TomNisbet/sap-plus/README.md

# SAP-Plus

A Simple As Possible (SAP) computer build using a modular PCB architecture.

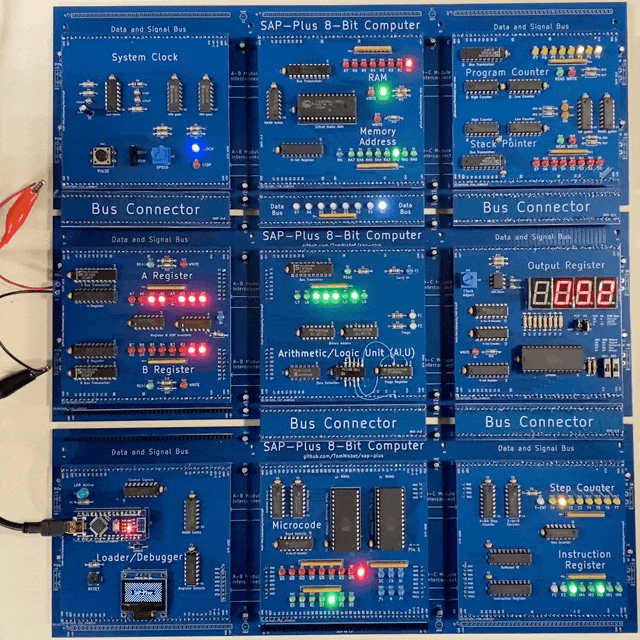
[picture p1: docs/assets/videos/sap-plus.gif]
SAP-Plus Boards SAP-Plus


Visit the [SAP-Plus documentation pages](https://tomnisbet.github.io/sap-plus/) for detailed design notes and schematics.
