TomNisbet/sap-plus/schematics/loader/README.md

# Arduino Loader and Debugger Module schematics

created with KiCad 8.0

## Changelog

### 1.2

* Change OLED power to 3.3V and add pullup resistors on SDA and SCL

### 1.1

* Fix U2 label to 7400 NAND, not 7408 AND
* Adjust OLED display footprint and position
* Add interconnect label to Microcode
* Change reset button from 6mm to 12mm size

### 1.0

* Initial version
