TomNisbet/sap-plus/schematics/template/README.md

# Module Template schematics

created with KiCad 8.0

The template project can be copied as a starting point to create a new module board. The blank template board can also be used for breadboard prototyping.

## Changelog

### 1.0

* Initial version
