TomNisbet/sap-plus/schematics/alu/README.md

# ALU Module schematics

created with KiCad 8.0

## Changelog

### 1.1

* Add FL LED
* Fix carry in LED polarity
* Fix non-inverted FL signal by replacing 3-inout AND with NAND, inverting zero-detect with second gate, and using the third to fix FL
* Add module interconnect labels to the A/B registers

### 1.0

* Initial version
