TomNisbet/sap-plus/schematics/ir-sc/README.md

# Instruction Register and Step Counter Module schematics

created with KiCad 8.0

## Changelog

### 1.1

* Add WRITE LED to Instruction Register
* Add N LED to Step Counter
* Add Module Interconnect labels

### 1.0

* Initial version
