TomNisbet/sap-plus/schematics/pc-sp/README.md

# Program Counter and Stack Pointer Module schematics

created with KiCad 8.0

## Changelog

### 1.1

* Add PI LED for Program Counter
* Fix mismatched datasheets references on schematic for U4

### 1.0

* Initial version
