TomNisbet/sap-plus/schematics/ab-register/README.md

# A and B Register Module schematics

created with KiCad 8.0

## Changelog

### 1.1

* Fix polarity of BI LED
* Add module interconnect labels
* Add BI text box

### 1.0

* Initial version
