TomNisbet/sap-plus/schematics/ram-mar/README.md

# RAM and Memory Address Register Module schematics

created with KiCad 8.0

## Changelog

### 1.1

* Update resistor network values to match LEDs

### 1.0

* Initial version
