TomNisbet/sap-plus/schematics/microcode/README.md

# Microcode Module schematics

created with KiCad 8.0

## Changelog

### 1.1

* Add labels module interconnect headers

### 1.0

* Initial version
