TomNisbet/sap-plus/schematics/output/README.md

# Output Register Module schematics

created with KiCad 8.0

## Changelog

### 1.0

* Initial version
