TomNisbet/sap-plus/schematics/backplane/README.md

# Backplane schematics

created with KiCad 8.0

## Changelog

### 1.1

* Add barrel connector for power in
* Rotate C1, C2, C8 for consistent orientation

### 1.0

* Initial version
