TomNisbet/sap-plus/schematics/bus-connect/README.md

# Bus Connector schematics

created with KiCad 8.0

## Changelog

### 1.0

* Initial version
