TomNisbet/sap-plus/schematics/bus-leds/README.md

# Bus Connector with LEDs schematics

created with KiCad 8.0

## Changelog

### 1.0

* Initial version
