TomNisbet/sap-plus/schematics/memory-loader-interface/README.md

# Module Template schematics

created with KiCad 8.0

## Changelog

### 1.0

* Initial version
