TomNisbet/sap-plus/docs/_docs/design-400-ir-sc.md

---
title: "Instruction Register and Step Counter"
permalink: /docs/ir-sc/
excerpt: "Instruction Register and Step Counter for the SAP-Plus computer"
---

The Instruction Register (IR) and Step Counter (SC) provide a 12-bit address for the microcode ROMs.  The MA0..MA11 bits are carried on the Interconnect Bus, so the Microcode Module and IR-SC Module must be placed in adjacent backplane slots.

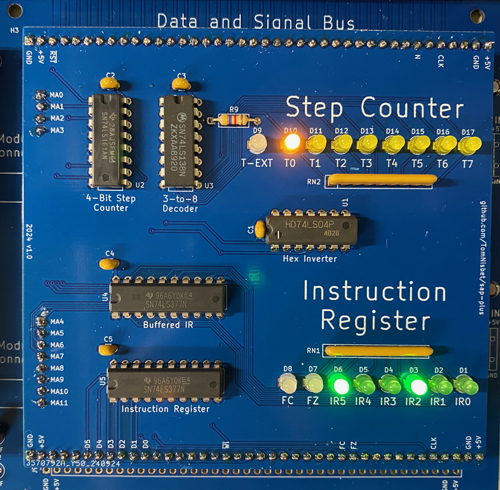
[picture p25: docs/assets/images/ir-sc-module-small.png]
Instruction Register and Step Counter


## Step Counter

The Microcode Step Counter (SC) is a 4-bit binary microinstruction step counter that provides the A0..A3 addresses for the Microcode ROMs.  It counts on the falling edge of every _CLK_ signal.

The SC has an attached 3-to-8 decoder to drive the LED display that indicates the step as T0..T7.  This is easier to follow than a simple binary display using four LEDs.

With a 4-bit counter, an instruction can have as many as sixteen steps, but most have fewer than eight.  Because the higher steps aren't typically used, there is just a single T_EXT LED to indicate that steps T8..T15 are active.  Step T8 is indicated by T-EXT and T0, step T9 by T-EXT and T1, and so on.

### Step Counter implementation and reset

The Step Counter is implemented using a 74LS161 4-bit counter.  This counter can be reset in two ways.  The SAP-Plus _RST_ signal is connected to the reset signal of the counter.  This provides an asychronous reset of the SC whenever _RST_ is pulled low.  This reset does not depend on the _CLK_ signal.  Holding _RST_ low will not only reset the counter, it will also prevent counting until the _RST_ is released.  The Loader uses this to prevent counting during the system self test.

Because most instructions will have fewer than 16 steps, the _N_ signal from the microcode can be used to end an instruction without executing all sixteen microinstruction steps.  The _N_ signal is tied to the 74LS161's Parallel Enable (_PE_) pin and the data inputs are all tied to _GND_.  When _N_ is asserted, the SC will load all zeroes from its data inputs, effectively doing a synchronous reset on the next falling _CLK_ edge.  Instructions with fewer than 16 steps include the _N_ bit in their final microcode step.

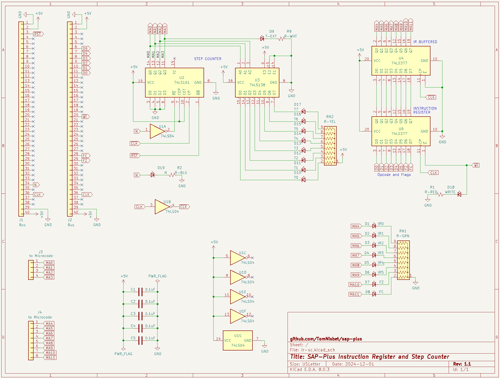
[picture p26: docs/assets/images/ir-sc-schematic-small.png]
Instruction Register and Step Counter schematic


## Instruction Register

The Instruction Register (IR) is an 8-bit, write-only register that loads on the WI signal.  Bits IR0..IR5 are connected to D0..D5 on the data bus, allowing a 6-bit opcode to be loaded from RAM.  This provides 64 unique opcodes.  Bits IR6 and IR7 are connected to the FZ and FC signals from the Flags Register on the ALU Module.  

**NOTE:** The contents of the Flags Register are not moved to the IR until the start of a new instruction, so an instruction's microcode cannot alter its behavior based on the content of a Flags Register that is changed in an earlier microinstruction step.
{: .notice--info}

The IR does not start with a known value after power-up or reset, so the first opcode executed is not deterministic.  This is not a problem, because the first two microinstruction steps of all instructions are identical.  The first step (T0) loads the PC value into the MAR.  The PC is cleared after reset, so the value placed into the MAR will always be zero after reset.  The second microinstruction step (T1) reads the opcode from RAM at adress zero and writes it into the IR.  The IR now has the correct opcode value for the first instruction, so the third microinstruction step (T2) will be executing the correct microcode.

### double buffering

The Instruction Register is double buffered to reduce [glitches when the EEPROM address lines change](../eeprom-glitch/).  In the non-buffered design, the EEPROM outputs will be in an unknown state for about 100ns when the Step Counter address changes on every falling edge of the system clock.  In addition, the outputs will also glitch on the rising edge of the clock at microinstruction step T1 when the IR is loaded with the new opcode.  In a traditional SAP design, the outputs would also glitch on any rising clock edge that changes the Flags Register contents.

The double buffer in SAP-Plus is a second register following the IR register.  The IR loads at the rising CLK edge of every T1 microinstruction step.  The second register loads the contents of the IR and presents them to the ROM address lines on every falling edge.  As a result, the EEPROM address lines only ever change on a falling clock edge, allowing logic that combines ROM signals with a positive clock signal.  Because the two flags register bits are fed through the IR, this also restricts the flag bit changes to the falling clock edge.
