TomNisbet/sap-plus/docs/assets/images/backplane-schematic-small.png

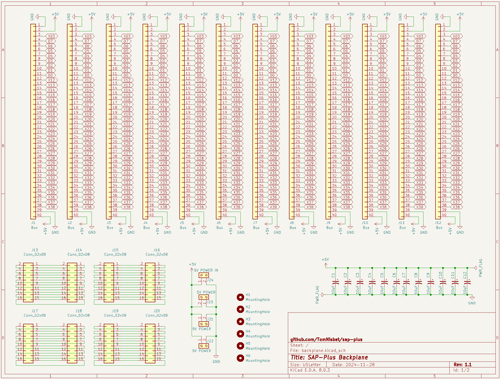
docs/assets/images/backplane-schematic-small.png
