TomNisbet/sap-plus/docs/assets/images/board-box.jpg

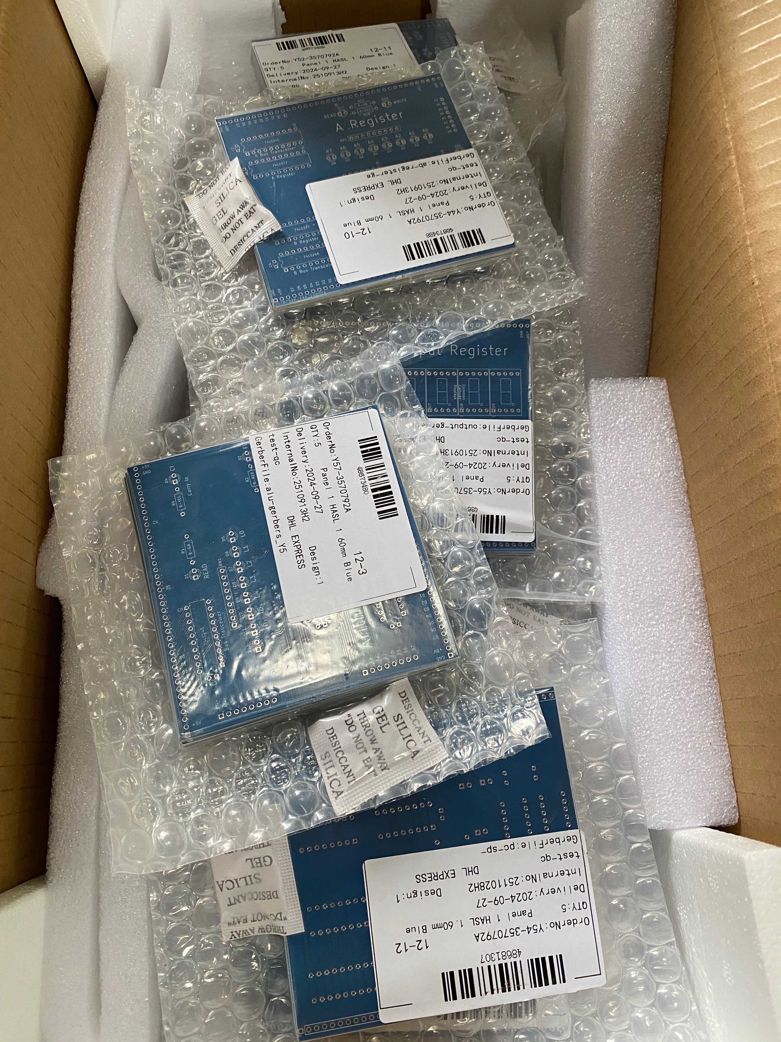
docs/assets/images/board-box.jpg
