TomNisbet/sap-plus/docs/assets/images/boards1.jpg

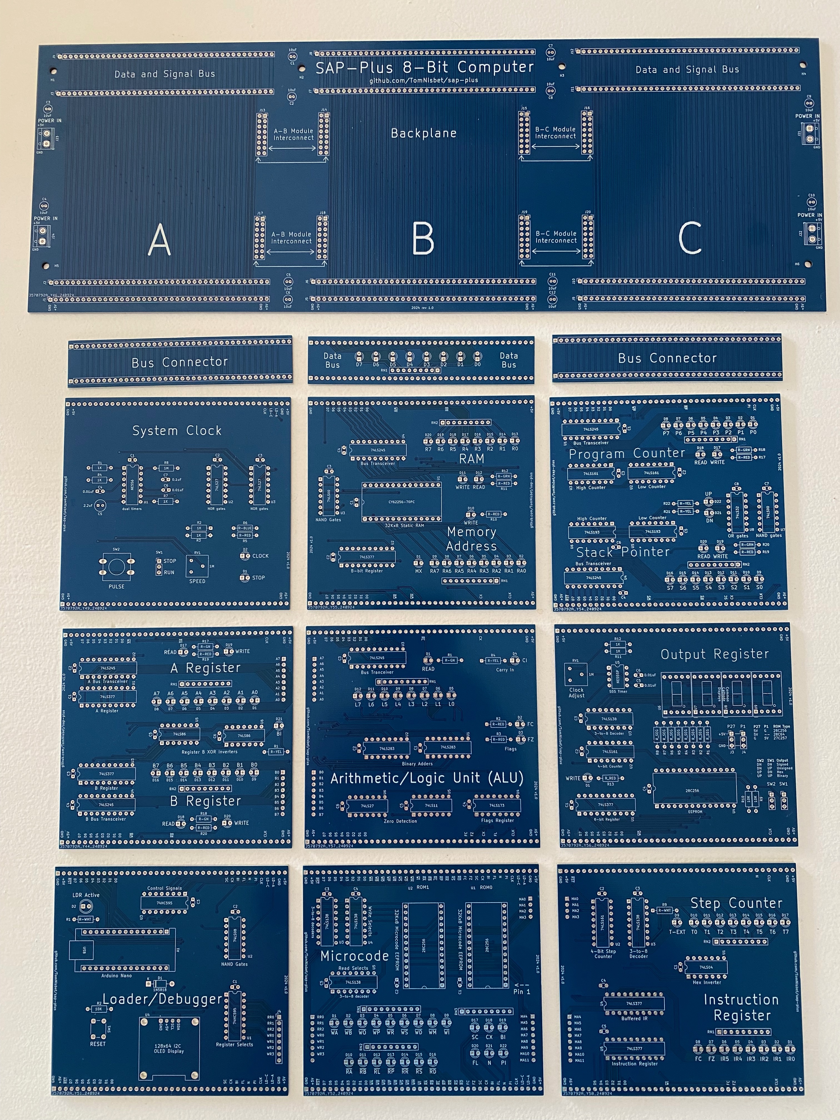
docs/assets/images/boards1.jpg
