TomNisbet/sap-plus/docs/assets/images/clock-module-small.png

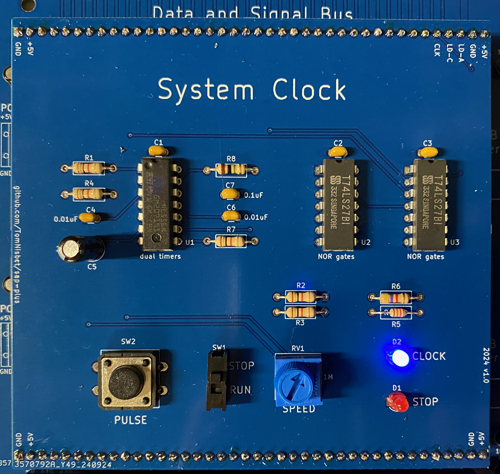
docs/assets/images/clock-module-small.png
