TomNisbet/sap-plus/docs/assets/images/clock-schematic-small.png

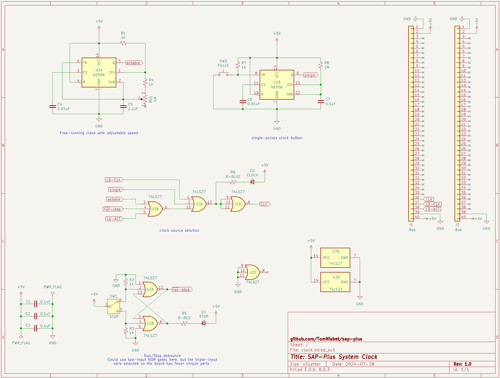
docs/assets/images/clock-schematic-small.png
