TomNisbet/sap-plus/docs/assets/images/loader-module-small.png

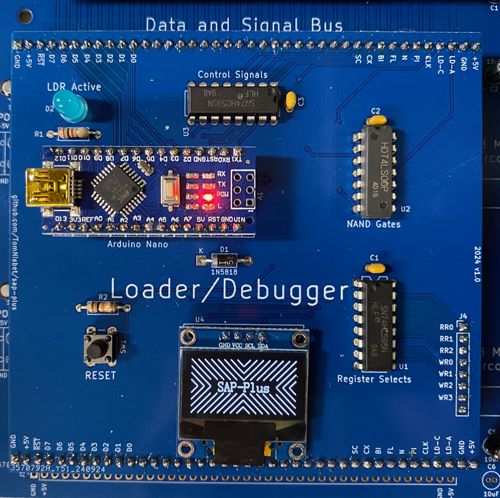
docs/assets/images/loader-module-small.png
