TomNisbet/sap-plus/docs/assets/images/loader-schematic-small.png

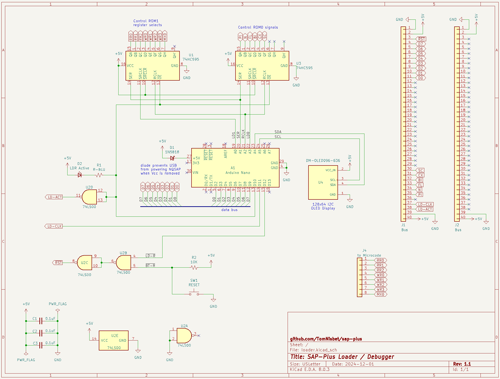
docs/assets/images/loader-schematic-small.png
