TomNisbet/sap-plus/docs/assets/images/logic-clk2-worst.png

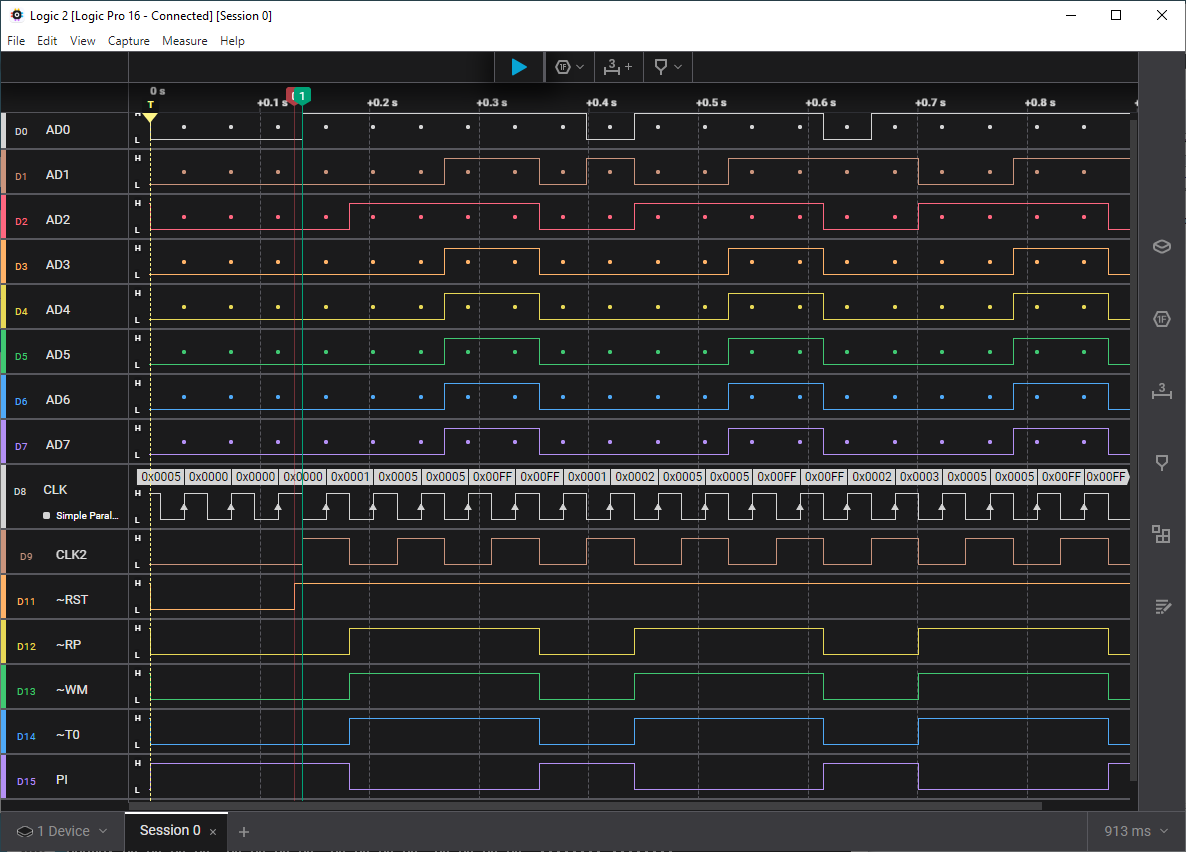
docs/assets/images/logic-clk2-worst.png
