TomNisbet/sap-plus/docs/assets/images/memory-loader-module-small.jpg

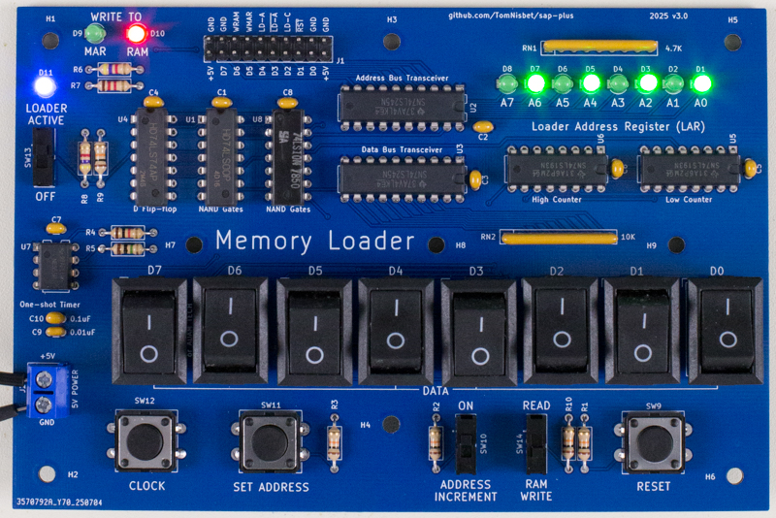
docs/assets/images/memory-loader-module-small.jpg
