TomNisbet/sap-plus/docs/assets/images/oops.jpeg

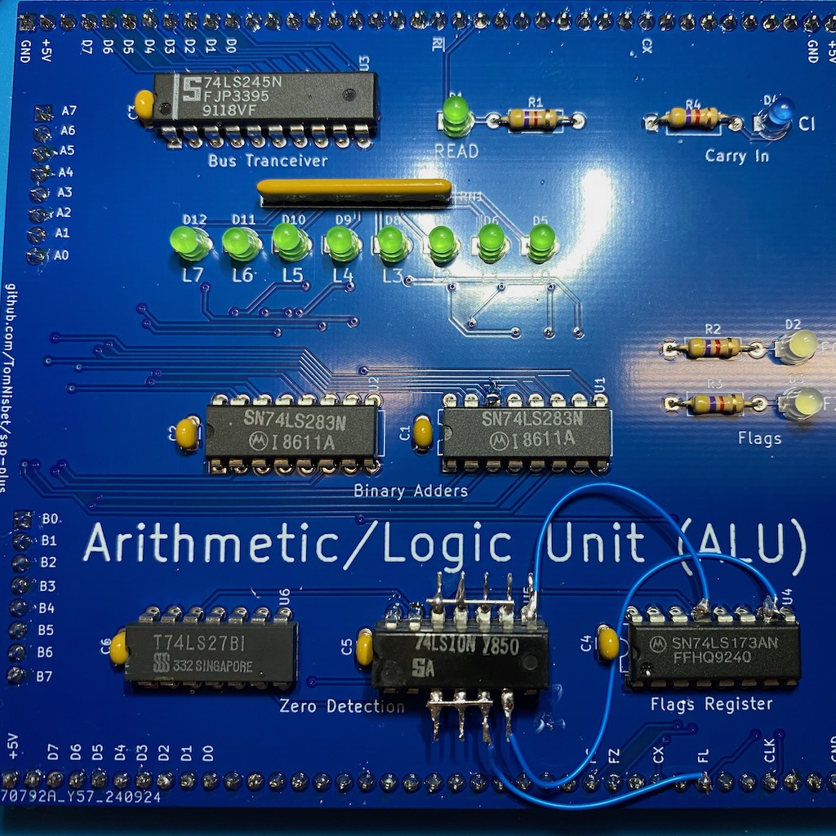
docs/assets/images/oops.jpeg
