TomNisbet/sap-plus/docs/assets/images/output-module-small.png

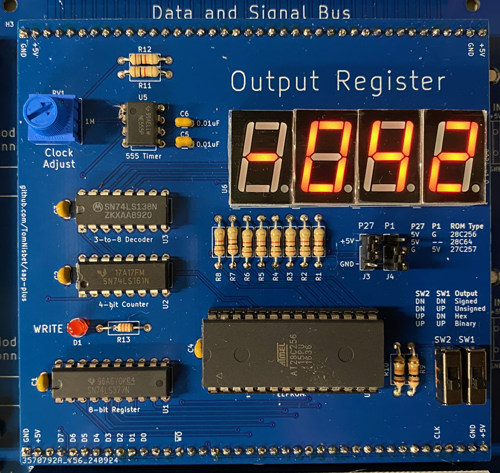
docs/assets/images/output-module-small.png
