TomNisbet/sap-plus/docs/assets/images/output-schematic-small.png

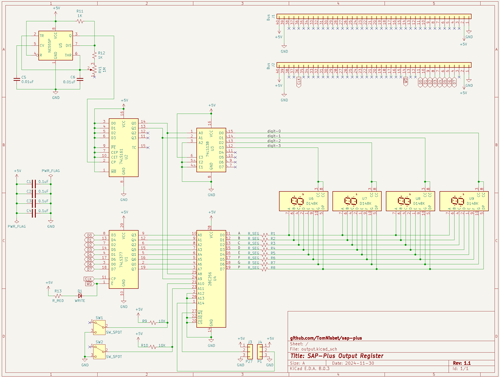
docs/assets/images/output-schematic-small.png
