TomNisbet/sap-plus/docs/assets/images/template-pcb-small.png

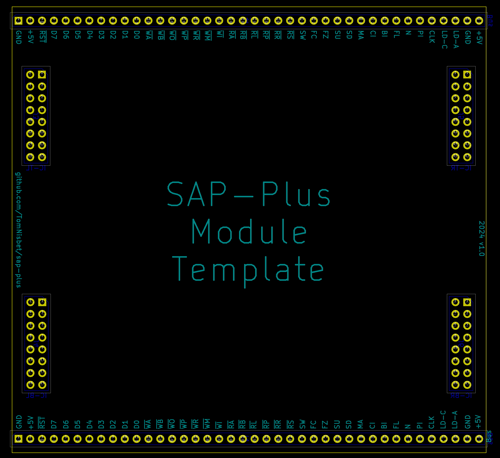
docs/assets/images/template-pcb-small.png
