TomNisbet/sap-plus/docs/assets/images/template-pins-small.png

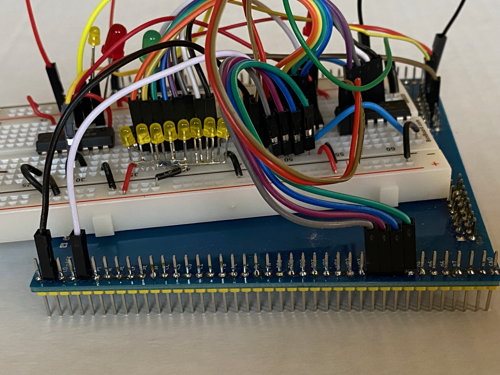
docs/assets/images/template-pins-small.png
