TomNisbet/sap-plus/docs/assets/images/template-prototype-small.png

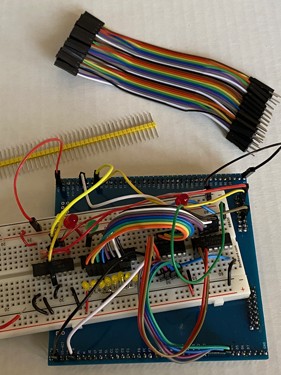
docs/assets/images/template-prototype-small.png
