TomNisbet/sap-plus/docs/assets/images/template-schematic-small.png

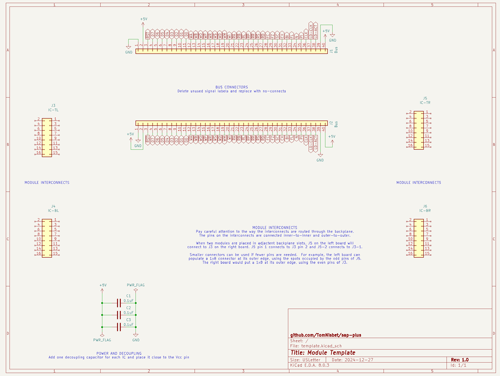
docs/assets/images/template-schematic-small.png
