TomNisbet/sap-plus/docs/assets/images/timing-clk2-low2.png

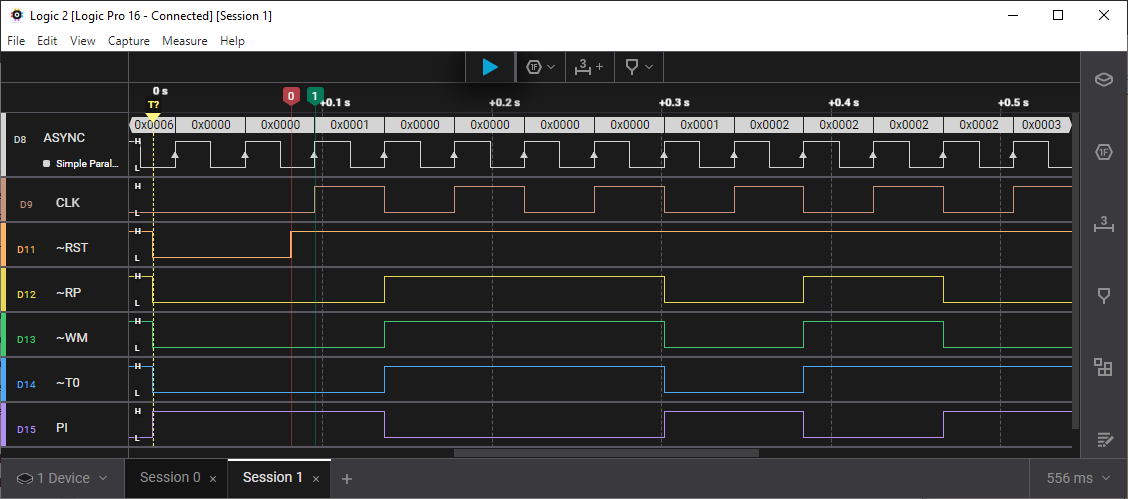
docs/assets/images/timing-clk2-low2.png
