TomNisbet/sap-plus/docs/assets/images/memory-loader-components-small.jpg

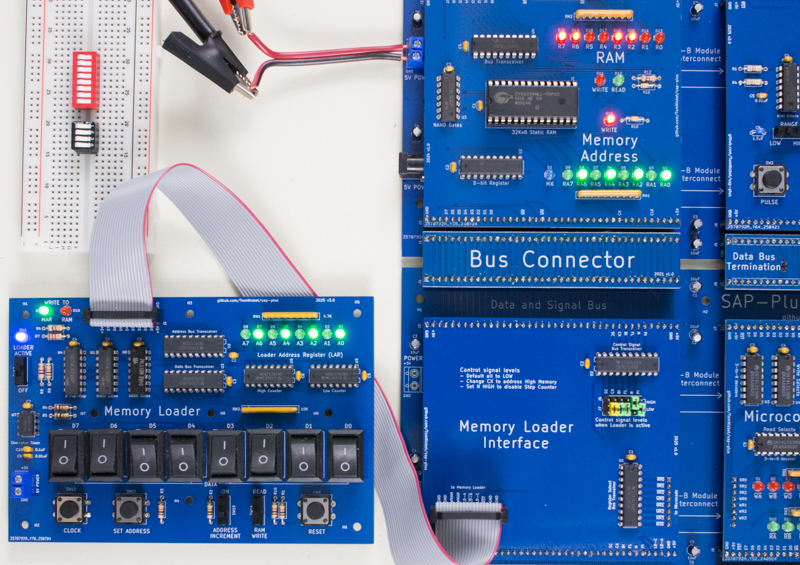
docs/assets/images/memory-loader-components-small.jpg
