TomNisbet/sap-plus/schematics/loader/loader.kicad_pcb

## KiCad design schematics/loader/loader.kicad_pcb (2025-07-20)

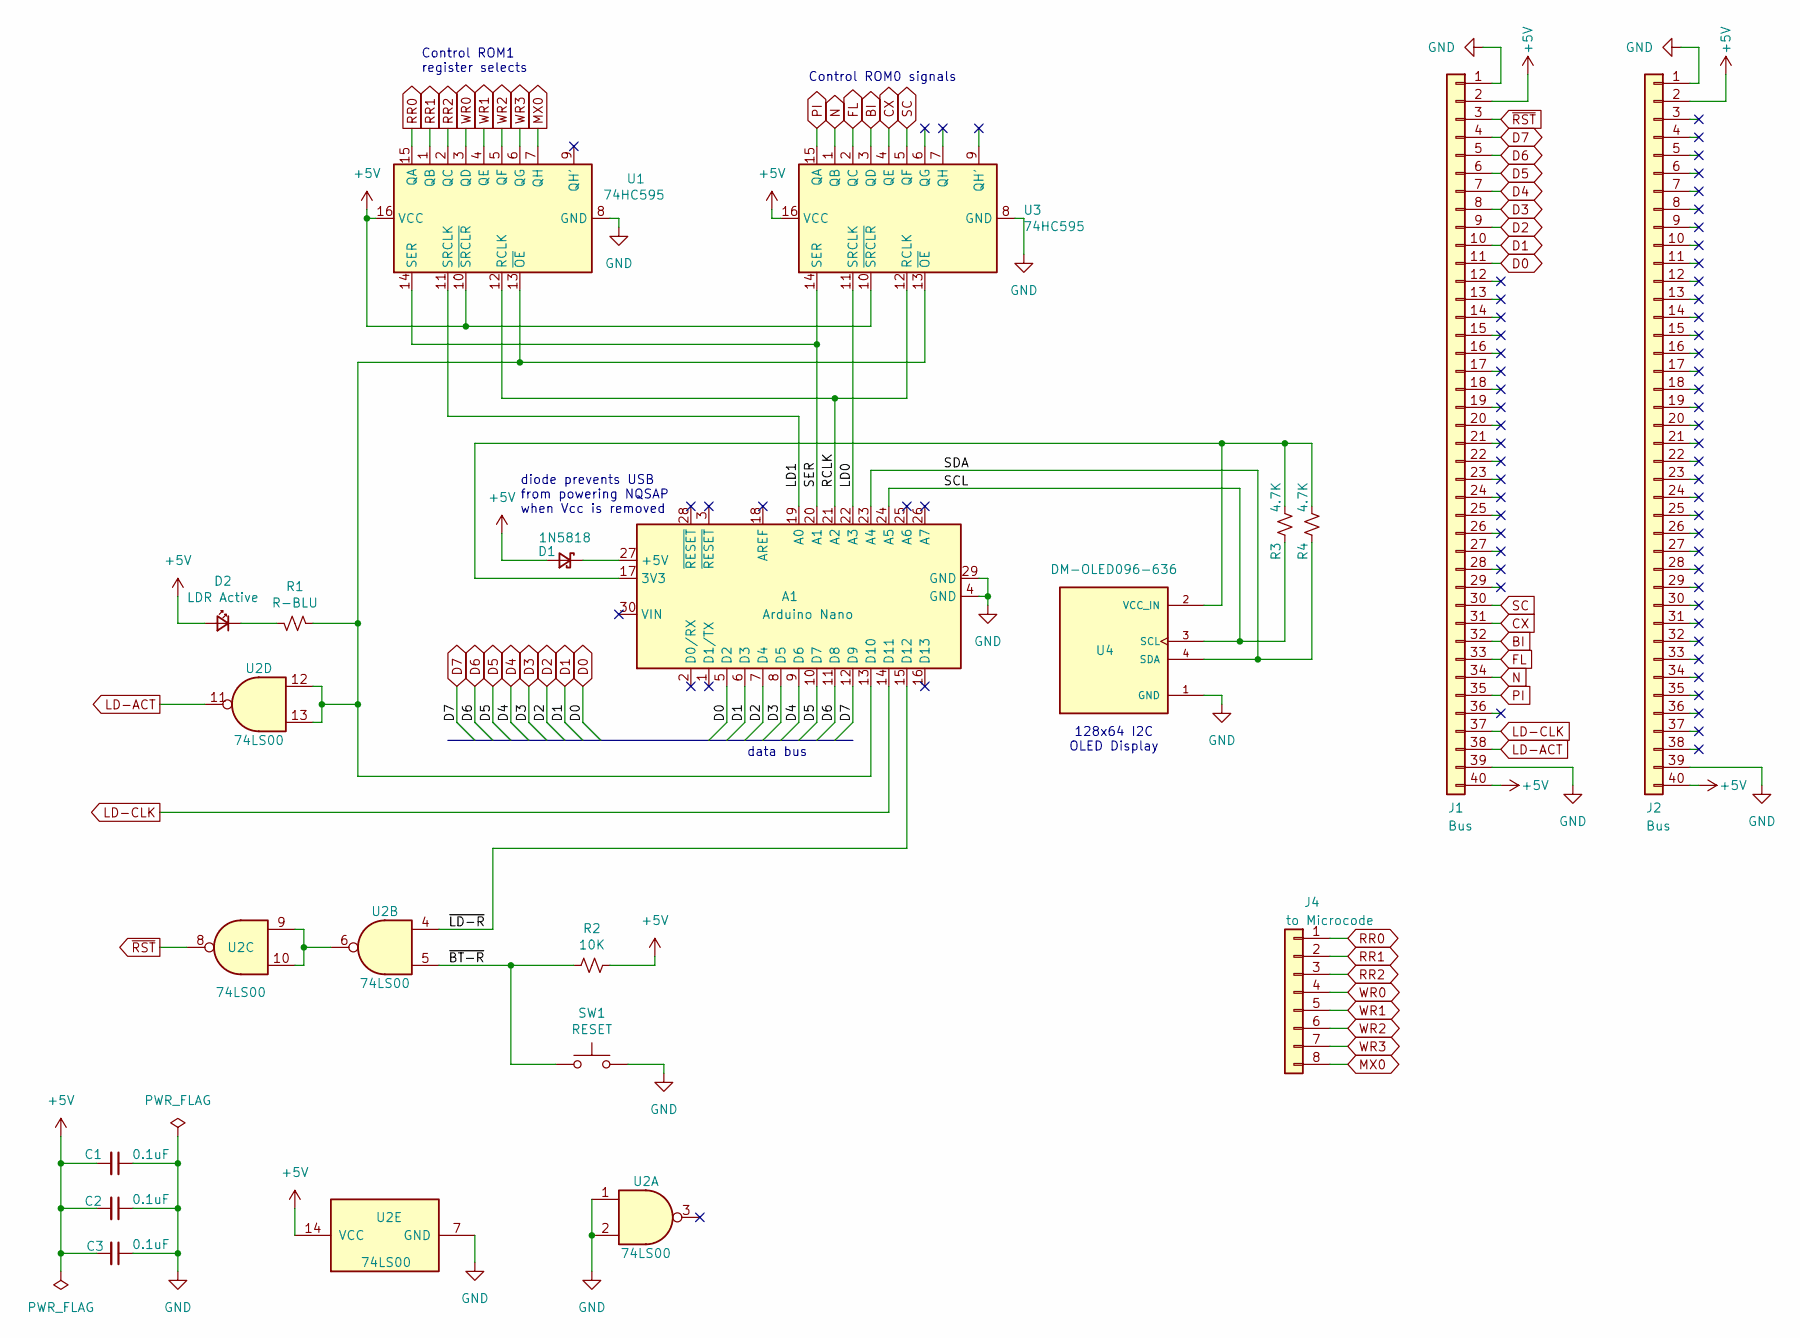
[picture p55: schematic loader.kicad_sch, SAP-Plus Loader / Debugger]

Parts:
A1: Arduino Nano; Arduino_Nano
C1, C2, C3: 0.1uF; C_Disc_D3.0mm_W1.6mm_P2.50mm
D1: 1N5818; D_DO-41_SOD81_P10.16mm_Horizontal
D2: LDR Active; LED_D5.0mm
J1, J2: Bus; PinHeader_1x40_P2.54mm_Vertical
J4: to Microcode; PinHeader_1x08_P2.54mm_Vertical
R1: R-BLU; R_Axial_DIN0207_L6.3mm_D2.5mm_P10.16mm_Horizontal
R2: 10K; R_Axial_DIN0207_L6.3mm_D2.5mm_P10.16mm_Horizontal
R3, R4: 4.7K; R_Axial_DIN0207_L6.3mm_D2.5mm_P10.16mm_Horizontal
SW1: RESET; SW_PUSH-12mm
U1, U3: 74HC595; DIP-16_W7.62mm
U2: 74LS00; DIP-14_W7.62mm
U4: DM-OLED096-636; MODULE_DM-OLED096-636-27; PARTREV 2018-09-10

Connections:
+5V: C1.2, C2.2, C3.2, D1.2 (A), D2.2 (A), J1.2, J1.40, J2.2, J2.40, R2.1, U1.10 (~SRCLR), U1.16 (VCC), U2.14 (VCC), U3.10 (~SRCLR), U3.16 (VCC)
/LD0: A1.22 (A3), U3.11 (SRCLK)
/LD1: A1.19 (A0), U1.11 (SRCLK)
/RCLK: A1.21 (A2), U1.12 (RCLK), U3.12 (RCLK)
/SCL: A1.24 (A5), R3.2, U4.3 (SCL)
/SDA: A1.23 (A4), R4.2, U4.4 (SDA)
/SER: A1.20 (A1), U1.14 (SER), U3.14 (SER)
/~BT-R: R2.2, SW1.2, U2.5
/~LD-R: A1.15 (D12), U2.4
BI: J1.32, U3.3 (QD)
CX: J1.31, U3.4 (QE)
D0: A1.5 (D2), J1.11
D1: A1.6 (D3), J1.10
D2: A1.7 (D4), J1.9
D3: A1.8 (D5), J1.8
D4: A1.9 (D6), J1.7
D5: A1.10 (D7), J1.6
D6: A1.11 (D8), J1.5
D7: A1.12 (D9), J1.4
FL: J1.33, U3.2 (QC)
GND: A1.4 (GND), A1.29 (GND), C1.1, C2.1, C3.1, J1.1, J1.39, J2.1, J2.39, SW1.1, U1.8 (GND), U2.1, U2.2, U2.7 (GND), U3.8 (GND), U4.1 (GND)
LD-ACT: J1.38, U2.11
LD-CLK: A1.14 (D11), J1.37
MX0: J4.8, U1.7 (QH)
N: J1.34, U3.1 (QB)
unnamed: A1.17 (3V3), R3.1, R4.1, U4.2 (VCC_IN)
unnamed: A1.27 (+5V), D1.1 (K)
unnamed: A1.13 (D10), R1.2, U1.13 (~OE), U2.12, U2.13, U3.13 (~OE)
unnamed: D2.1 (K), R1.1
unnamed: U2.6, U2.9, U2.10
PI: J1.35, U3.15 (QA)
RR0: J4.1, U1.15 (QA)
RR1: J4.2, U1.1 (QB)
RR2: J4.3, U1.2 (QC)
SC: J1.30, U3.5 (QF)
WR0: J4.4, U1.3 (QD)
WR1: J4.5, U1.4 (QE)
WR2: J4.6, U1.5 (QF)
WR3: J4.7, U1.6 (QG)
~RST: J1.3, U2.8

Notes on the sheet:
diode prevents USB from powering NQSAP when Vcc is removed
Control ROM1 register selects
Control ROM0 signals
128x64 I2C OLED Display
data bus

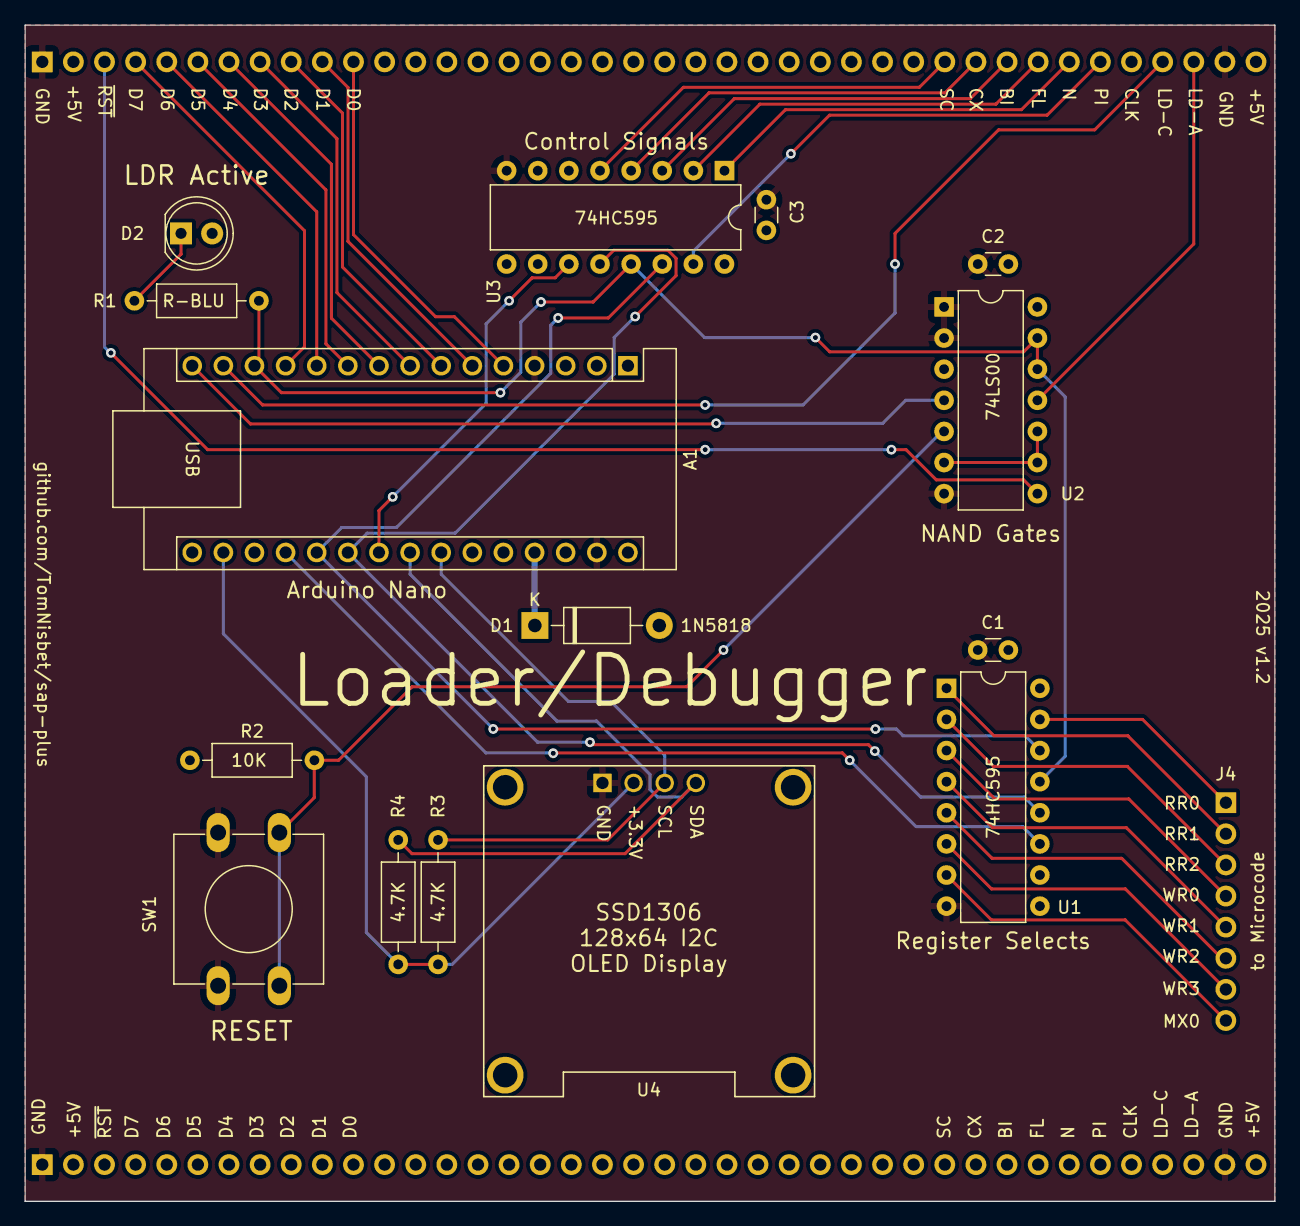
[picture p56: board loader.kicad_pcb from above]

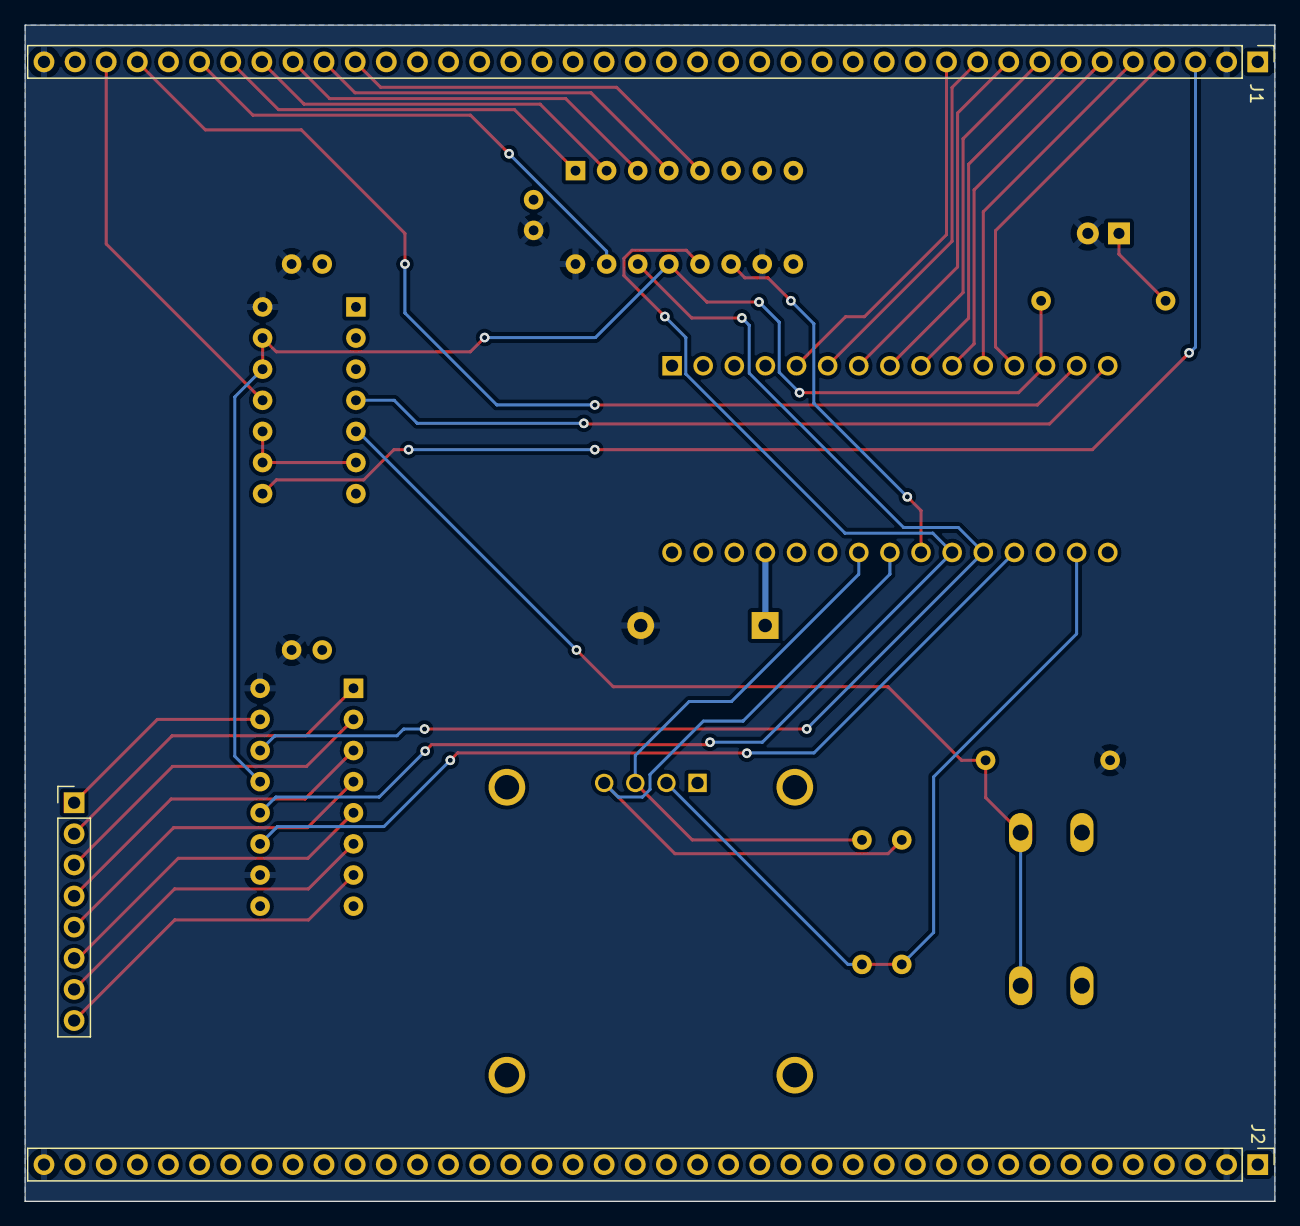
[picture p57: board loader.kicad_pcb from below]

Board: 2 copper layers, 102.0 x 96.0 mm, 18 parts (3 on the bottom side), 40 nets.
