TomNisbet/sap-plus/schematics/memory-loader-interface/memory-loader-interface.kicad_pcb

## KiCad design schematics/memory-loader-interface/memory-loader-interface.kicad_pcb (2025-07-17)

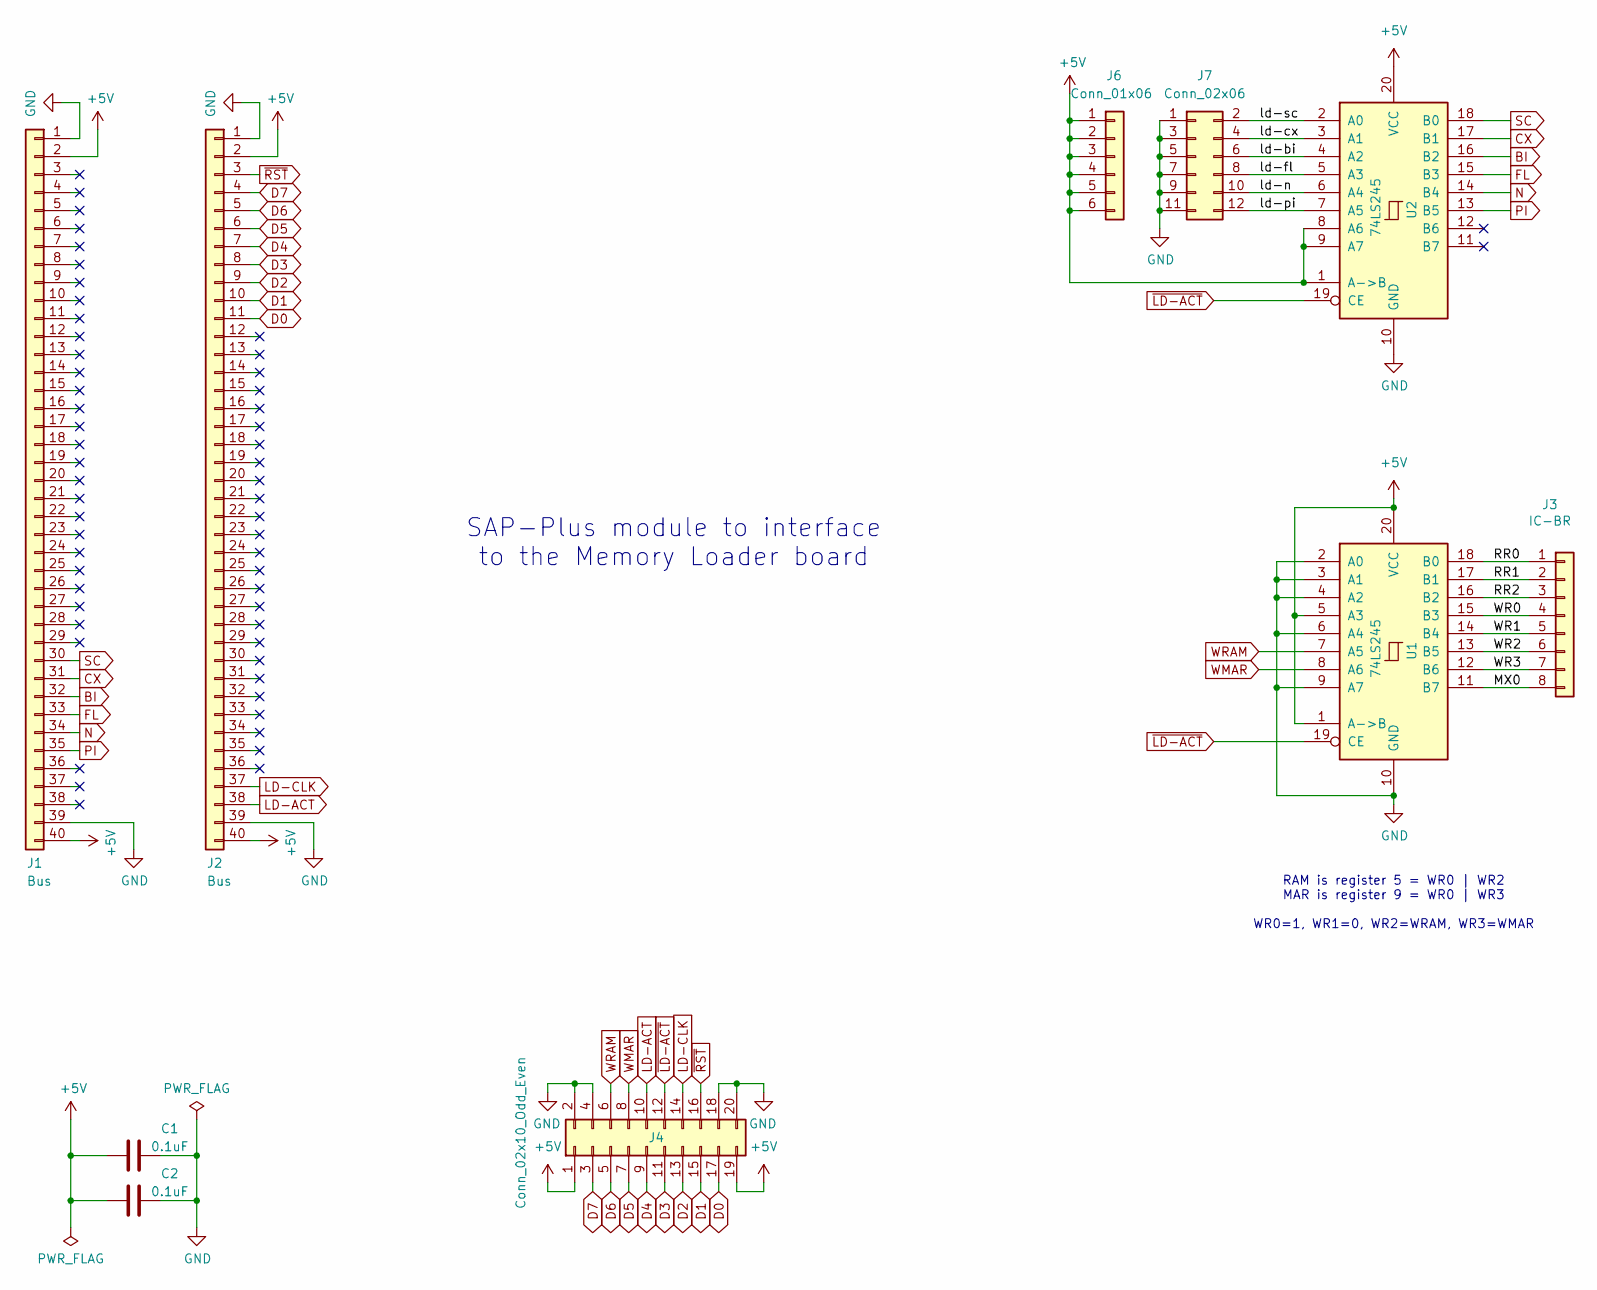
[picture p58: schematic memory-loader-interface.kicad_sch, Memory Loader Interface]

Parts:
C1, C2: 0.1uF; C_Disc_D3.0mm_W1.6mm_P2.50mm
J1, J2: Bus; PinHeader_1x40_P2.54mm_Vertical
J3: IC-BR; PinHeader_1x08_P2.54mm_Vertical
J4: Conn_02x10_Odd_Even; PinHeader_2x10_P2.54mm_Vertical
J6: Conn_01x06; PinHeader_1x06_P2.54mm_Vertical
J7: Conn_02x06; PinHeader_2x06_P2.54mm_Vertical
U1, U2: 74LS245; DIP-20_W7.62mm

Connections:
+5V: C1.2, C2.2, J1.2, J1.40, J2.2, J2.40, J4.1, J4.19, J6.1, J6.2, J6.3, J6.4, J6.5, J6.6, U1.1 (A->B), U1.5 (A3), U1.20 (VCC), U2.1 (A->B), U2.8 (A6), U2.9 (A7), U2.20 (VCC)
/MX0: J3.8, U1.11 (B7)
/RR0: J3.1, U1.18 (B0)
/RR1: J3.2, U1.17 (B1)
/RR2: J3.3, U1.16 (B2)
/WR0: J3.4, U1.15 (B3)
/WR1: J3.5, U1.14 (B4)
/WR2: J3.6, U1.13 (B5)
/WR3: J3.7, U1.12 (B6)
/ld-bi: J7.6, U2.4 (A2)
/ld-cx: J7.4, U2.3 (A1)
/ld-fl: J7.8, U2.5 (A3)
/ld-n: J7.10, U2.6 (A4)
/ld-pi: J7.12, U2.7 (A5)
/ld-sc: J7.2, U2.2 (A0)
BI: J1.32, U2.16 (B2)
CX: J1.31, U2.17 (B1)
D0: J2.11, J4.17
D1: J2.10, J4.15
D2: J2.9, J4.13
D3: J2.8, J4.11
D4: J2.7, J4.9
D5: J2.6, J4.7
D6: J2.5, J4.5
D7: J2.4, J4.3
FL: J1.33, U2.15 (B3)
GND: C1.1, C2.1, J1.1, J1.39, J2.1, J2.39, J4.2, J4.4, J4.18, J4.20, J7.1, J7.3, J7.5, J7.7, J7.9, J7.11, U1.2 (A0), U1.3 (A1), U1.4 (A2), U1.6 (A4), U1.9 (A7), U1.10 (GND), U2.10 (GND)
LD-ACT: J2.38, J4.10
LD-CLK: J2.37, J4.14
N: J1.34, U2.14 (B4)
PI: J1.35, U2.13 (B5)
SC: J1.30, U2.18 (B0)
WMAR: J4.8, U1.8 (A6)
WRAM: J4.6, U1.7 (A5)
~LD-ACT: J4.12, U1.19 (CE), U2.19 (CE)
~RST: J2.3, J4.16

Notes on the sheet:
RAM is register 5 = WR0 | WR2 MAR is register 9 = WR0 | WR3 WR0=1, WR1=0, WR2=WRAM, WR3=WMAR
SAP-Plus module to interface to the Memory Loader board

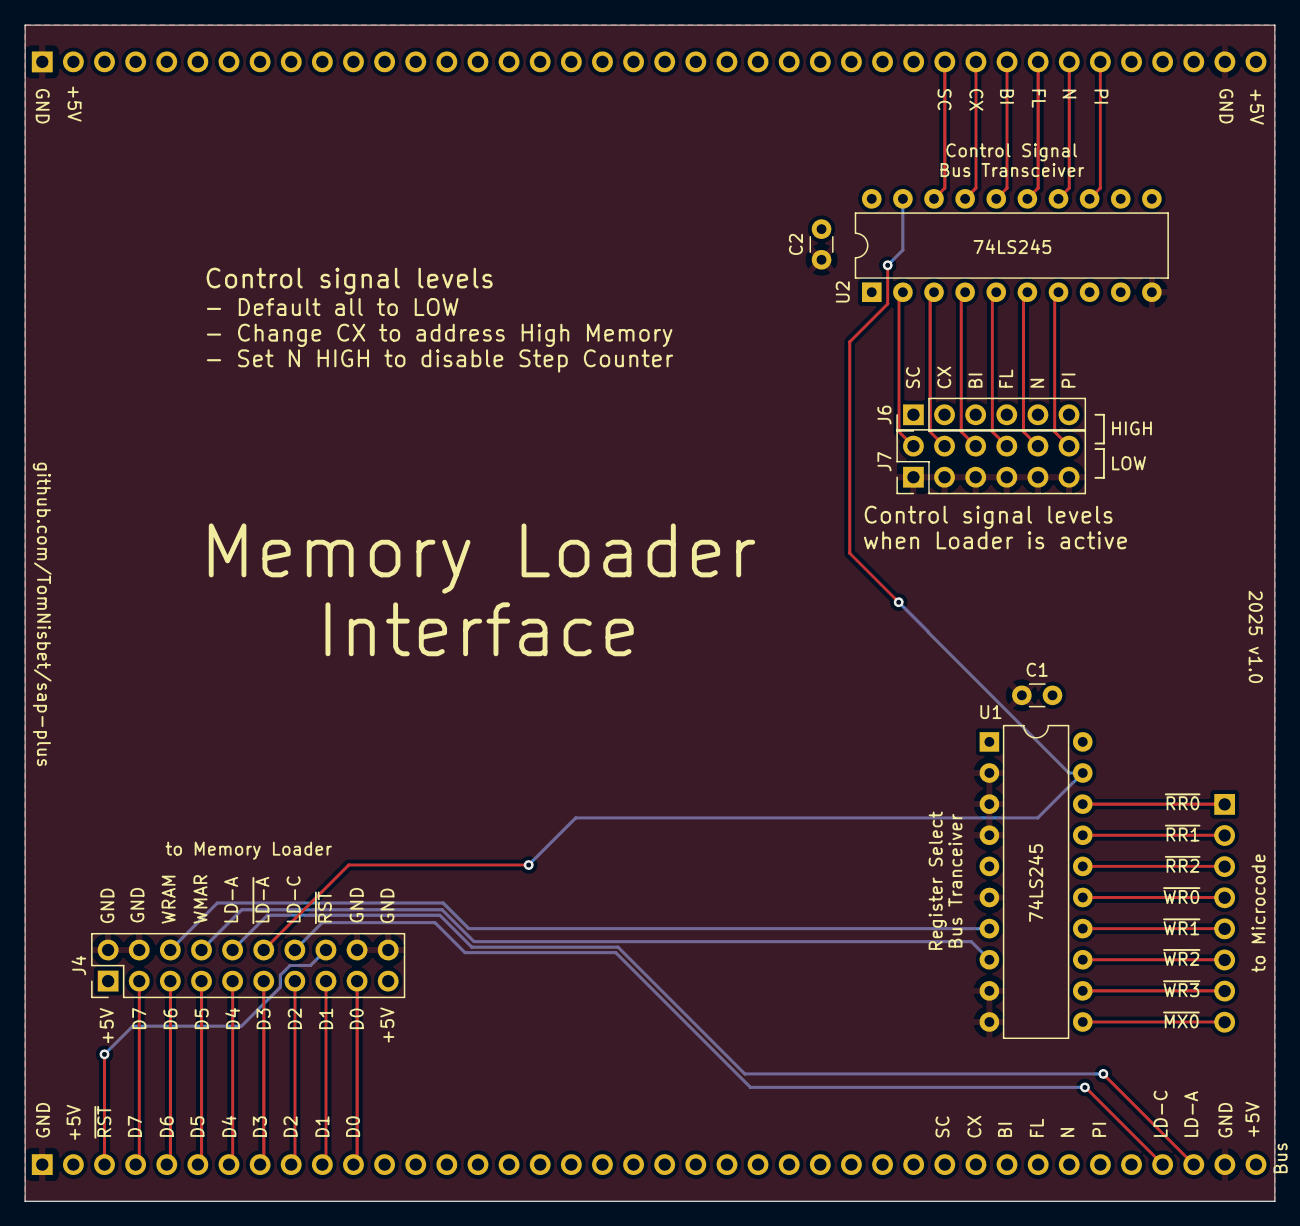
[picture p59: board memory-loader-interface.kicad_pcb from above]

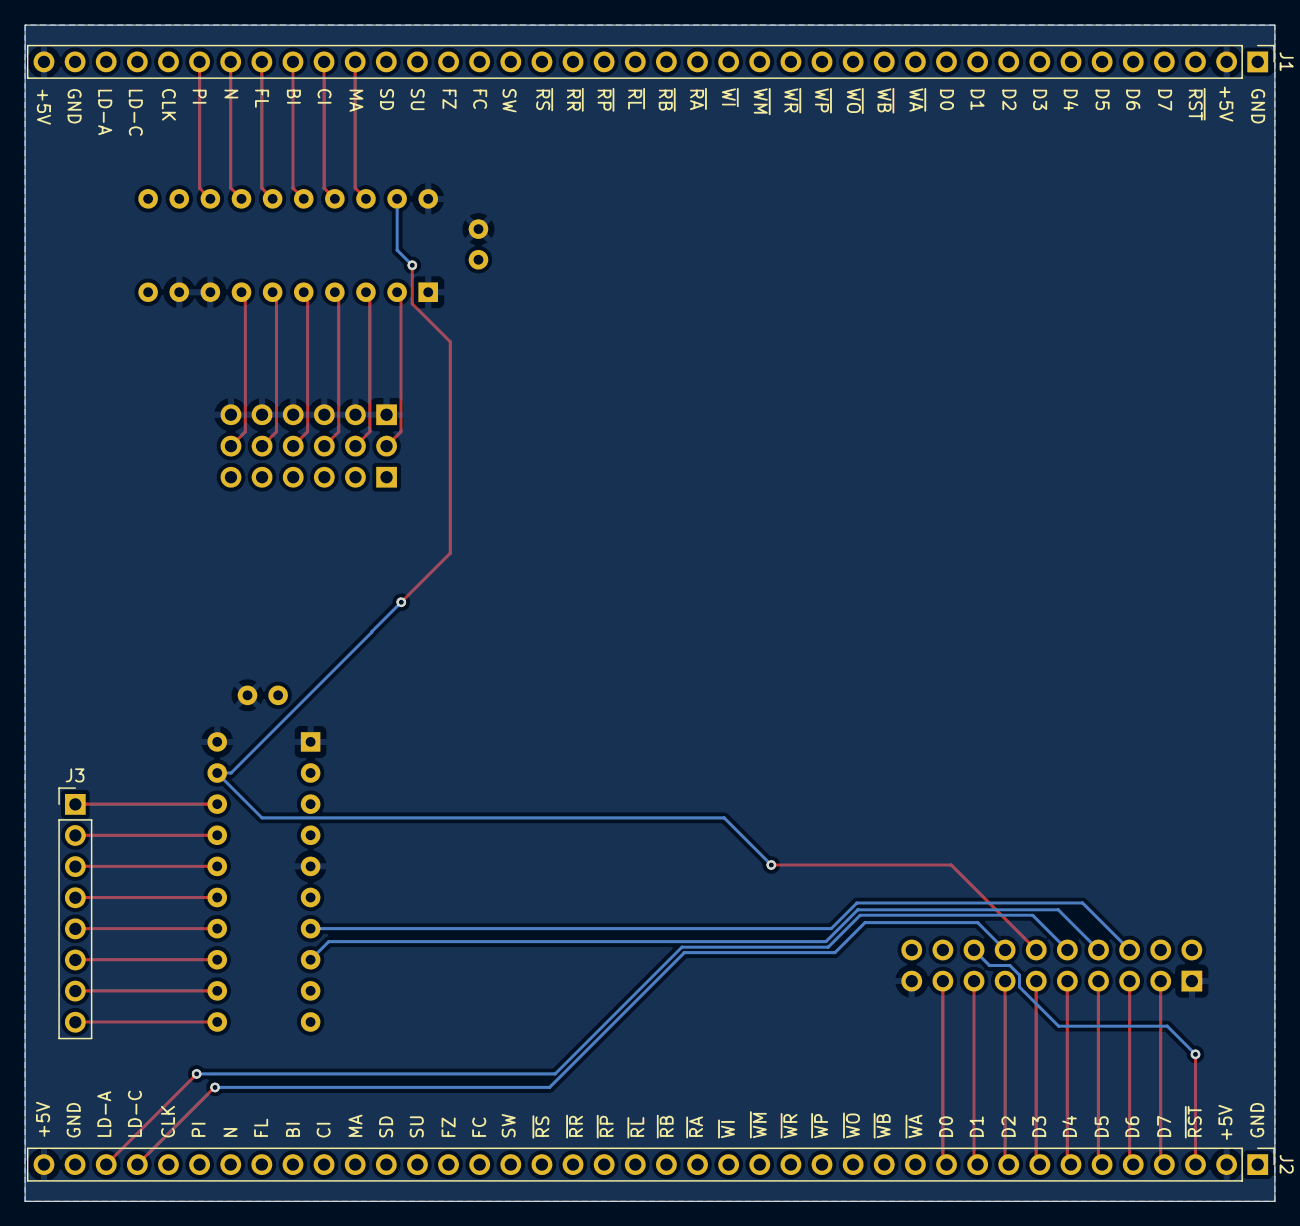
[picture p60: board memory-loader-interface.kicad_pcb from below]

Board: 2 copper layers, 102.0 x 96.0 mm, 10 parts (3 on the bottom side), 36 nets.
