TomNisbet/sap-plus/schematics/memory-loader/memory-loader.kicad_pcb

## KiCad design schematics/memory-loader/memory-loader.kicad_pcb (2025-07-17)

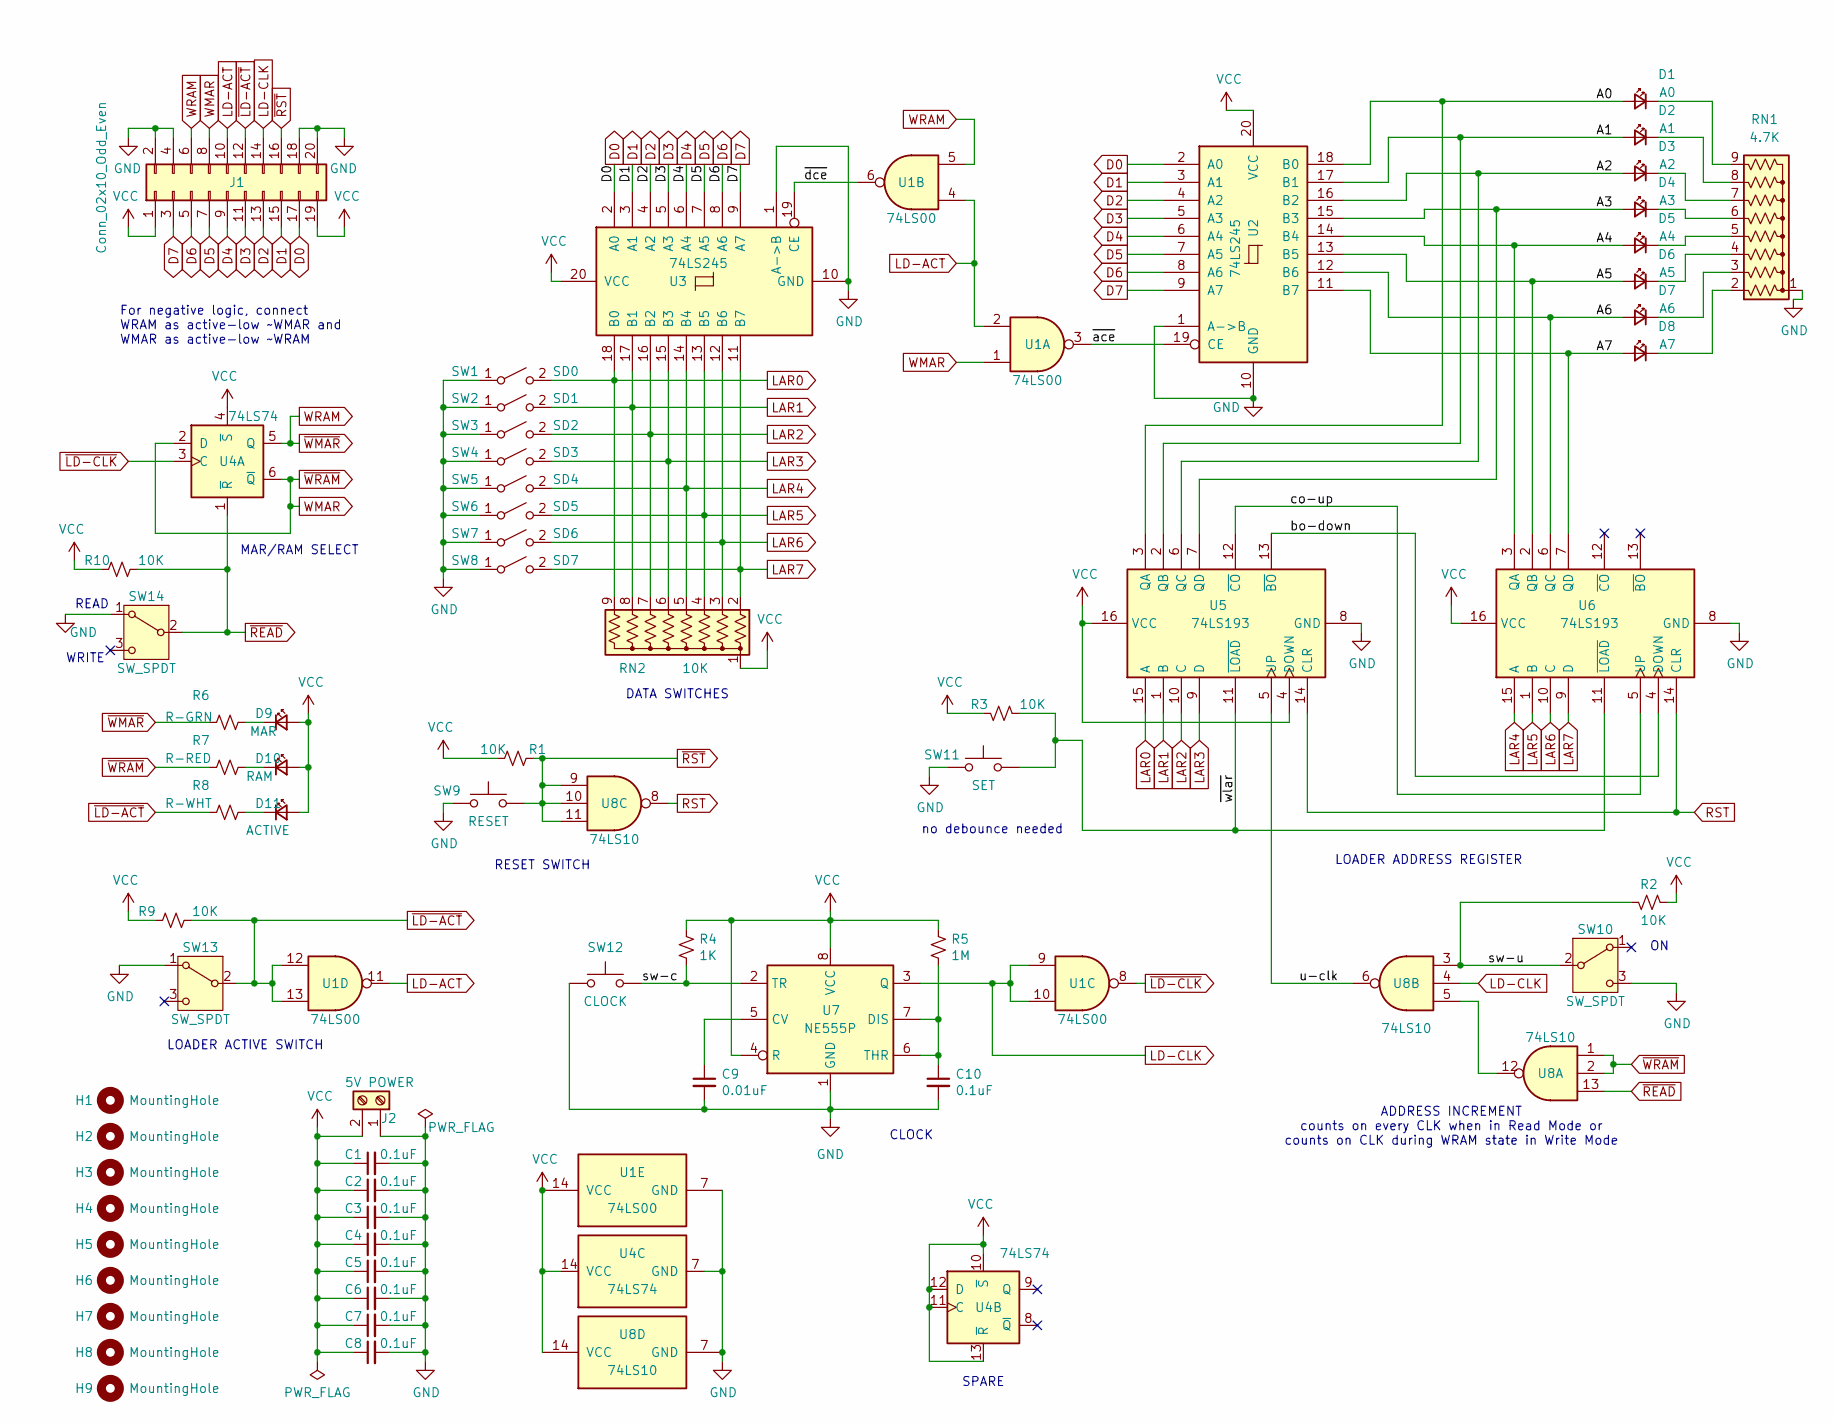
[picture p61: schematic memory-loader.kicad_sch, SAP-Plus Memory Loader]

Parts:
C1, C2, C3, C4, C5, C6, C7, C8, C10: 0.1uF; C_Disc_D3.0mm_W1.6mm_P2.50mm
C9: 0.01uF; C_Disc_D3.0mm_W1.6mm_P2.50mm
D1: A0; LED_D3.0mm
D2: A1; LED_D3.0mm
D3: A2; LED_D3.0mm
D4: A3; LED_D3.0mm
D5: A4; LED_D3.0mm
D6: A5; LED_D3.0mm
D7: A6; LED_D3.0mm
D8: A7; LED_D3.0mm
D9: MAR; LED_D3.0mm
D10: RAM; LED_D3.0mm
D11: ACTIVE; LED_D3.0mm
H1, H2, H3, H4, H5, H6, H7, H8, H9: MountingHole; MountingHole_3.2mm_M3
J1: Conn_02x10_Odd_Even; PinHeader_2x10_P2.54mm_Vertical
J2: 5V POWER; TerminalBlock_RND_205-00012_1x02_P5.00mm_Horizontal
R1, R2, R3, R9, R10: 10K; R_Axial_DIN0207_L6.3mm_D2.5mm_P10.16mm_Horizontal
R4: 1K; R_Axial_DIN0207_L6.3mm_D2.5mm_P10.16mm_Horizontal
R5: 1M; R_Axial_DIN0207_L6.3mm_D2.5mm_P10.16mm_Horizontal
R6: R-GRN; R_Axial_DIN0207_L6.3mm_D2.5mm_P10.16mm_Horizontal
R7: R-RED; R_Axial_DIN0207_L6.3mm_D2.5mm_P10.16mm_Horizontal
R8: R-WHT; R_Axial_DIN0207_L6.3mm_D2.5mm_P10.16mm_Horizontal
RN1: 4.7K; R_Array_SIP9
RN2: 10K; R_Array_SIP9
SW1: SD0; RockerSwitch CIT RA-14xxxxC
SW2: SD1; RockerSwitch CIT RA-14xxxxC
SW3: SD2; RockerSwitch CIT RA-14xxxxC
SW4: SD3; RockerSwitch CIT RA-14xxxxC
SW5: SD4; RockerSwitch CIT RA-14xxxxC
SW6: SD5; RockerSwitch CIT RA-14xxxxC
SW7: SD6; RockerSwitch CIT RA-14xxxxC
SW8: SD7; RockerSwitch CIT RA-14xxxxC
SW9: RESET; SW_PUSH-12mm_Wuerth-430476085716
SW10, SW13, SW14: SW_SPDT; SW_EG1218
SW11: SET; SW_PUSH-12mm_Wuerth-430476085716
SW12: CLOCK; SW_PUSH-12mm
U1: 74LS00; DIP-14_W7.62mm
U2, U3: 74LS245; DIP-20_W7.62mm
U4: 74LS74; DIP-14_W7.62mm
U5, U6: 74LS193; DIP-16_W7.62mm
U7: NE555P; DIP-8_W7.62mm
U8: 74LS10; DIP-14_W7.62mm

Connections:
/A0: D1.2 (A), U2.18 (B0), U5.3 (QA)
/A1: D2.2 (A), U2.17 (B1), U5.2 (QB)
/A2: D3.2 (A), U2.16 (B2), U5.6 (QC)
/A3: D4.2 (A), U2.15 (B3), U5.7 (QD)
/A4: D5.2 (A), U2.14 (B4), U6.3 (QA)
/A5: D6.2 (A), U2.13 (B5), U6.2 (QB)
/A6: D7.2 (A), U2.12 (B6), U6.6 (QC)
/A7: D8.2 (A), U2.11 (B7), U6.7 (QD)
/bo-down: U5.13 (~BO), U6.4 (DOWN)
/co-up: U5.12 (~CO), U6.5 (UP)
/sw-c: R4.2, SW12.2, U7.2 (TR)
/sw-u: R2.1, SW10.2 (B), U8.3
/u-clk: U5.5 (UP), U8.6
/~ace: U1.3, U2.19 (CE)
/~dce: U1.6, U3.19 (CE)
/~wlar: R3.2, SW11.2, U5.11 (~LOAD), U6.11 (~LOAD)
D0: J1.17, U2.2 (A0), U3.2 (A0)
D1: J1.15, U2.3 (A1), U3.3 (A1)
D2: J1.13, U2.4 (A2), U3.4 (A2)
D3: J1.11, U2.5 (A3), U3.5 (A3)
D4: J1.9, U2.6 (A4), U3.6 (A4)
D5: J1.7, U2.7 (A5), U3.7 (A5)
D6: J1.5, U2.8 (A6), U3.8 (A6)
D7: J1.3, U2.9 (A7), U3.9 (A7)
GND: C1.2, C2.2, C3.2, C4.2, C5.2, C6.2, C7.2, C8.2, C9.2, C10.2, J1.2, J1.4, J1.18, J1.20, J2.1, RN1.1 (common), SW1.1 (A), SW2.1 (A), SW3.1 (A), SW4.1 (A), SW5.1 (A), SW6.1 (A), SW7.1 (A), SW8.1 (A), SW9.1, SW10.3 (C), SW11.1, SW12.1, SW13.1 (A), SW14.1 (A), U1.7 (GND), U2.1 (A->B), U2.10 (GND), U3.1 (A->B), U3.10 (GND), U4.7 (GND), U5.8 (GND), U6.8 (GND), U7.1 (GND), U8.7 (GND)
LAR0: RN2.9 (R8), SW1.2 (B), U3.18 (B0), U5.15 (A)
LAR1: RN2.8 (R7), SW2.2 (B), U3.17 (B1), U5.1 (B)
LAR2: RN2.7 (R6), SW3.2 (B), U3.16 (B2), U5.10 (C)
LAR3: RN2.6 (R5), SW4.2 (B), U3.15 (B3), U5.9 (D)
LAR4: RN2.5 (R4), SW5.2 (B), U3.14 (B4), U6.15 (A)
LAR5: RN2.4 (R3), SW6.2 (B), U3.13 (B5), U6.1 (B)
LAR6: RN2.3 (R2), SW7.2 (B), U3.12 (B6), U6.10 (C)
LAR7: RN2.2 (R1), SW8.2 (B), U3.11 (B7), U6.9 (D)
LD-ACT: J1.10, U1.2, U1.4, U1.11
LD-CLK: J1.14, U1.9, U1.10, U7.3 (Q), U8.4
unnamed: D1.1 (K), RN1.9 (R8)
unnamed: D2.1 (K), RN1.8 (R7)
unnamed: D3.1 (K), RN1.7 (R6)
unnamed: D4.1 (K), RN1.6 (R5)
unnamed: D5.1 (K), RN1.5 (R4)
unnamed: D6.1 (K), RN1.4 (R3)
unnamed: D7.1 (K), RN1.3 (R2)
unnamed: D8.1 (K), RN1.2 (R1)
unnamed: D9.1 (K), R6.1
unnamed: D10.1 (K), R7.1
unnamed: D11.1 (K), R8.1
unnamed: C9.1, U7.5 (CV)
unnamed: C10.1, R5.2, U7.6 (THR), U7.7 (DIS)
unnamed: U8.5, U8.12
RST: U5.14 (CLR), U6.14 (CLR), U8.8
VCC: C1.1, C2.1, C3.1, C4.1, C5.1, C6.1, C7.1, C8.1, D9.2 (A), D10.2 (A), D11.2 (A), J1.1, J1.19, J2.2, R1.2, R2.2, R3.1, R4.1, R5.1, R9.2, R10.2, RN2.1 (common), U1.14 (VCC), U2.20 (VCC), U3.20 (VCC), U4.4 (~S), U4.10 (~S), U4.11 (C), U4.12 (D), U4.13 (~R), U4.14 (VCC), U5.4 (DOWN), U5.16 (VCC), U6.16 (VCC), U7.4 (R), U7.8 (VCC), U8.14 (VCC)
WMAR: J1.8, R7.2, U1.1, U4.2 (D), U4.6 (~Q), U8.1, U8.2
WRAM: J1.6, R6.2, U1.5, U4.5 (Q)
~LD-ACT: J1.12, R8.2, R9.1, SW13.2 (B), U1.12, U1.13
~LD-CLK: U1.8, U4.3 (C)
~READ: R10.1, SW14.2 (B), U4.1 (~R), U8.13
~RST: J1.16, R1.1, SW9.2, U8.9, U8.10, U8.11

Notes on the sheet:
LOADER ADDRESS REGISTER
WRITE
READ
ADDRESS INCREMENT counts on every CLK when in Read Mode or counts on CLK during WRAM state in Write Mode
SPARE
LOADER ACTIVE SWITCH
RESET SWITCH
MAR/RAM SELECT
For negative logic, connect WRAM as active-low ~WMAR and WMAR as active-low ~WRAM
DATA SWITCHES
no debounce needed
CLOCK

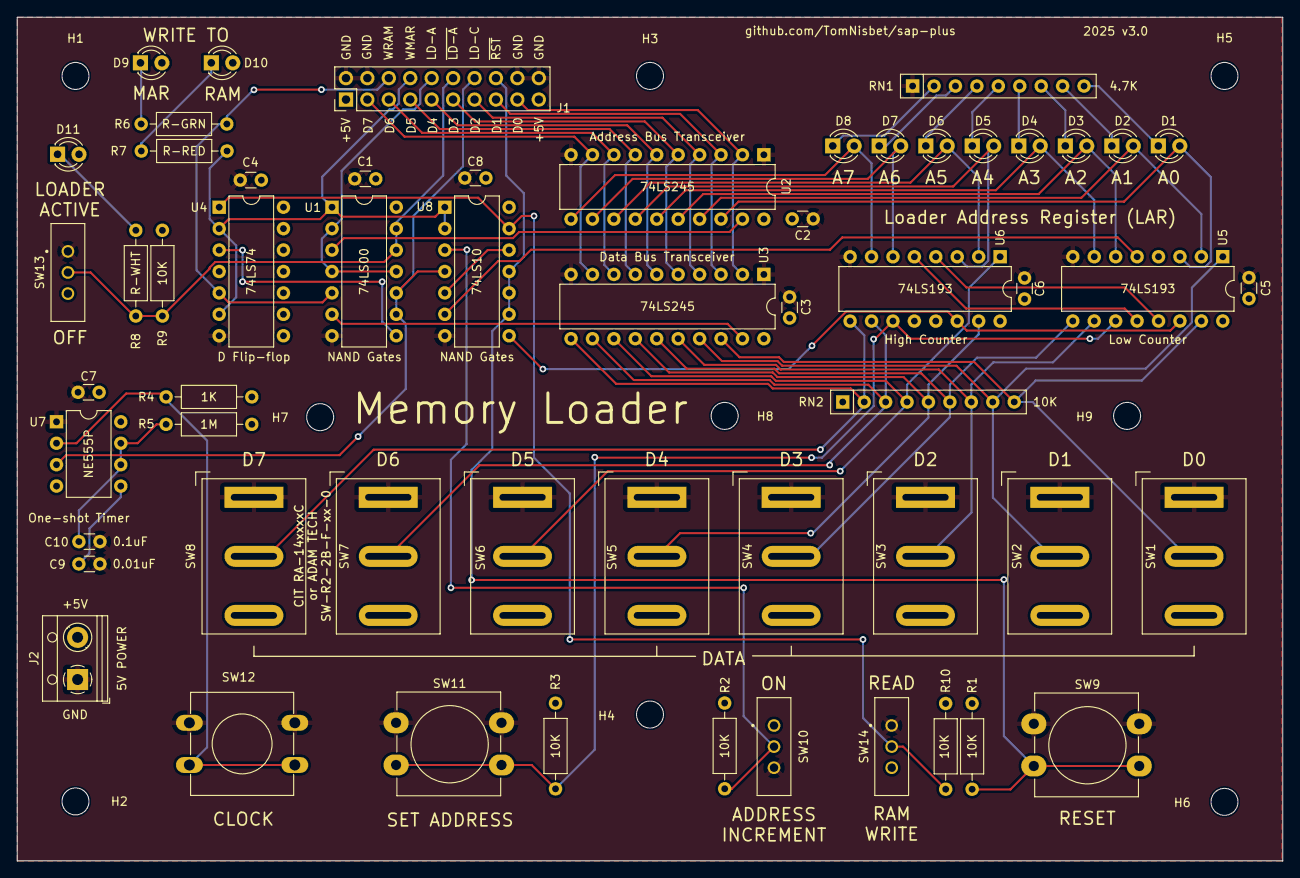
[picture p62: board memory-loader.kicad_pcb from above]

Board: 2 copper layers, 150.0 x 100.0 mm, 66 parts (0 on the bottom side), 57 nets.
