TomNisbet/sap-plus/schematics/clock/clock.kicad_pcb

## KiCad design schematics/clock/clock.kicad_pcb (2025-05-24)

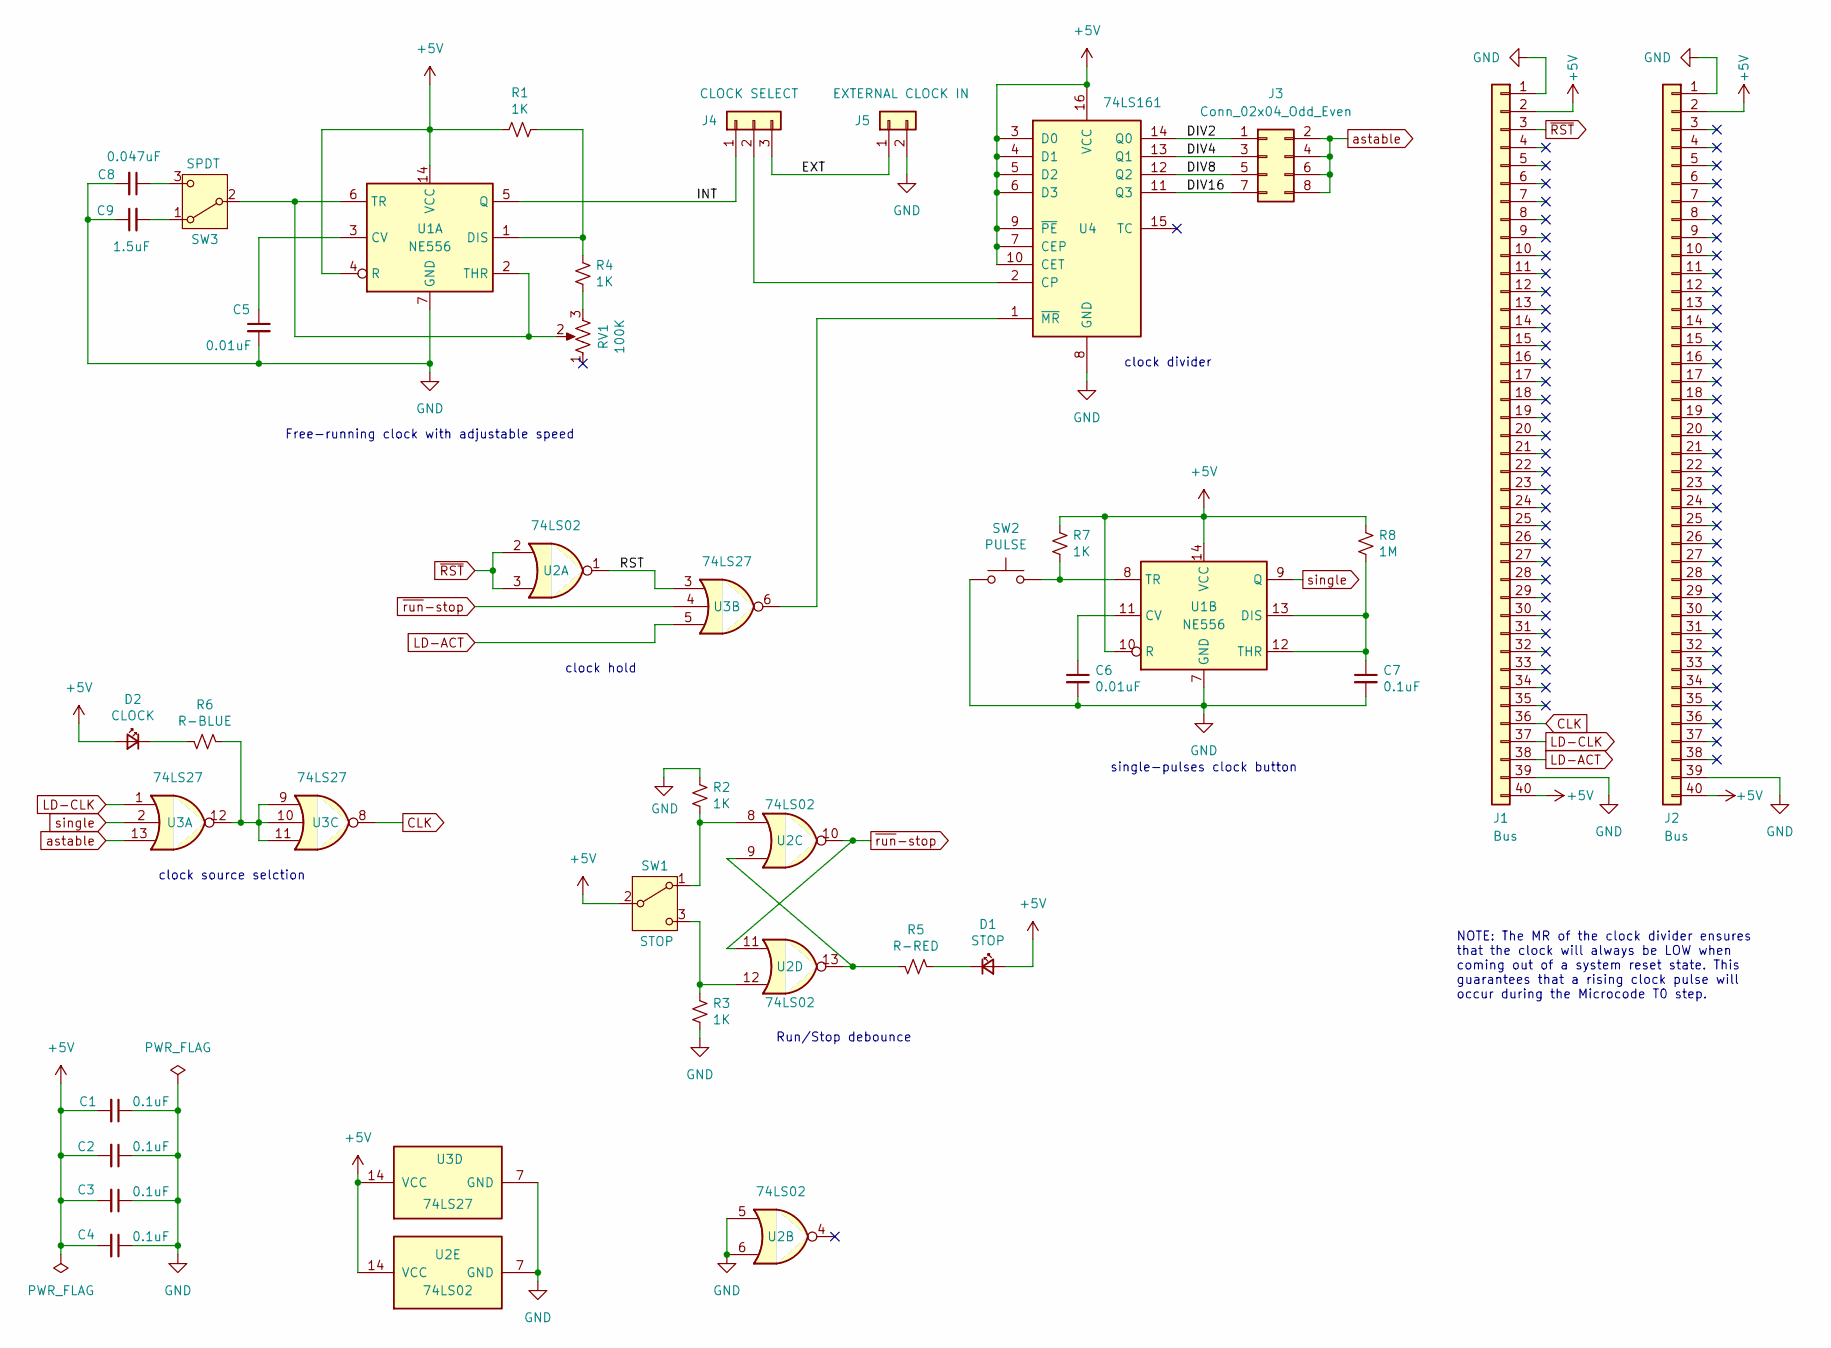
[picture p63: schematic clock.kicad_sch, SAP-Plus System Clock]

Parts:
C1, C2, C3, C4, C7: 0.1uF; C_Disc_D3.0mm_W1.6mm_P2.50mm
C5, C6: 0.01uF; C_Disc_D3.0mm_W1.6mm_P2.50mm
C8: 0.047uF; C_Disc_D4.3mm_W1.9mm_P5.00mm
C9: 1.5uF; C_Disc_D4.3mm_W1.9mm_P5.00mm
D1: STOP; LED_D3.0mm
D2: CLOCK; LED_D3.0mm
J1, J2: Bus; PinHeader_1x40_P2.54mm_Vertical
J3: Conn_02x04_Odd_Even; PinHeader_2x04_P2.54mm_Vertical
J4: CLOCK SELECT; PinHeader_1x03_P2.54mm_Vertical
J5: EXTERNAL CLOCK IN; PinHeader_1x02_P2.54mm_Vertical
R1, R2, R3, R4, R7: 1K; R_Axial_DIN0207_L6.3mm_D2.5mm_P10.16mm_Horizontal
R5: R-RED; R_Axial_DIN0207_L6.3mm_D2.5mm_P10.16mm_Horizontal
R6: R-BLUE; R_Axial_DIN0207_L6.3mm_D2.5mm_P10.16mm_Horizontal
R8: 1M; R_Axial_DIN0207_L6.3mm_D2.5mm_P10.16mm_Horizontal
RV1: 100K; Potentiometer_Bourns_3386P_Vertical
SW1: STOP; SW_EG1218
SW2: PULSE; SW_PUSH-12mm_Wuerth-430476085716
SW3: SPDT; SW_EG1218
U1: NE556; DIP-14_W7.62mm
U2: 74LS02; DIP-14_W7.62mm
U3: 74LS27; DIP-14_W7.62mm
U4: 74LS161; DIP-16_W7.62mm

Connections:
+5V: C1.2, C2.2, C3.2, C4.2, D1.2 (A), D2.2 (A), J1.2, J1.40, J2.2, J2.40, R1.2, R7.1, R8.1, SW1.2 (B), U1.4 (R), U1.10 (R), U1.14 (VCC), U2.14 (VCC), U3.14 (VCC), U4.3 (D0), U4.4 (D1), U4.5 (D2), U4.6 (D3), U4.7 (CEP), U4.9 (~PE), U4.10 (CET), U4.16 (VCC)
/DIV2: J3.1, U4.14 (Q0)
/DIV4: J3.3, U4.13 (Q1)
/DIV8: J3.5, U4.12 (Q2)
/DIV16: J3.7, U4.11 (Q3)
/EXT: J4.3, J5.1
/INT: J4.1, U1.5 (Q)
/RST: U2.1, U3.3
CLK: J1.36, U3.8
GND: C1.1, C2.1, C3.1, C4.1, C5.2, C6.2, C7.2, C8.2, C9.1, J1.1, J1.39, J2.1, J2.39, J5.2, R2.1, R3.2, SW2.2, U1.7 (GND), U2.5, U2.6, U2.7 (GND), U3.7 (GND), U4.8 (GND)
LD-ACT: J1.38, U3.5
LD-CLK: J1.37, U3.1
unnamed: D1.1 (K), R5.2
unnamed: D2.1 (K), R6.1
unnamed: J4.2, U4.2 (CP)
unnamed: R4.1, RV1.3
unnamed: R5.1, U2.9, U2.13
unnamed: R6.2, U3.9, U3.10, U3.11, U3.12
unnamed: R2.2, SW1.1 (A), U2.8
unnamed: R3.1, SW1.3 (C), U2.12
unnamed: C9.2, SW3.1 (A)
unnamed: RV1.2, SW3.2 (B), U1.2 (THR), U1.6 (TR)
unnamed: C8.1, SW3.3 (C)
unnamed: C5.1, U1.3 (CV)
unnamed: R1.1, R4.2, U1.1 (DIS)
unnamed: C6.1, U1.11 (CV)
unnamed: C7.1, R8.2, U1.12 (THR), U1.13 (DIS)
unnamed: R7.2, SW2.1, U1.8 (TR)
unnamed: U3.6, U4.1 (~MR)
astable: J3.2, J3.4, J3.6, J3.8, U3.13
single: U1.9 (Q), U3.2
~RST: J1.3, U2.2, U2.3
~run-stop: U2.10, U2.11, U3.4

Notes on the sheet:
NOTE: The MR of the clock divider ensures that the clock will always be LOW when coming out of a system reset state. This guarantees that a rising clock pulse will occur during the Microcode T0 step.
Run/Stop debounce
clock source selction
Free-running clock with adjustable speed
clock hold
clock divider
single-pulses clock button

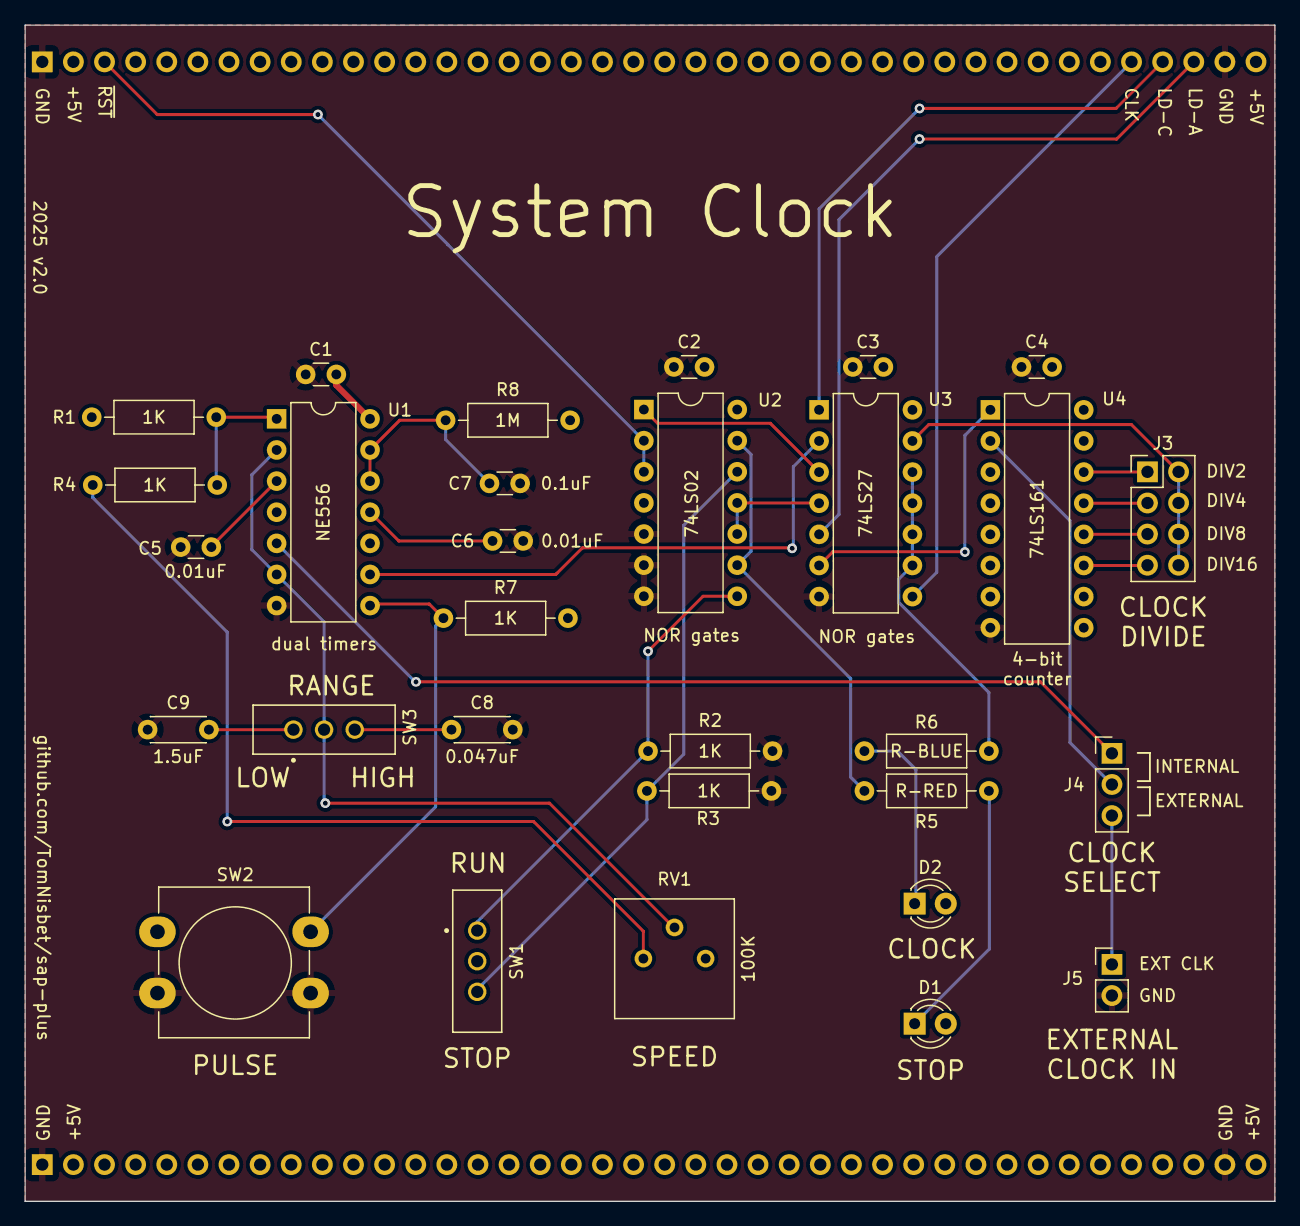
[picture p64: board clock.kicad_pcb from above]

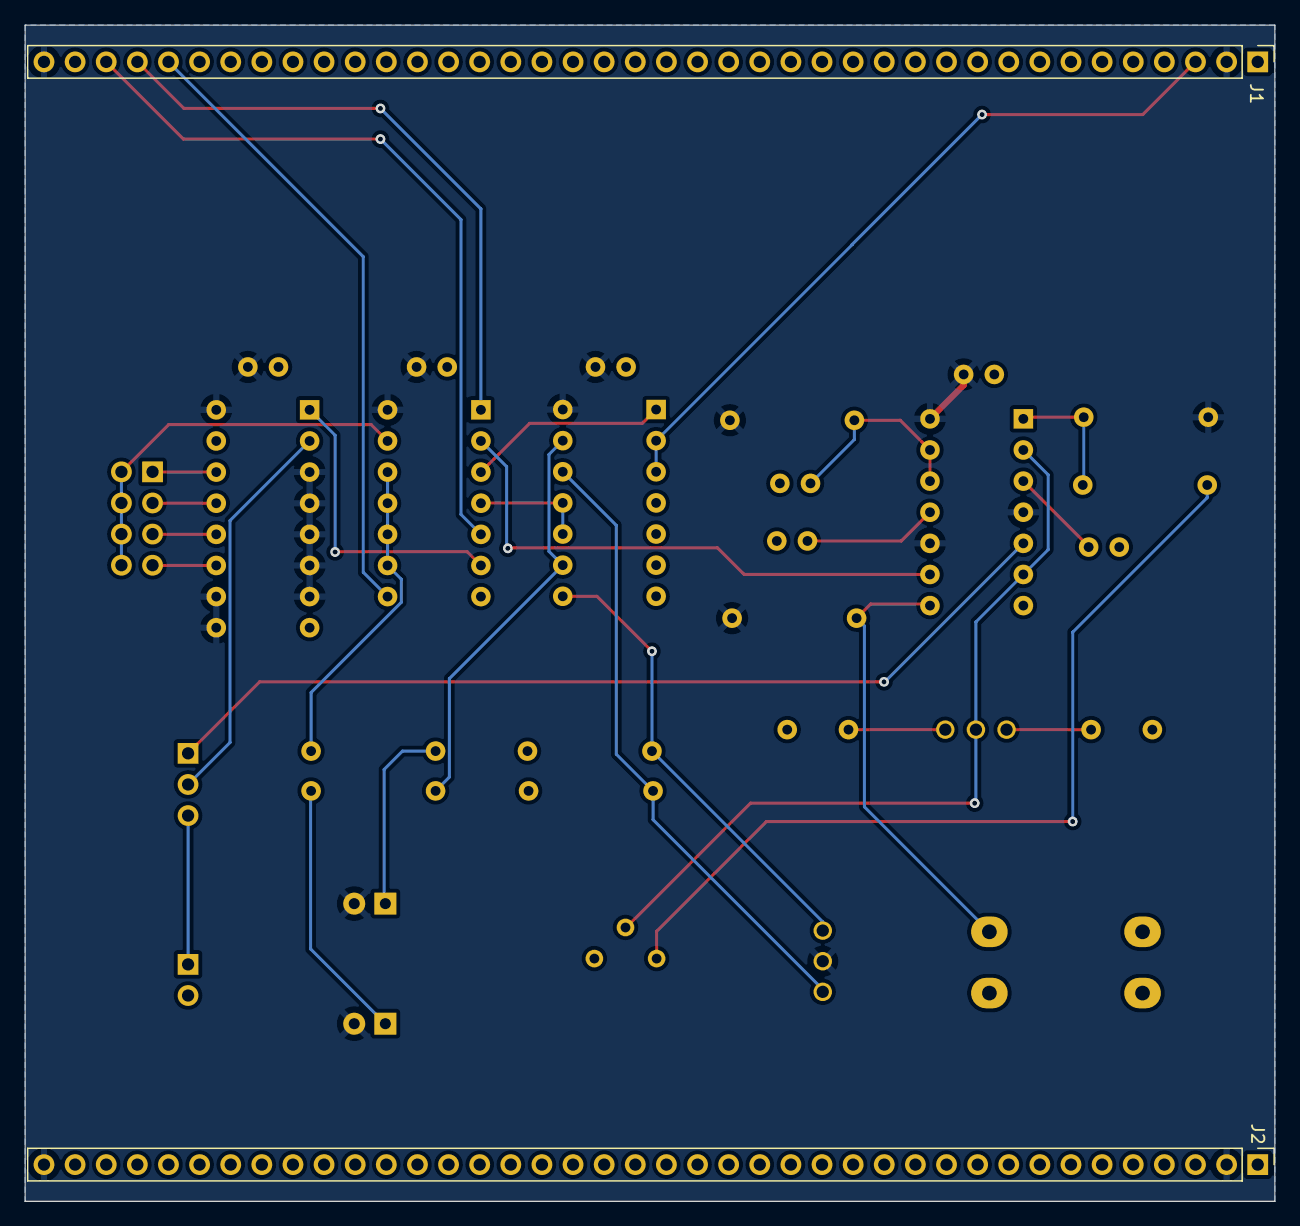
[picture p65: board clock.kicad_pcb from below]

Board: 2 copper layers, 102.0 x 96.0 mm, 32 parts (2 on the bottom side), 33 nets.
