TomNisbet/sap-plus/schematics/alu/alu.kicad_pcb

## KiCad design schematics/alu/alu.kicad_pcb (2024-12-01)

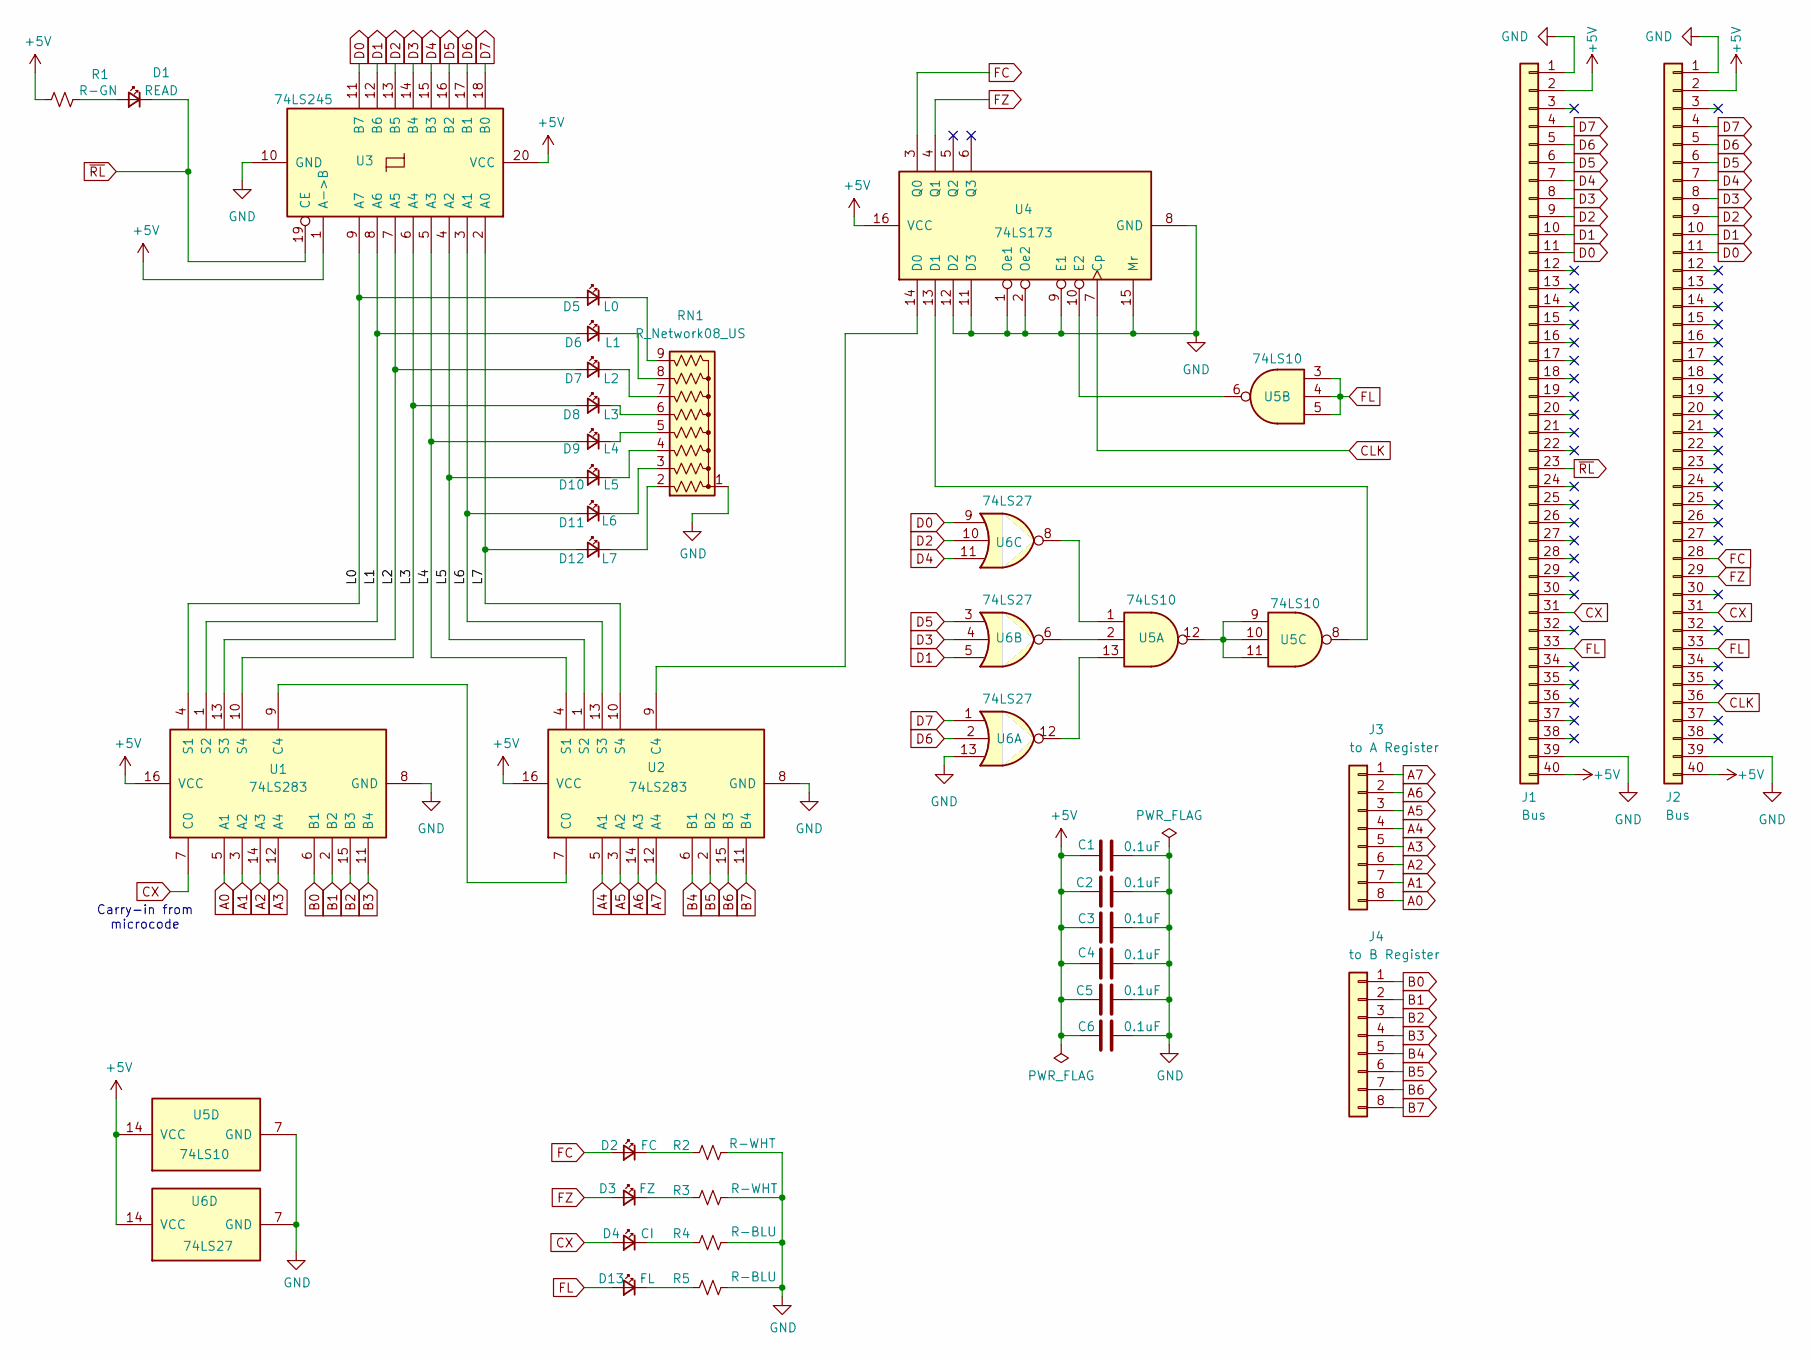
[picture p66: schematic alu.kicad_sch, SAP-Plus ALU]

Parts:
C1, C2, C3, C4, C5, C6: 0.1uF; C_Disc_D3.0mm_W1.6mm_P2.50mm
D1: READ; LED_D3.0mm
D2: FC; LED_D3.0mm
D3: FZ; LED_D3.0mm
D4: CI; LED_D3.0mm
D5: L0; LED_D3.0mm
D6: L1; LED_D3.0mm
D7: L2; LED_D3.0mm
D8: L3; LED_D3.0mm
D9: L4; LED_D3.0mm
D10: L5; LED_D3.0mm
D11: L6; LED_D3.0mm
D12: L7; LED_D3.0mm
D13: FL; LED_D3.0mm
J1, J2: Bus; PinHeader_1x40_P2.54mm_Vertical
J3: to A Register; PinHeader_1x08_P2.54mm_Vertical
J4: to B Register; PinHeader_1x08_P2.54mm_Vertical
R1: R-GN; R_Axial_DIN0207_L6.3mm_D2.5mm_P10.16mm_Horizontal
R2, R3: R-WHT; R_Axial_DIN0207_L6.3mm_D2.5mm_P10.16mm_Horizontal
R4, R5: R-BLU; R_Axial_DIN0207_L6.3mm_D2.5mm_P10.16mm_Horizontal
RN1: R_Network08_US; R_Array_SIP9
U1, U2: 74LS283; DIP-16_W7.62mm
U3: 74LS245; DIP-20_W7.62mm
U4: 74LS173; DIP-16_W7.62mm
U5: 74LS10; DIP-14_W7.62mm
U6: 74LS27; DIP-14_W7.62mm

Connections:
+5V: C1.2, C2.2, C3.2, C4.2, C5.2, C6.2, J1.2, J1.40, J2.2, J2.40, R1.2, U1.16 (VCC), U2.16 (VCC), U3.1 (A->B), U3.20 (VCC), U4.16 (VCC), U5.14 (VCC), U6.14 (VCC)
/L0: D5.2 (A), U1.4 (S1), U3.9 (A7)
/L1: D6.2 (A), U1.1 (S2), U3.8 (A6)
/L2: D7.2 (A), U1.13 (S3), U3.7 (A5)
/L3: D8.2 (A), U1.10 (S4), U3.6 (A4)
/L4: D9.2 (A), U2.4 (S1), U3.5 (A3)
/L5: D10.2 (A), U2.1 (S2), U3.4 (A2)
/L6: D11.2 (A), U2.13 (S3), U3.3 (A1)
/L7: D12.2 (A), U2.10 (S4), U3.2 (A0)
A0: J3.8, U1.5 (A1)
A1: J3.7, U1.3 (A2)
A2: J3.6, U1.14 (A3)
A3: J3.5, U1.12 (A4)
A4: J3.4, U2.5 (A1)
A5: J3.3, U2.3 (A2)
A6: J3.2, U2.14 (A3)
A7: J3.1, U2.12 (A4)
B0: J4.1, U1.6 (B1)
B1: J4.2, U1.2 (B2)
B2: J4.3, U1.15 (B3)
B3: J4.4, U1.11 (B4)
B4: J4.5, U2.6 (B1)
B5: J4.6, U2.2 (B2)
B6: J4.7, U2.15 (B3)
B7: J4.8, U2.11 (B4)
CLK: J2.36, U4.7 (Cp)
CX: D4.2 (A), J1.31, J2.31, U1.7 (C0)
D0: J1.11, J2.11, U3.11 (B7), U6.9
D1: J1.10, J2.10, U3.12 (B6), U6.5
D2: J1.9, J2.9, U3.13 (B5), U6.10
D3: J1.8, J2.8, U3.14 (B4), U6.4
D4: J1.7, J2.7, U3.15 (B3), U6.11
D5: J1.6, J2.6, U3.16 (B2), U6.3
D6: J1.5, J2.5, U3.17 (B1), U6.2
D7: J1.4, J2.4, U3.18 (B0), U6.1
FC: D2.2 (A), J2.28, U4.3 (Q0)
FL: D13.2 (A), J1.33, J2.33, U5.3, U5.4, U5.5
FZ: D3.2 (A), J2.29, U4.4 (Q1)
GND: C1.1, C2.1, C3.1, C4.1, C5.1, C6.1, J1.1, J1.39, J2.1, J2.39, R2.1, R3.1, R4.1, R5.1, RN1.1 (common), U1.8 (GND), U2.8 (GND), U3.10 (GND), U4.1 (Oe1), U4.2 (Oe2), U4.8 (GND), U4.9 (E1), U4.11 (D3), U4.12 (D2), U4.15 (Mr), U5.7 (GND), U6.7 (GND), U6.13
unnamed: D1.2 (A), R1.1
unnamed: D2.1 (K), R2.2
unnamed: D3.1 (K), R3.2
unnamed: D4.1 (K), R4.2
unnamed: D5.1 (K), RN1.9 (R8)
unnamed: D6.1 (K), RN1.8 (R7)
unnamed: D7.1 (K), RN1.7 (R6)
unnamed: D8.1 (K), RN1.6 (R5)
unnamed: D9.1 (K), RN1.5 (R4)
unnamed: D10.1 (K), RN1.4 (R3)
unnamed: D11.1 (K), RN1.3 (R2)
unnamed: D12.1 (K), RN1.2 (R1)
unnamed: D13.1 (K), R5.2
unnamed: U1.9 (C4), U2.7 (C0)
unnamed: U2.9 (C4), U4.14 (D0)
unnamed: U4.13 (D1), U5.8
unnamed: U4.10 (E2), U5.6
unnamed: U5.1, U6.8
unnamed: U5.2, U6.6
unnamed: U5.9, U5.10, U5.11, U5.12
unnamed: U5.13, U6.12
~RL: D1.1 (K), J1.23, U3.19 (CE)

Notes on the sheet:
Carry-in from microcode

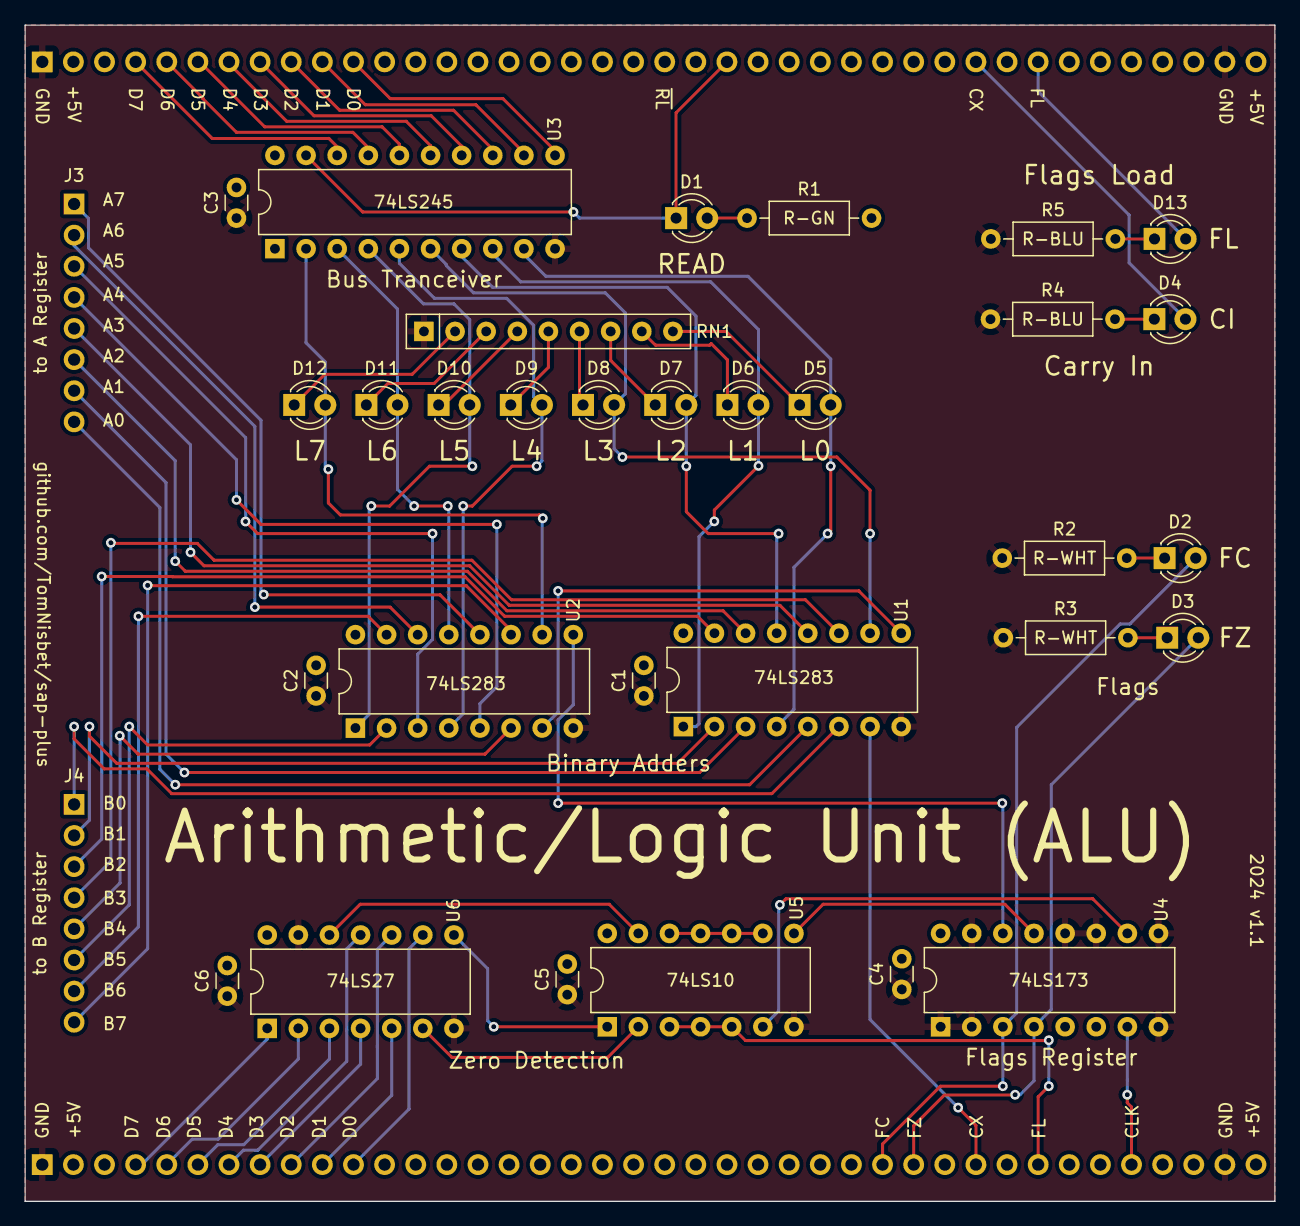
[picture p67: board alu.kicad_pcb from above]

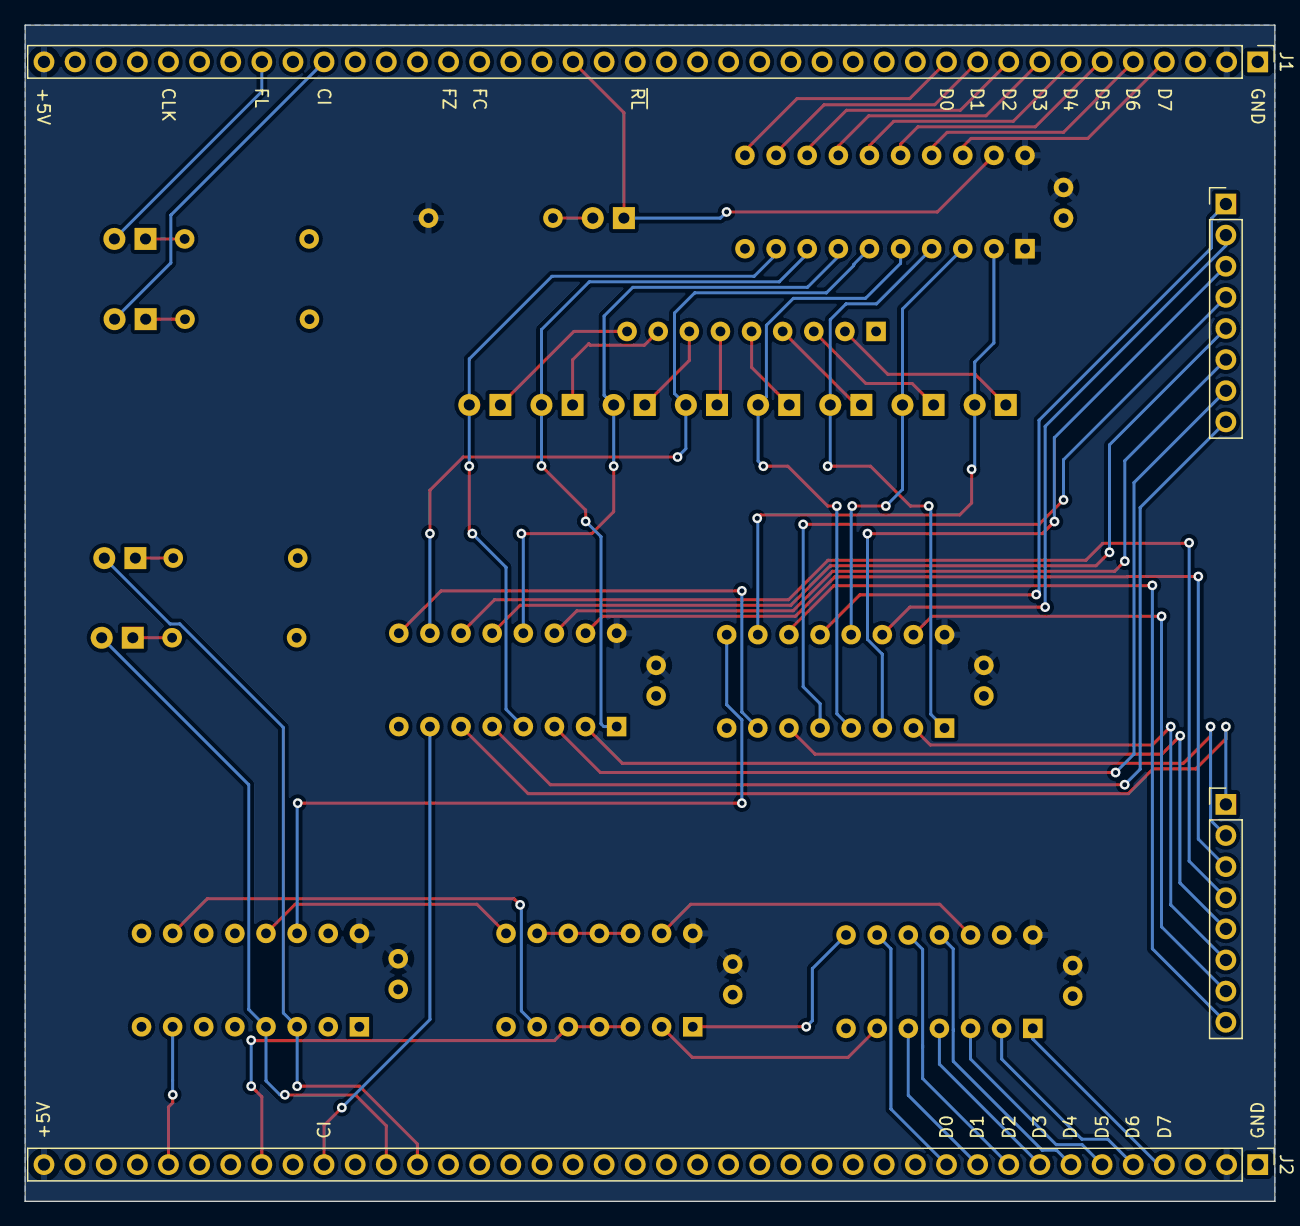
[picture p68: board alu.kicad_pcb from below]

Board: 2 copper layers, 102.0 x 96.0 mm, 35 parts (4 on the bottom side), 61 nets.
