TomNisbet/sap-plus/schematics/ir-sc/ir-sc.kicad_pcb

## KiCad design schematics/ir-sc/ir-sc.kicad_pcb (2024-12-01)

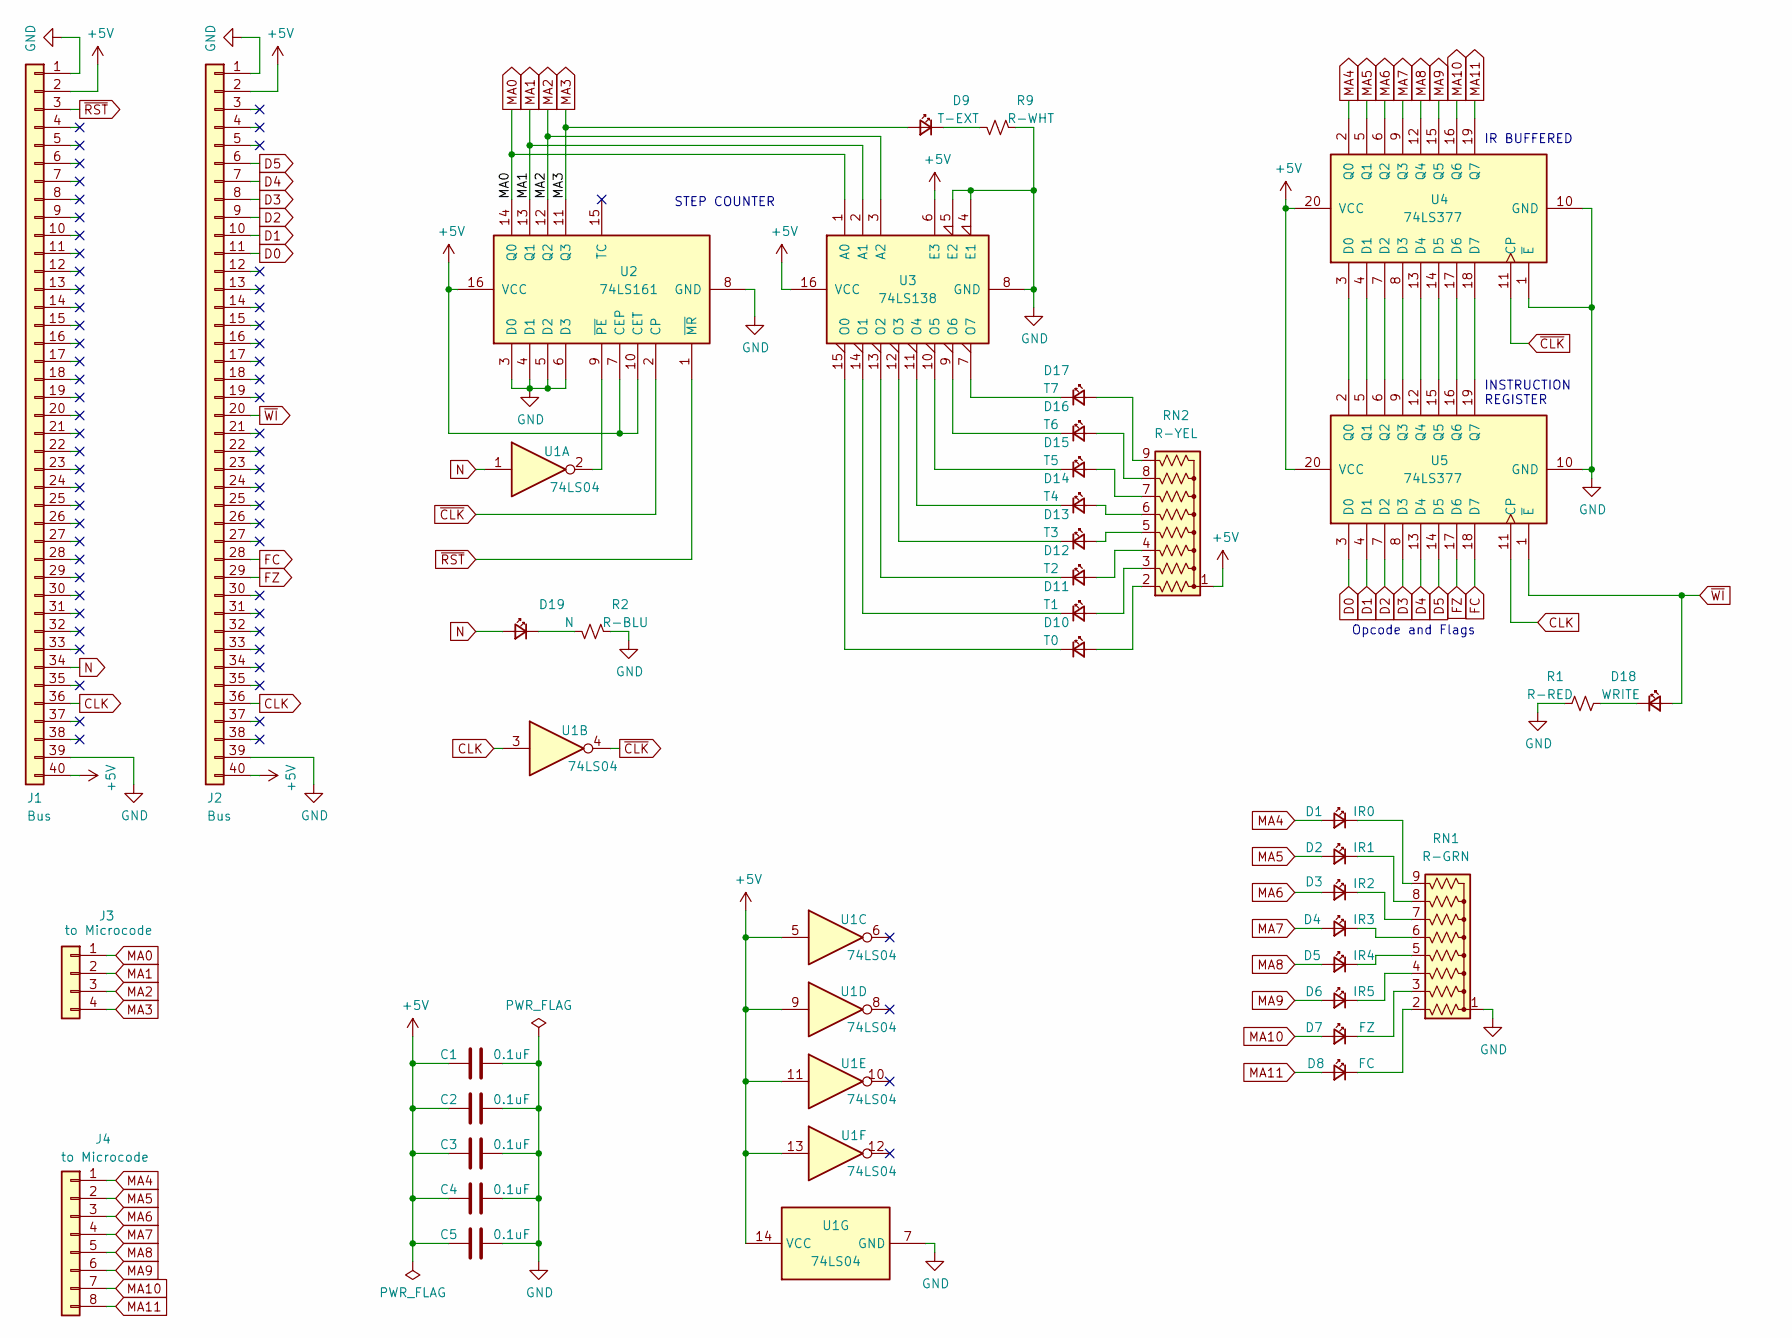
[picture p69: schematic ir-sc.kicad_sch, SAP-Plus Instruction Register and Step Counter]

Parts:
C1, C2, C3, C4, C5: 0.1uF; C_Disc_D3.0mm_W1.6mm_P2.50mm
D1: IR0; LED_D3.0mm
D2: IR1; LED_D3.0mm
D3: IR2; LED_D3.0mm
D4: IR3; LED_D3.0mm
D5: IR4; LED_D3.0mm
D6: IR5; LED_D3.0mm
D7: FZ; LED_D3.0mm
D8: FC; LED_D3.0mm
D9: T-EXT; LED_D3.0mm
D10: T0; LED_D3.0mm
D11: T1; LED_D3.0mm
D12: T2; LED_D3.0mm
D13: T3; LED_D3.0mm
D14: T4; LED_D3.0mm
D15: T5; LED_D3.0mm
D16: T6; LED_D3.0mm
D17: T7; LED_D3.0mm
D18: WRITE; LED_D3.0mm
D19: N; LED_D3.0mm
J1, J2: Bus; PinHeader_1x40_P2.54mm_Vertical
J3: to Microcode; PinHeader_1x04_P2.54mm_Vertical
J4: to Microcode; PinHeader_1x08_P2.54mm_Vertical
R1: R-RED; R_Axial_DIN0207_L6.3mm_D2.5mm_P10.16mm_Horizontal
R2: R-BLU; R_Axial_DIN0207_L6.3mm_D2.5mm_P10.16mm_Horizontal
R9: R-WHT; R_Axial_DIN0207_L6.3mm_D2.5mm_P10.16mm_Horizontal
RN1: R-GRN; R_Array_SIP9
RN2: R-YEL; R_Array_SIP9
U1: 74LS04; DIP-14_W7.62mm
U2: 74LS161; DIP-16_W7.62mm
U3: 74LS138; DIP-16_W7.62mm
U4, U5: 74LS377; DIP-20_W7.62mm

Connections:
+5V: C1.2, C2.2, C3.2, C4.2, C5.2, J1.2, J1.40, J2.2, J2.40, RN2.1 (common), U1.5, U1.9, U1.11, U1.13, U1.14 (VCC), U2.7 (CEP), U2.10 (CET), U2.16 (VCC), U3.6 (E3), U3.16 (VCC), U4.20 (VCC), U5.20 (VCC)
CLK: J1.36, J2.36, U1.3, U5.11 (CP)
D0: J2.11, U5.3 (D0)
D1: J2.10, U5.4 (D1)
D2: J2.9, U5.7 (D2)
D3: J2.8, U5.8 (D3)
D4: J2.7, U5.13 (D4)
D5: J2.6, U5.14 (D5)
FC: J2.28, U5.18 (D7)
FZ: J2.29, U5.17 (D6)
GND: C1.1, C2.1, C3.1, C4.1, C5.1, J1.1, J1.39, J2.1, J2.39, R1.1, R2.1, R9.1, RN1.1 (common), U1.7 (GND), U2.3 (D0), U2.4 (D1), U2.5 (D2), U2.6 (D3), U2.8 (GND), U3.4 (E1), U3.5 (E2), U3.8 (GND), U4.1 (~E), U4.10 (GND), U5.10 (GND)
MA0: J3.1, U2.14 (Q0), U3.1 (A0)
MA1: J3.2, U2.13 (Q1), U3.2 (A1)
MA2: J3.3, U2.12 (Q2), U3.3 (A2)
MA3: D9.2 (A), J3.4, U2.11 (Q3)
MA4: D1.2 (A), J4.1, U4.2 (Q0)
MA5: D2.2 (A), J4.2, U4.5 (Q1)
MA6: D3.2 (A), J4.3, U4.6 (Q2)
MA7: D4.2 (A), J4.4, U4.9 (Q3)
MA8: D5.2 (A), J4.5, U4.12 (Q4)
MA9: D6.2 (A), J4.6, U4.15 (Q5)
MA10: D7.2 (A), J4.7, U4.16 (Q6)
MA11: D8.2 (A), J4.8, U4.19 (Q7)
N: D19.2 (A), J1.34, U1.1
unnamed: D1.1 (K), RN1.9 (R8)
unnamed: D2.1 (K), RN1.8 (R7)
unnamed: D3.1 (K), RN1.7 (R6)
unnamed: D4.1 (K), RN1.6 (R5)
unnamed: D5.1 (K), RN1.5 (R4)
unnamed: D6.1 (K), RN1.4 (R3)
unnamed: D7.1 (K), RN1.3 (R2)
unnamed: D8.1 (K), RN1.2 (R1)
unnamed: D9.1 (K), R9.2
unnamed: D10.2 (A), RN2.2 (R1)
unnamed: D10.1 (K), U3.15 (O0)
unnamed: D11.2 (A), RN2.3 (R2)
unnamed: D11.1 (K), U3.14 (O1)
unnamed: D12.2 (A), RN2.4 (R3)
unnamed: D12.1 (K), U3.13 (O2)
unnamed: D13.2 (A), RN2.5 (R4)
unnamed: D13.1 (K), U3.12 (O3)
unnamed: D14.2 (A), RN2.6 (R5)
unnamed: D14.1 (K), U3.11 (O4)
unnamed: D15.2 (A), RN2.7 (R6)
unnamed: D15.1 (K), U3.10 (O5)
unnamed: D16.2 (A), RN2.8 (R7)
unnamed: D16.1 (K), U3.9 (O6)
unnamed: D17.2 (A), RN2.9 (R8)
unnamed: D17.1 (K), U3.7 (O7)
unnamed: D18.1 (K), R1.2
unnamed: D19.1 (K), R2.2
unnamed: U1.2, U2.9 (~PE)
unnamed: U4.3 (D0), U5.2 (Q0)
unnamed: U4.4 (D1), U5.5 (Q1)
unnamed: U4.7 (D2), U5.6 (Q2)
unnamed: U4.8 (D3), U5.9 (Q3)
unnamed: U4.13 (D4), U5.12 (Q4)
unnamed: U4.14 (D5), U5.15 (Q5)
unnamed: U4.17 (D6), U5.16 (Q6)
unnamed: U4.18 (D7), U5.19 (Q7)
~CLK: U1.4, U2.2 (CP), U4.11 (CP)
~RST: J1.3, U2.1 (~MR)
~WI: D18.2 (A), J2.20, U5.1 (~E)

Notes on the sheet:
STEP COUNTER
INSTRUCTION REGISTER
Opcode and Flags
IR BUFFERED

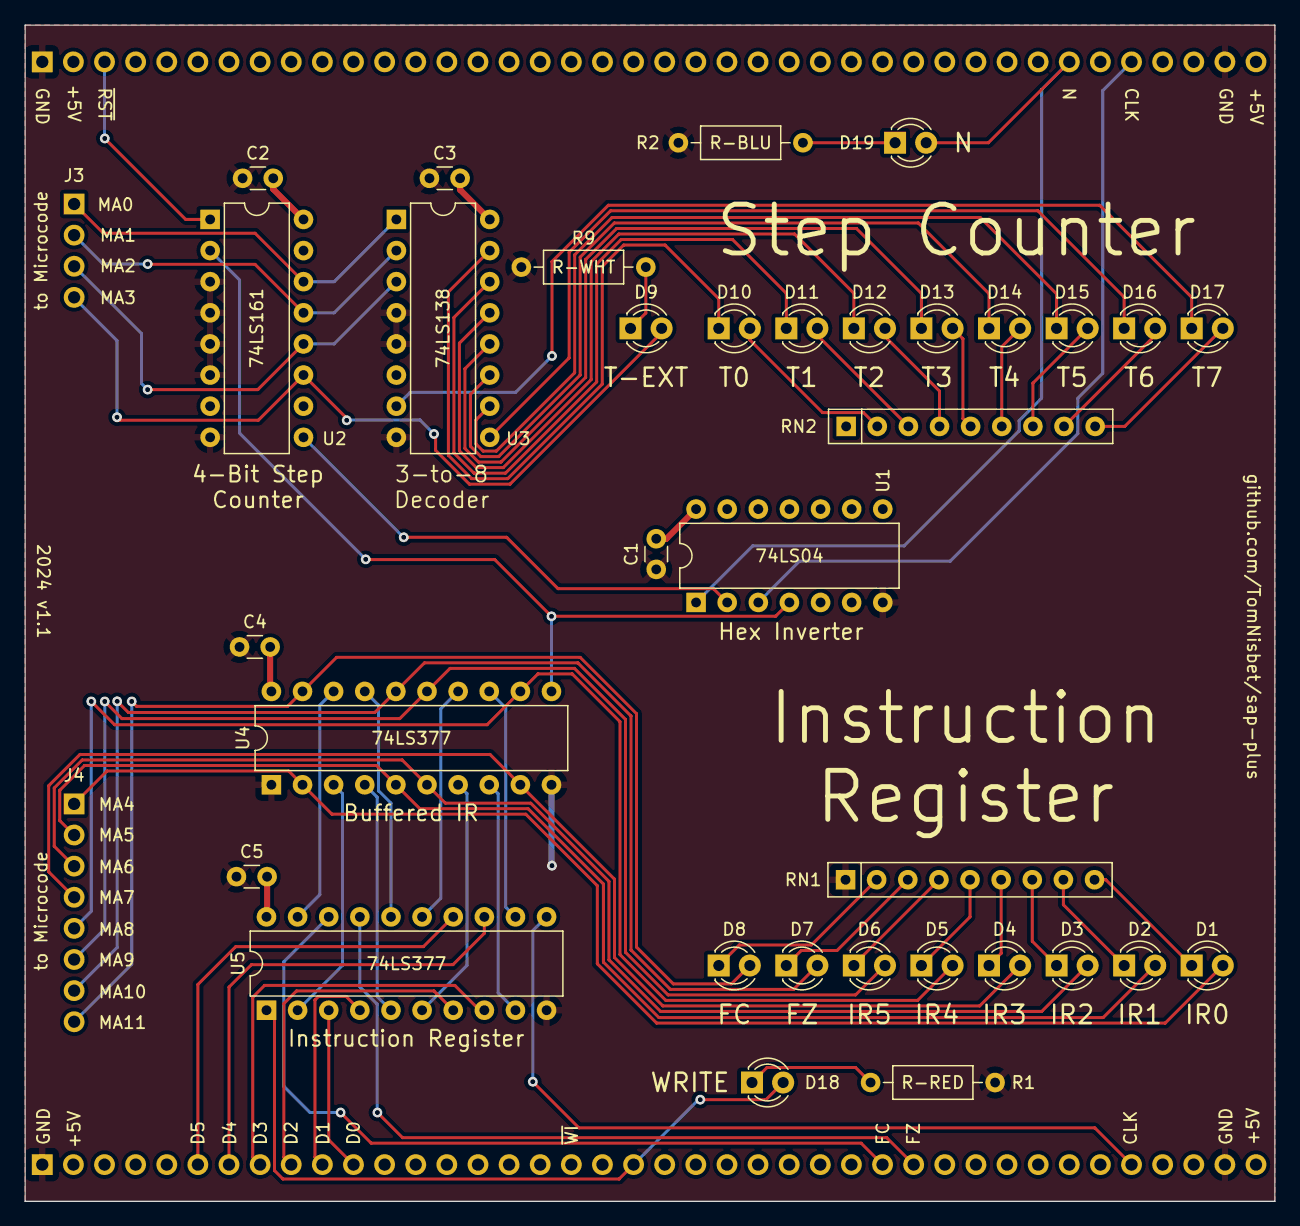
[picture p70: board ir-sc.kicad_pcb from above]

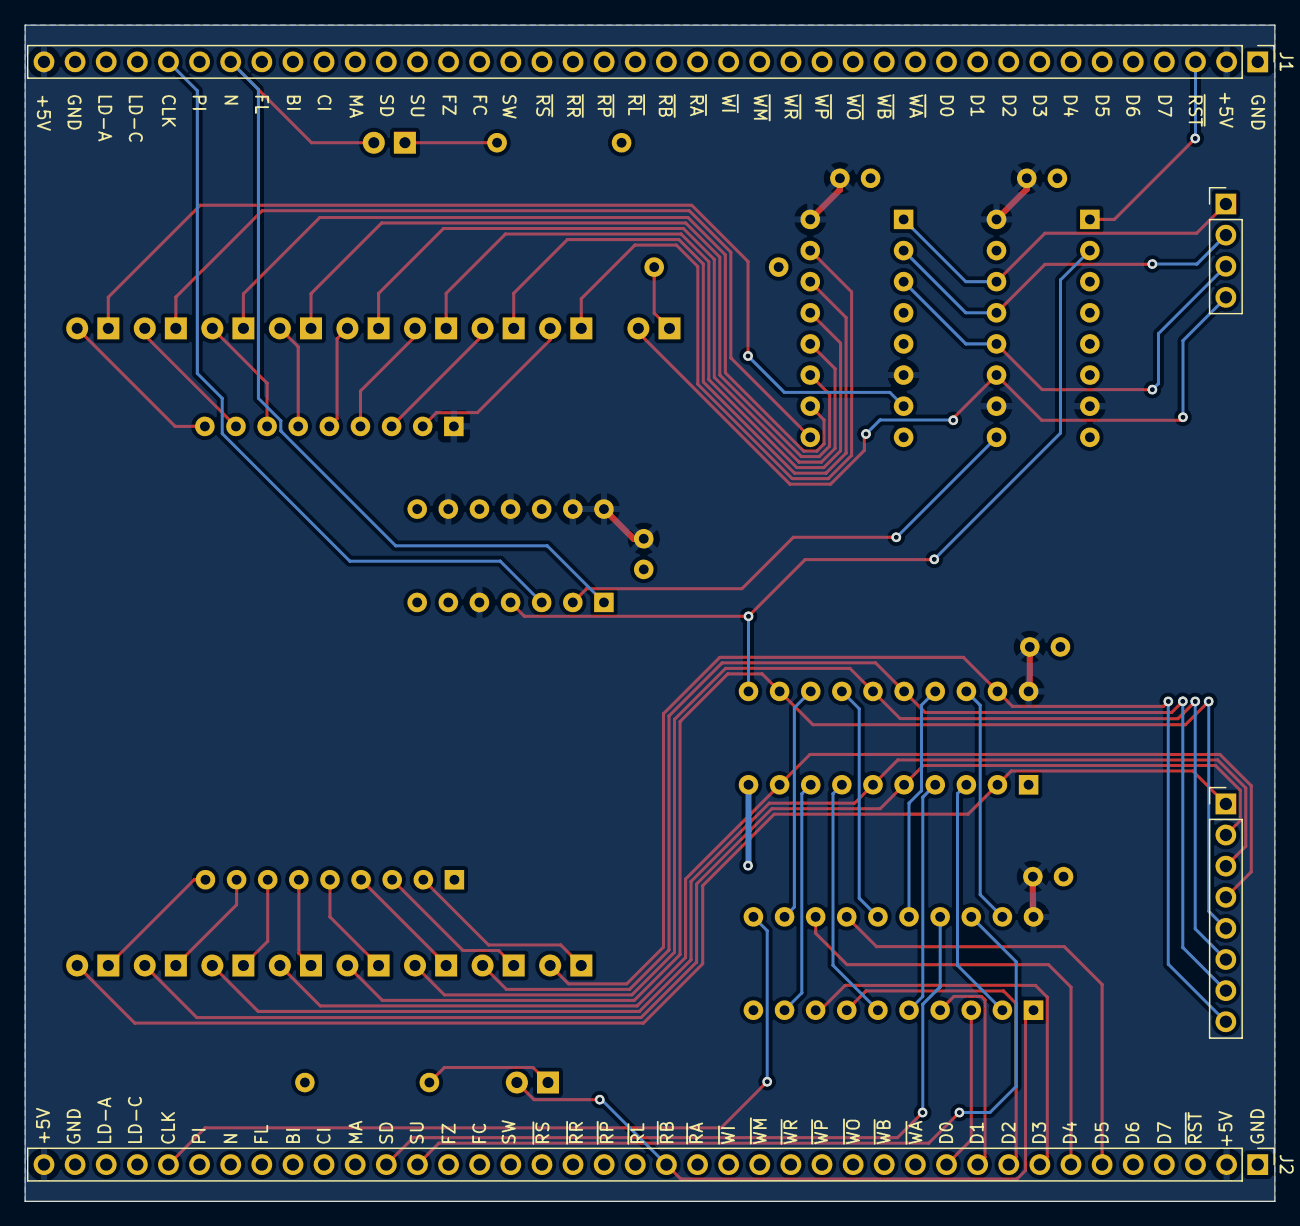
[picture p71: board ir-sc.kicad_pcb from below]

Board: 2 copper layers, 102.0 x 96.0 mm, 38 parts (4 on the bottom side), 63 nets.
