TomNisbet/sap-plus/schematics/pc-sp/pc-sp.kicad_pcb

## KiCad design schematics/pc-sp/pc-sp.kicad_pcb (2024-12-01)

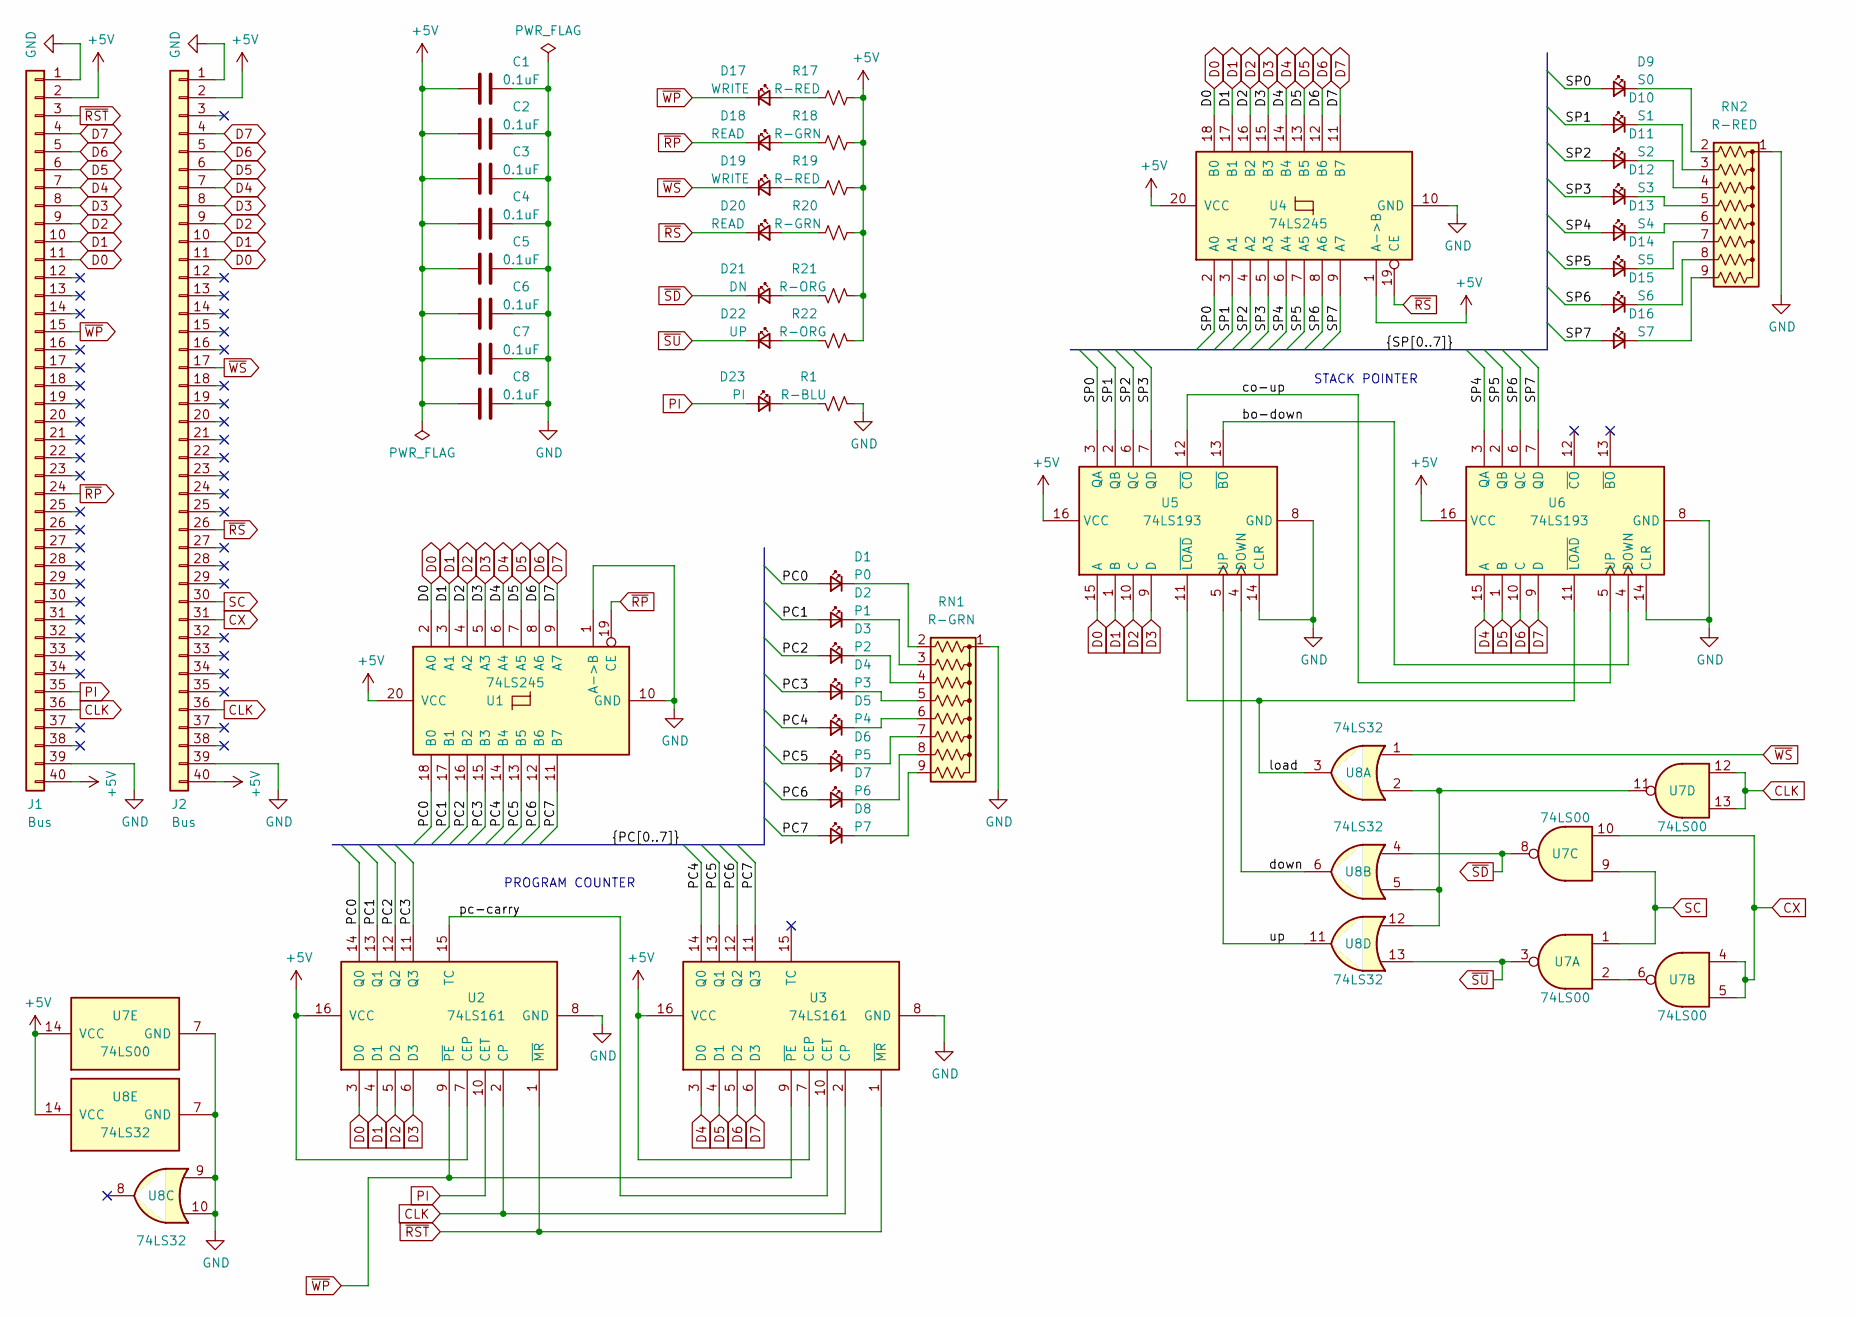
[picture p72: schematic pc-sp.kicad_sch, SAP-Plus Program Counter and Stack Pointer]

Parts:
C1, C2, C3, C4, C5, C6, C7, C8: 0.1uF; C_Disc_D3.0mm_W1.6mm_P2.50mm
D1: P0; LED_D3.0mm
D2: P1; LED_D3.0mm
D3: P2; LED_D3.0mm
D4: P3; LED_D3.0mm
D5: P4; LED_D3.0mm
D6: P5; LED_D3.0mm
D7: P6; LED_D3.0mm
D8: P7; LED_D3.0mm
D9: S0; LED_D3.0mm
D10: S1; LED_D3.0mm
D11: S2; LED_D3.0mm
D12: S3; LED_D3.0mm
D13: S4; LED_D3.0mm
D14: S5; LED_D3.0mm
D15: S6; LED_D3.0mm
D16: S7; LED_D3.0mm
D17, D19: WRITE; LED_D3.0mm
D18, D20: READ; LED_D3.0mm
D21: DN; LED_D3.0mm
D22: UP; LED_D3.0mm
D23: PI; LED_D3.0mm
J1, J2: Bus; PinHeader_1x40_P2.54mm_Vertical
R1: R-BLU; R_Axial_DIN0207_L6.3mm_D2.5mm_P10.16mm_Horizontal
R17, R19: R-RED; R_Axial_DIN0207_L6.3mm_D2.5mm_P10.16mm_Horizontal
R18, R20: R-GRN; R_Axial_DIN0207_L6.3mm_D2.5mm_P10.16mm_Horizontal
R21, R22: R-ORG; R_Axial_DIN0207_L6.3mm_D2.5mm_P10.16mm_Horizontal
RN1: R-GRN; R_Array_SIP9
RN2: R-RED; R_Array_SIP9
U1, U4: 74LS245; DIP-20_W7.62mm
U2, U3: 74LS161; DIP-16_W7.62mm
U5, U6: 74LS193; DIP-16_W7.62mm
U7: 74LS00; DIP-14_W7.62mm
U8: 74LS32; DIP-14_W7.62mm

Connections:
+5V: C1.2, C2.2, C3.2, C4.2, C5.2, C6.2, C7.2, C8.2, J1.2, J1.40, J2.2, J2.40, R17.1, R18.1, R19.1, R20.1, R21.2, R22.2, U1.20 (VCC), U2.7 (CEP), U2.16 (VCC), U3.7 (CEP), U3.16 (VCC), U4.1 (A->B), U4.20 (VCC), U5.16 (VCC), U6.16 (VCC), U7.14 (VCC), U8.14 (VCC)
/PC0: D1.2 (A), U1.18 (B0), U2.14 (Q0)
/PC1: D2.2 (A), U1.17 (B1), U2.13 (Q1)
/PC2: D3.2 (A), U1.16 (B2), U2.12 (Q2)
/PC3: D4.2 (A), U1.15 (B3), U2.11 (Q3)
/PC4: D5.2 (A), U1.14 (B4), U3.14 (Q0)
/PC5: D6.2 (A), U1.13 (B5), U3.13 (Q1)
/PC6: D7.2 (A), U1.12 (B6), U3.12 (Q2)
/PC7: D8.2 (A), U1.11 (B7), U3.11 (Q3)
/SP0: D9.2 (A), U4.2 (A0), U5.3 (QA)
/SP1: D10.2 (A), U4.3 (A1), U5.2 (QB)
/SP2: D11.2 (A), U4.4 (A2), U5.6 (QC)
/SP3: D12.2 (A), U4.5 (A3), U5.7 (QD)
/SP4: D13.2 (A), U4.6 (A4), U6.3 (QA)
/SP5: D14.2 (A), U4.7 (A5), U6.2 (QB)
/SP6: D15.2 (A), U4.8 (A6), U6.6 (QC)
/SP7: D16.2 (A), U4.9 (A7), U6.7 (QD)
/bo-down: U5.13 (~BO), U6.4 (DOWN)
/co-up: U5.12 (~CO), U6.5 (UP)
/down: U5.4 (DOWN), U8.6
/load: U5.11 (~LOAD), U6.11 (~LOAD), U8.3
/pc-carry: U2.15 (TC), U3.10 (CET)
/up: U5.5 (UP), U8.11
CLK: J1.36, J2.36, U2.2 (CP), U3.2 (CP), U7.12, U7.13
CX: J2.31, U7.4, U7.5, U7.10
D0: J1.11, J2.11, U1.2 (A0), U2.3 (D0), U4.18 (B0), U5.15 (A)
D1: J1.10, J2.10, U1.3 (A1), U2.4 (D1), U4.17 (B1), U5.1 (B)
D2: J1.9, J2.9, U1.4 (A2), U2.5 (D2), U4.16 (B2), U5.10 (C)
D3: J1.8, J2.8, U1.5 (A3), U2.6 (D3), U4.15 (B3), U5.9 (D)
D4: J1.7, J2.7, U1.6 (A4), U3.3 (D0), U4.14 (B4), U6.15 (A)
D5: J1.6, J2.6, U1.7 (A5), U3.4 (D1), U4.13 (B5), U6.1 (B)
D6: J1.5, J2.5, U1.8 (A6), U3.5 (D2), U4.12 (B6), U6.10 (C)
D7: J1.4, J2.4, U1.9 (A7), U3.6 (D3), U4.11 (B7), U6.9 (D)
GND: C1.1, C2.1, C3.1, C4.1, C5.1, C6.1, C7.1, C8.1, J1.1, J1.39, J2.1, J2.39, R1.2, RN1.1 (common), RN2.1 (common), U1.1 (A->B), U1.10 (GND), U2.8 (GND), U3.8 (GND), U4.10 (GND), U5.8 (GND), U5.14 (CLR), U6.8 (GND), U6.14 (CLR), U7.7 (GND), U8.7 (GND), U8.9, U8.10
unnamed: D1.1 (K), RN1.2 (R1)
unnamed: D2.1 (K), RN1.3 (R2)
unnamed: D3.1 (K), RN1.4 (R3)
unnamed: D4.1 (K), RN1.5 (R4)
unnamed: D5.1 (K), RN1.6 (R5)
unnamed: D6.1 (K), RN1.7 (R6)
unnamed: D7.1 (K), RN1.8 (R7)
unnamed: D8.1 (K), RN1.9 (R8)
unnamed: D9.1 (K), RN2.2 (R1)
unnamed: D10.1 (K), RN2.3 (R2)
unnamed: D11.1 (K), RN2.4 (R3)
unnamed: D12.1 (K), RN2.5 (R4)
unnamed: D13.1 (K), RN2.6 (R5)
unnamed: D14.1 (K), RN2.7 (R6)
unnamed: D15.1 (K), RN2.8 (R7)
unnamed: D16.1 (K), RN2.9 (R8)
unnamed: D17.2 (A), R17.2
unnamed: D18.2 (A), R18.2
unnamed: D19.2 (A), R19.2
unnamed: D20.2 (A), R20.2
unnamed: D21.2 (A), R21.1
unnamed: D22.2 (A), R22.1
unnamed: D23.1 (K), R1.1
unnamed: U7.2, U7.6
unnamed: U7.11, U8.2, U8.5, U8.12
PI: D23.2 (A), J1.35, U2.10 (CET)
SC: J2.30, U7.1, U7.9
~RP: D18.1 (K), J1.24, U1.19 (CE)
~RST: J1.3, U2.1 (~MR), U3.1 (~MR)
~RS: D20.1 (K), J2.26, U4.19 (CE)
~SD: D21.1 (K), U7.8, U8.4
~SU: D22.1 (K), U7.3, U8.13
~WP: D17.1 (K), J1.15, U2.9 (~PE), U3.9 (~PE)
~WS: D19.1 (K), J2.17, U8.1

Notes on the sheet:
PROGRAM COUNTER
STACK POINTER

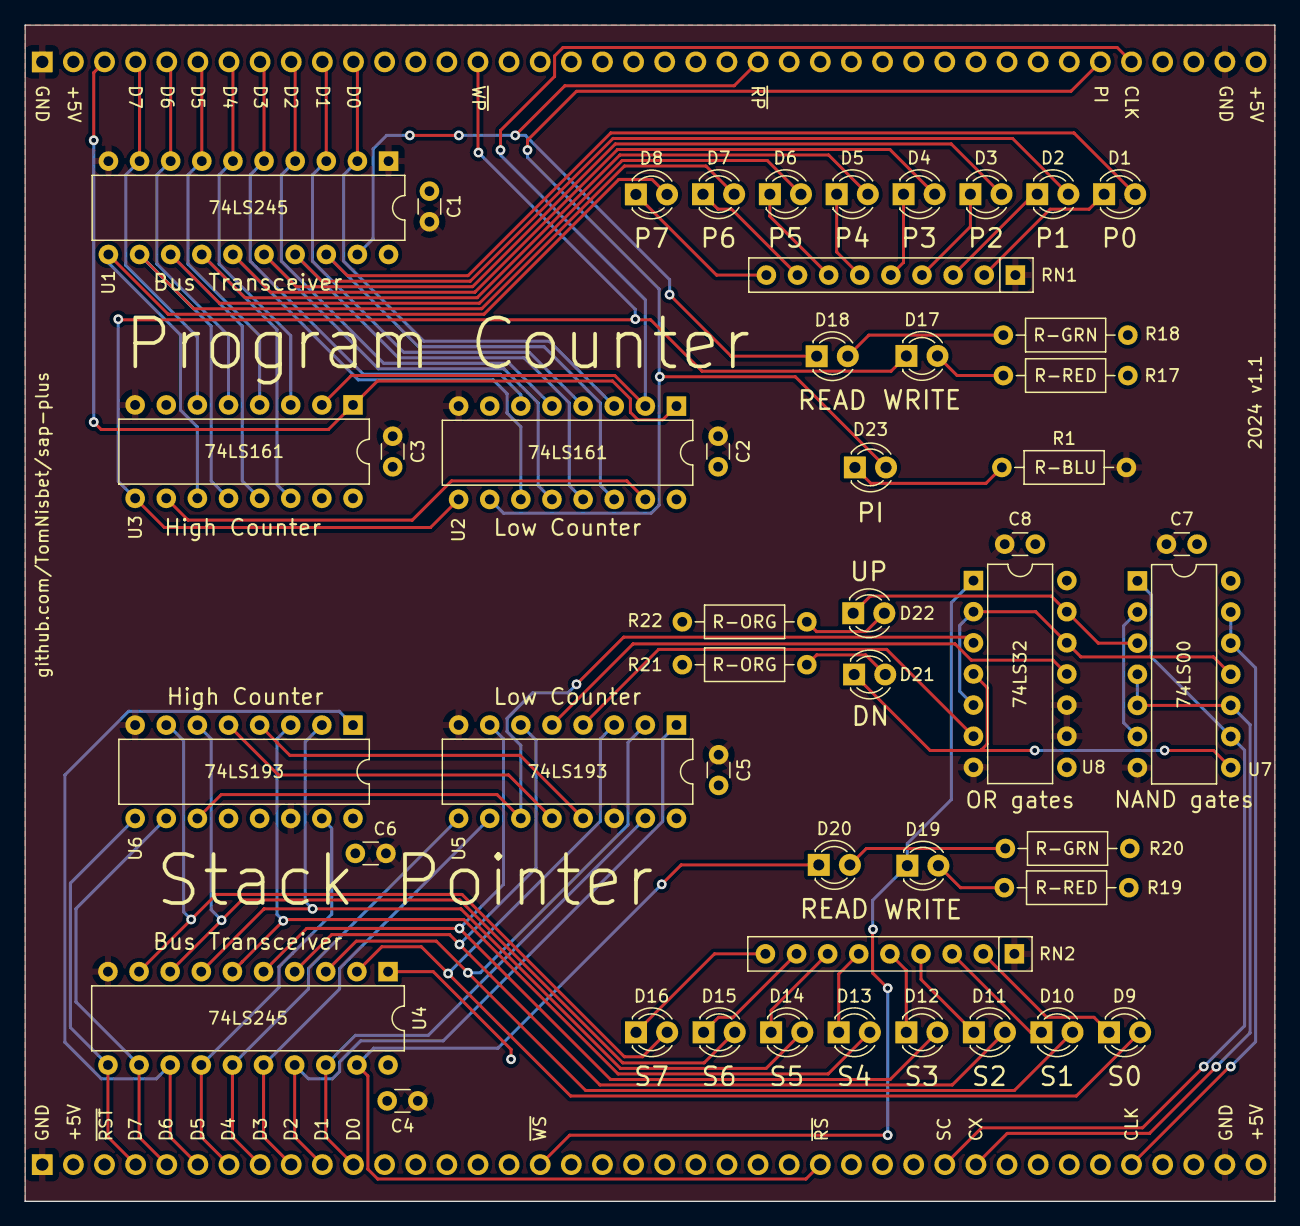
[picture p73: board pc-sp.kicad_pcb from above]

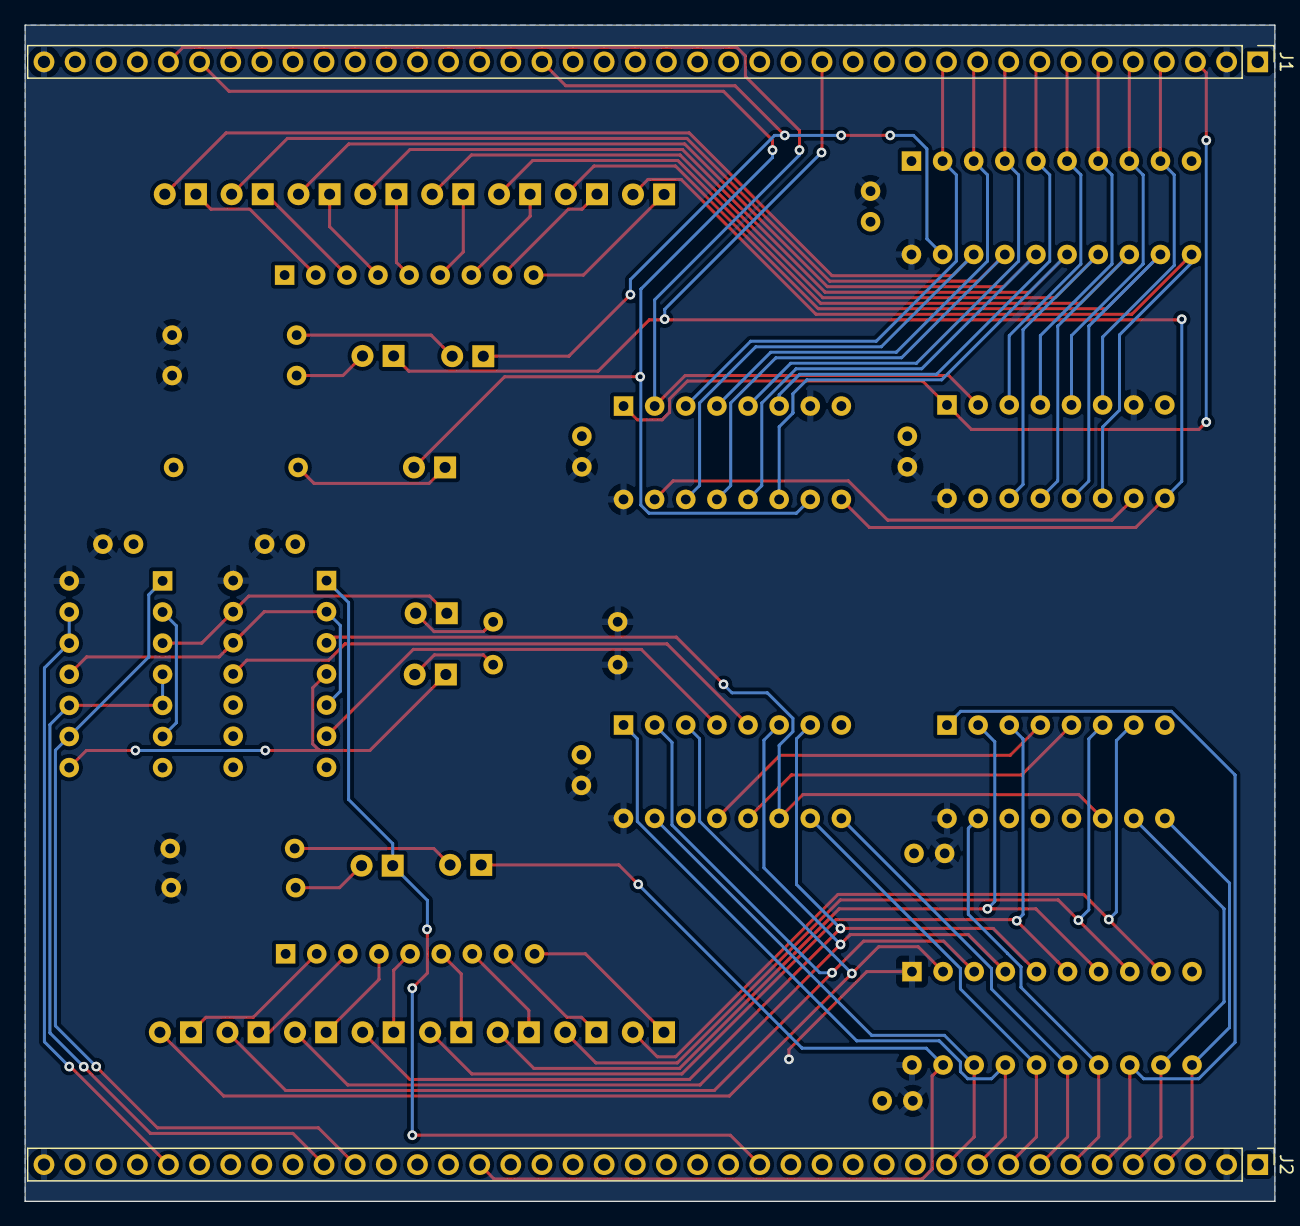
[picture p74: board pc-sp.kicad_pcb from below]

Board: 2 copper layers, 102.0 x 96.0 mm, 50 parts (2 on the bottom side), 68 nets.
