TomNisbet/sap-plus/schematics/ab-register/ab-register.kicad_pcb

## KiCad design schematics/ab-register/ab-register.kicad_pcb (2024-12-01)

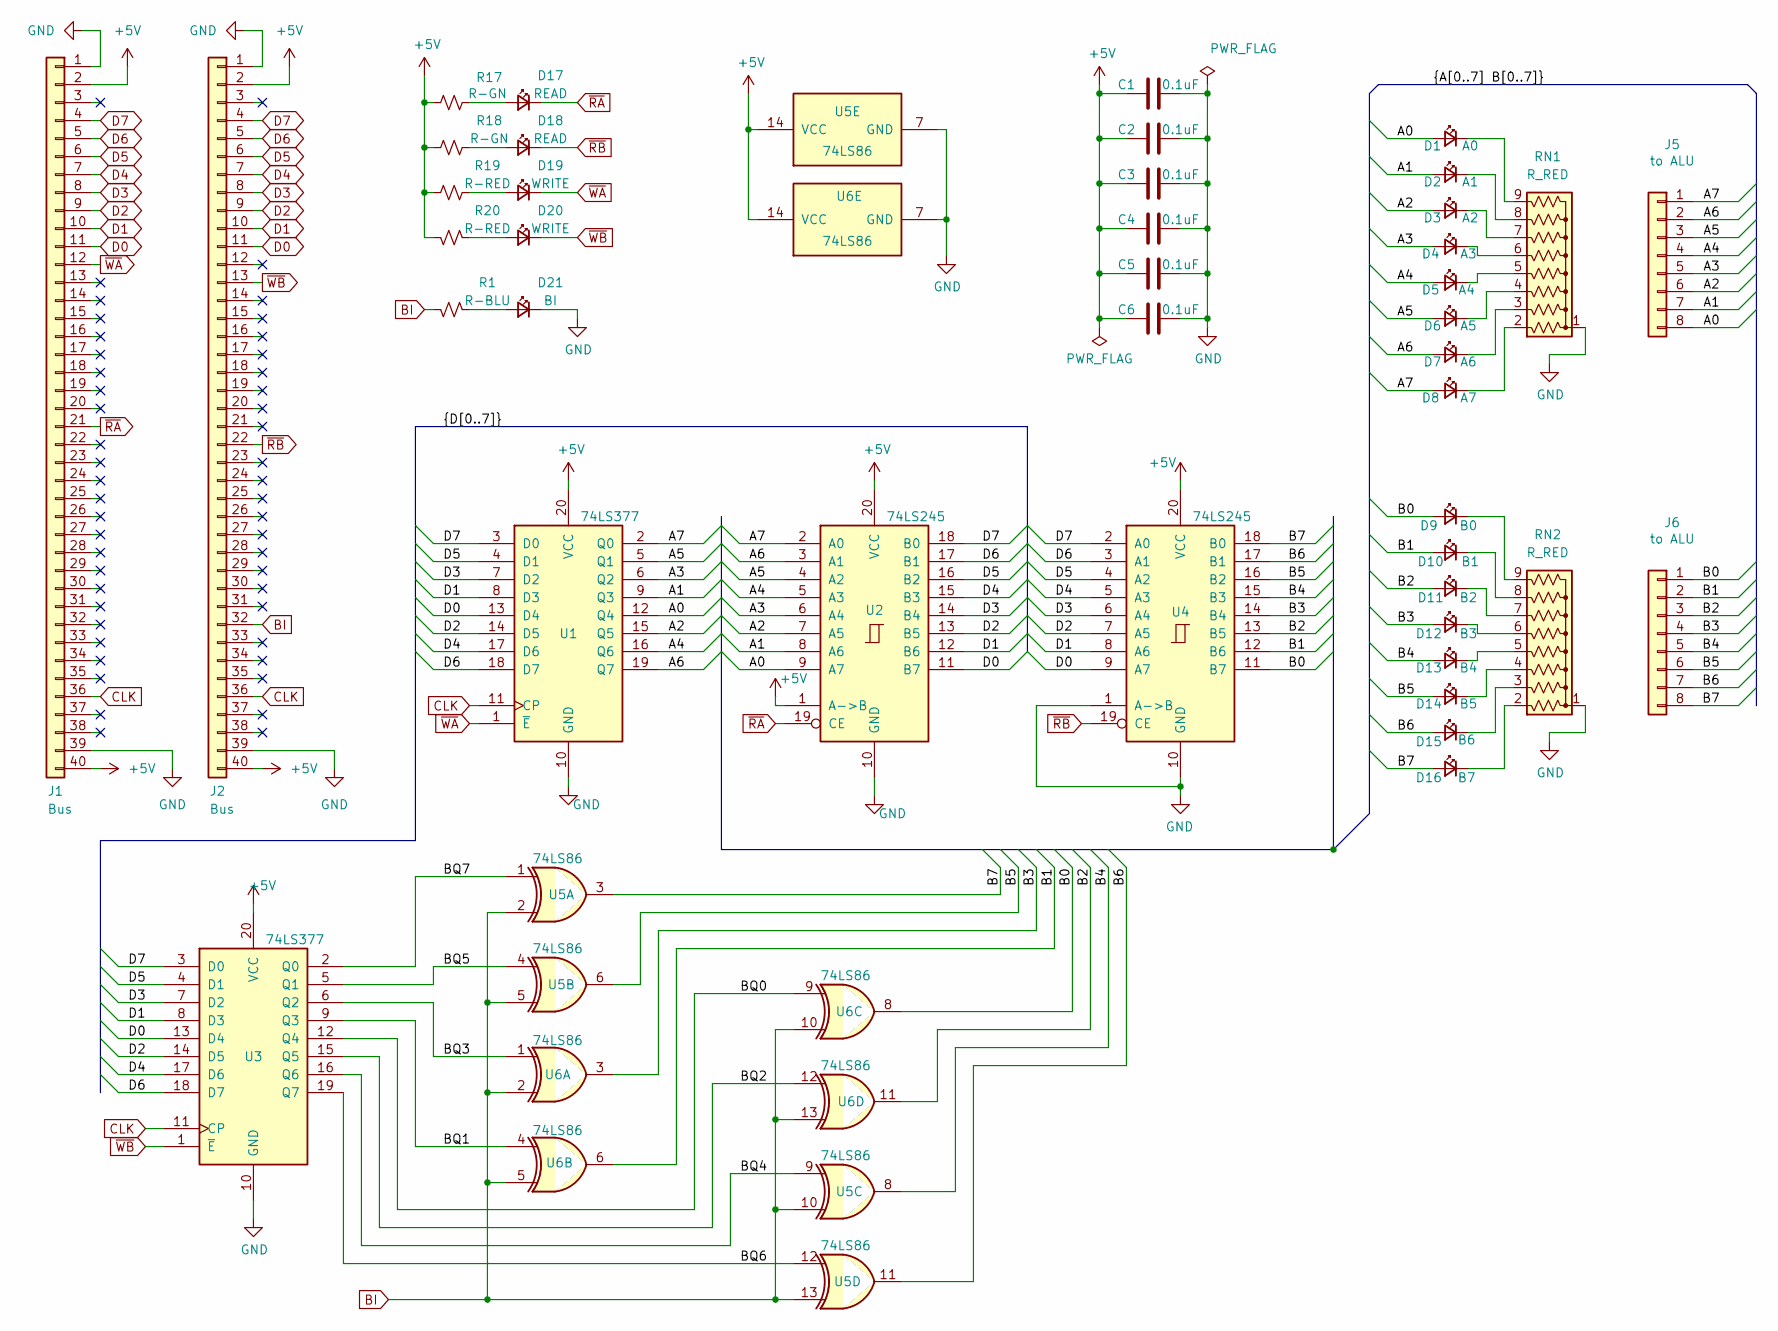
[picture p75: schematic ab-register.kicad_sch, SAP-Plus A and B Registers]

Parts:
C1, C2, C3, C4, C5, C6: 0.1uF; C_Disc_D3.0mm_W1.6mm_P2.50mm
D1: A0; LED_D3.0mm
D2: A1; LED_D3.0mm
D3: A2; LED_D3.0mm
D4: A3; LED_D3.0mm
D5: A4; LED_D3.0mm
D6: A5; LED_D3.0mm
D7: A6; LED_D3.0mm
D8: A7; LED_D3.0mm
D9: B0; LED_D3.0mm
D10: B1; LED_D3.0mm
D11: B2; LED_D3.0mm
D12: B3; LED_D3.0mm
D13: B4; LED_D3.0mm
D14: B5; LED_D3.0mm
D15: B6; LED_D3.0mm
D16: B7; LED_D3.0mm
D17, D18: READ; LED_D3.0mm
D19, D20: WRITE; LED_D3.0mm
D21: BI; LED_D3.0mm
J1, J2: Bus; PinHeader_1x40_P2.54mm_Vertical
J5, J6: to ALU; PinHeader_1x08_P2.54mm_Vertical
R1: R-BLU; R_Axial_DIN0207_L6.3mm_D2.5mm_P10.16mm_Horizontal
R17, R18: R-GN; R_Axial_DIN0207_L6.3mm_D2.5mm_P10.16mm_Horizontal
R19, R20: R-RED; R_Axial_DIN0207_L6.3mm_D2.5mm_P10.16mm_Horizontal
RN1, RN2: R_RED; R_Array_SIP9
U1, U3: 74LS377; DIP-20_W7.62mm
U2, U4: 74LS245; DIP-20_W7.62mm
U5, U6: 74LS86; DIP-14_W7.62mm

Connections:
+5V: C1.2, C2.2, C3.2, C4.2, C5.2, C6.2, J1.2, J1.40, J2.2, J2.40, R17.2, R18.2, R19.2, R20.1, U1.20 (VCC), U2.1 (A->B), U2.20 (VCC), U3.20 (VCC), U4.20 (VCC), U5.14 (VCC), U6.14 (VCC)
/A0: D1.2 (A), J5.8, U1.12 (Q4), U2.9 (A7)
/A1: D2.2 (A), J5.7, U1.9 (Q3), U2.8 (A6)
/A2: D3.2 (A), J5.6, U1.15 (Q5), U2.7 (A5)
/A3: D4.2 (A), J5.5, U1.6 (Q2), U2.6 (A4)
/A4: D5.2 (A), J5.4, U1.16 (Q6), U2.5 (A3)
/A5: D6.2 (A), J5.3, U1.5 (Q1), U2.4 (A2)
/A6: D7.2 (A), J5.2, U1.19 (Q7), U2.3 (A1)
/A7: D8.2 (A), J5.1, U1.2 (Q0), U2.2 (A0)
/B0: D9.2 (A), J6.1, U4.11 (B7), U6.8
/B1: D10.2 (A), J6.2, U4.12 (B6), U6.6
/B2: D11.2 (A), J6.3, U4.13 (B5), U6.11
/B3: D12.2 (A), J6.4, U4.14 (B4), U6.3
/B4: D13.2 (A), J6.5, U4.15 (B3), U5.8
/B5: D14.2 (A), J6.6, U4.16 (B2), U5.6
/B6: D15.2 (A), J6.7, U4.17 (B1), U5.11
/B7: D16.2 (A), J6.8, U4.18 (B0), U5.3
/BQ0: U3.12 (Q4), U6.9
/BQ1: U3.9 (Q3), U6.4
/BQ2: U3.15 (Q5), U6.12
/BQ3: U3.6 (Q2), U6.1
/BQ4: U3.16 (Q6), U5.9
/BQ5: U3.5 (Q1), U5.4
/BQ6: U3.19 (Q7), U5.12
/BQ7: U3.2 (Q0), U5.1
BI: J2.32, R1.1, U5.2, U5.5, U5.10, U5.13, U6.2, U6.5, U6.10, U6.13
CLK: J1.36, J2.36, U1.11 (CP), U3.11 (CP)
D0: J1.11, J2.11, U1.13 (D4), U2.11 (B7), U3.13 (D4), U4.9 (A7)
D1: J1.10, J2.10, U1.8 (D3), U2.12 (B6), U3.8 (D3), U4.8 (A6)
D2: J1.9, J2.9, U1.14 (D5), U2.13 (B5), U3.14 (D5), U4.7 (A5)
D3: J1.8, J2.8, U1.7 (D2), U2.14 (B4), U3.7 (D2), U4.6 (A4)
D4: J1.7, J2.7, U1.17 (D6), U2.15 (B3), U3.17 (D6), U4.5 (A3)
D5: J1.6, J2.6, U1.4 (D1), U2.16 (B2), U3.4 (D1), U4.4 (A2)
D6: J1.5, J2.5, U1.18 (D7), U2.17 (B1), U3.18 (D7), U4.3 (A1)
D7: J1.4, J2.4, U1.3 (D0), U2.18 (B0), U3.3 (D0), U4.2 (A0)
GND: C1.1, C2.1, C3.1, C4.1, C5.1, C6.1, D21.1 (K), J1.1, J1.39, J2.1, J2.39, RN1.1 (common), RN2.1 (common), U1.10 (GND), U2.10 (GND), U3.10 (GND), U4.1 (A->B), U4.10 (GND), U5.7 (GND), U6.7 (GND)
unnamed: D1.1 (K), RN1.9 (R8)
unnamed: D2.1 (K), RN1.8 (R7)
unnamed: D3.1 (K), RN1.7 (R6)
unnamed: D4.1 (K), RN1.6 (R5)
unnamed: D5.1 (K), RN1.5 (R4)
unnamed: D6.1 (K), RN1.4 (R3)
unnamed: D7.1 (K), RN1.3 (R2)
unnamed: D8.1 (K), RN1.2 (R1)
unnamed: D9.1 (K), RN2.9 (R8)
unnamed: D10.1 (K), RN2.8 (R7)
unnamed: D11.1 (K), RN2.7 (R6)
unnamed: D12.1 (K), RN2.6 (R5)
unnamed: D13.1 (K), RN2.5 (R4)
unnamed: D14.1 (K), RN2.4 (R3)
unnamed: D15.1 (K), RN2.3 (R2)
unnamed: D16.1 (K), RN2.2 (R1)
unnamed: D17.2 (A), R17.1
unnamed: D18.2 (A), R18.1
unnamed: D19.2 (A), R19.1
unnamed: D20.2 (A), R20.2
unnamed: D21.2 (A), R1.2
~RA: D17.1 (K), J1.21, U2.19 (CE)
~RB: D18.1 (K), J2.22, U4.19 (CE)
~WA: D19.1 (K), J1.12, U1.1 (~E)
~WB: D20.1 (K), J2.13, U3.1 (~E)

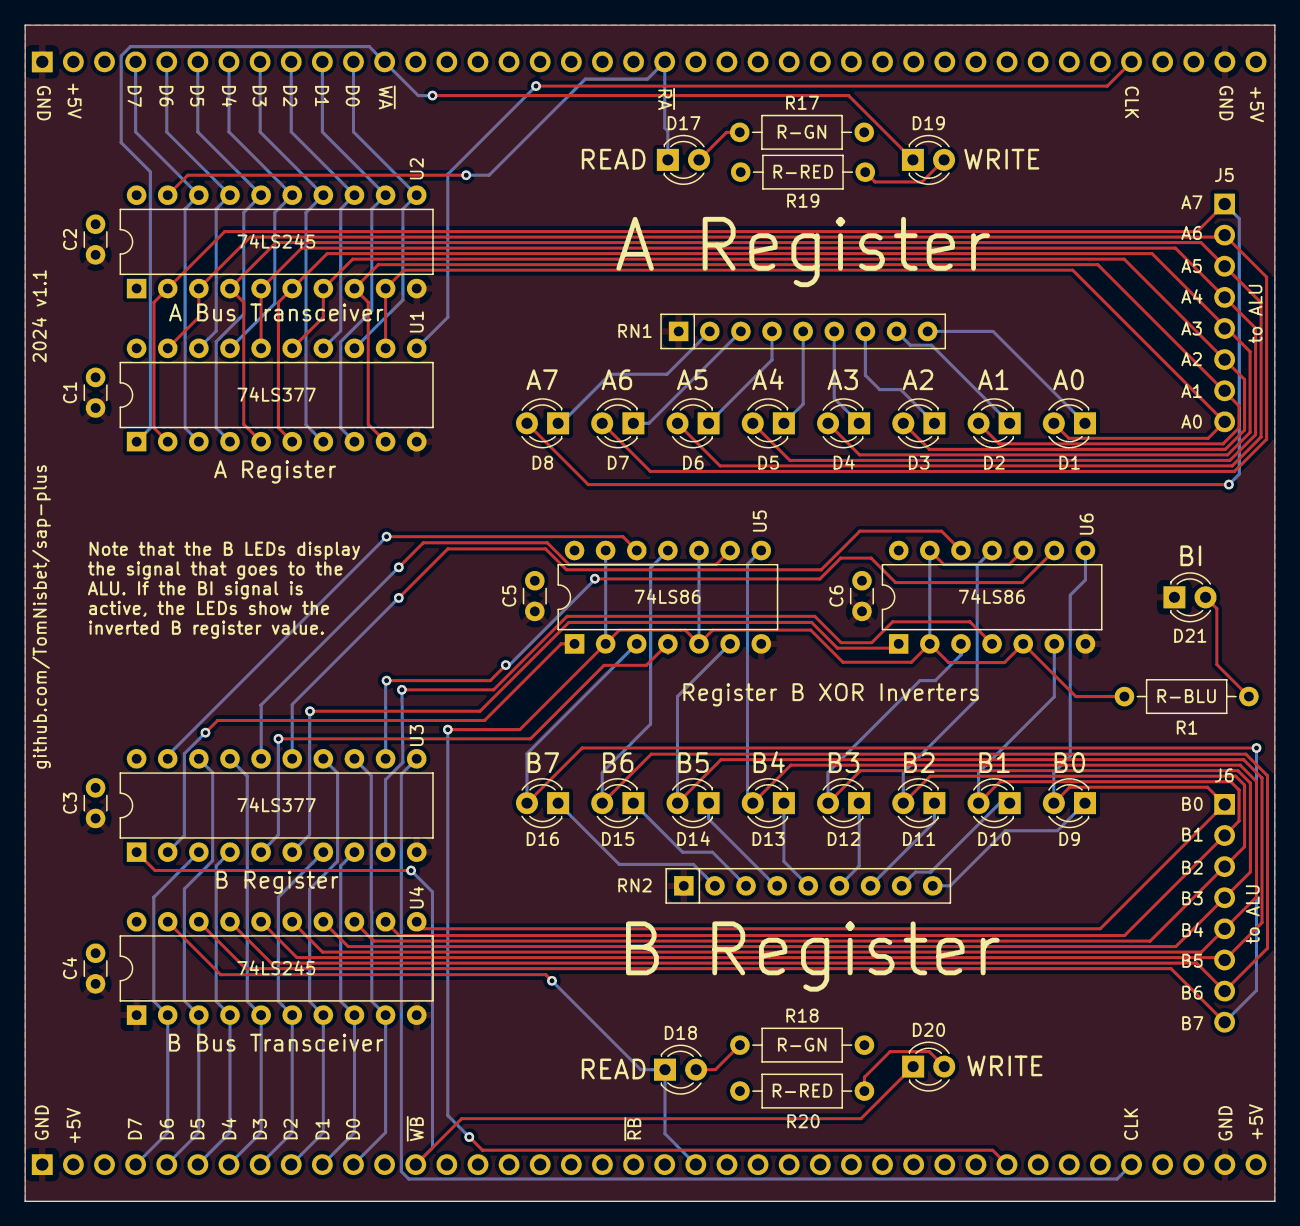
[picture p76: board ab-register.kicad_pcb from above]

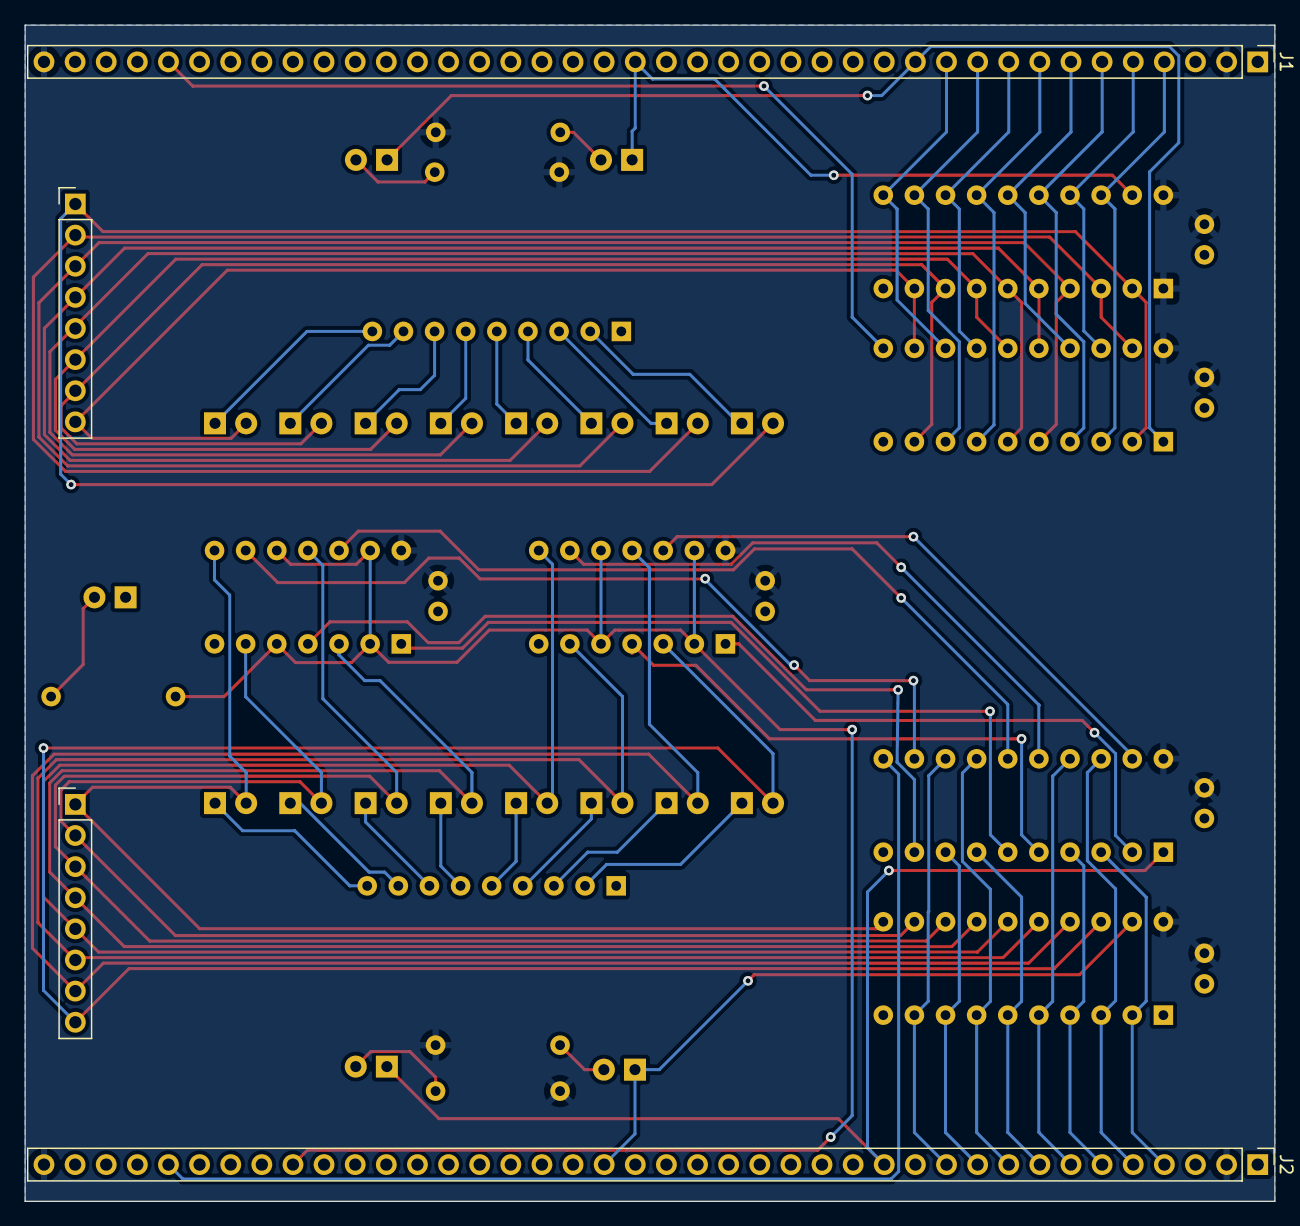
[picture p77: board ab-register.kicad_pcb from below]

Board: 2 copper layers, 102.0 x 96.0 mm, 44 parts (4 on the bottom side), 61 nets.
