TomNisbet/sap-plus/schematics/ram-mar/ram-mar.kicad_pcb

## KiCad design schematics/ram-mar/ram-mar.kicad_pcb (2024-12-01)

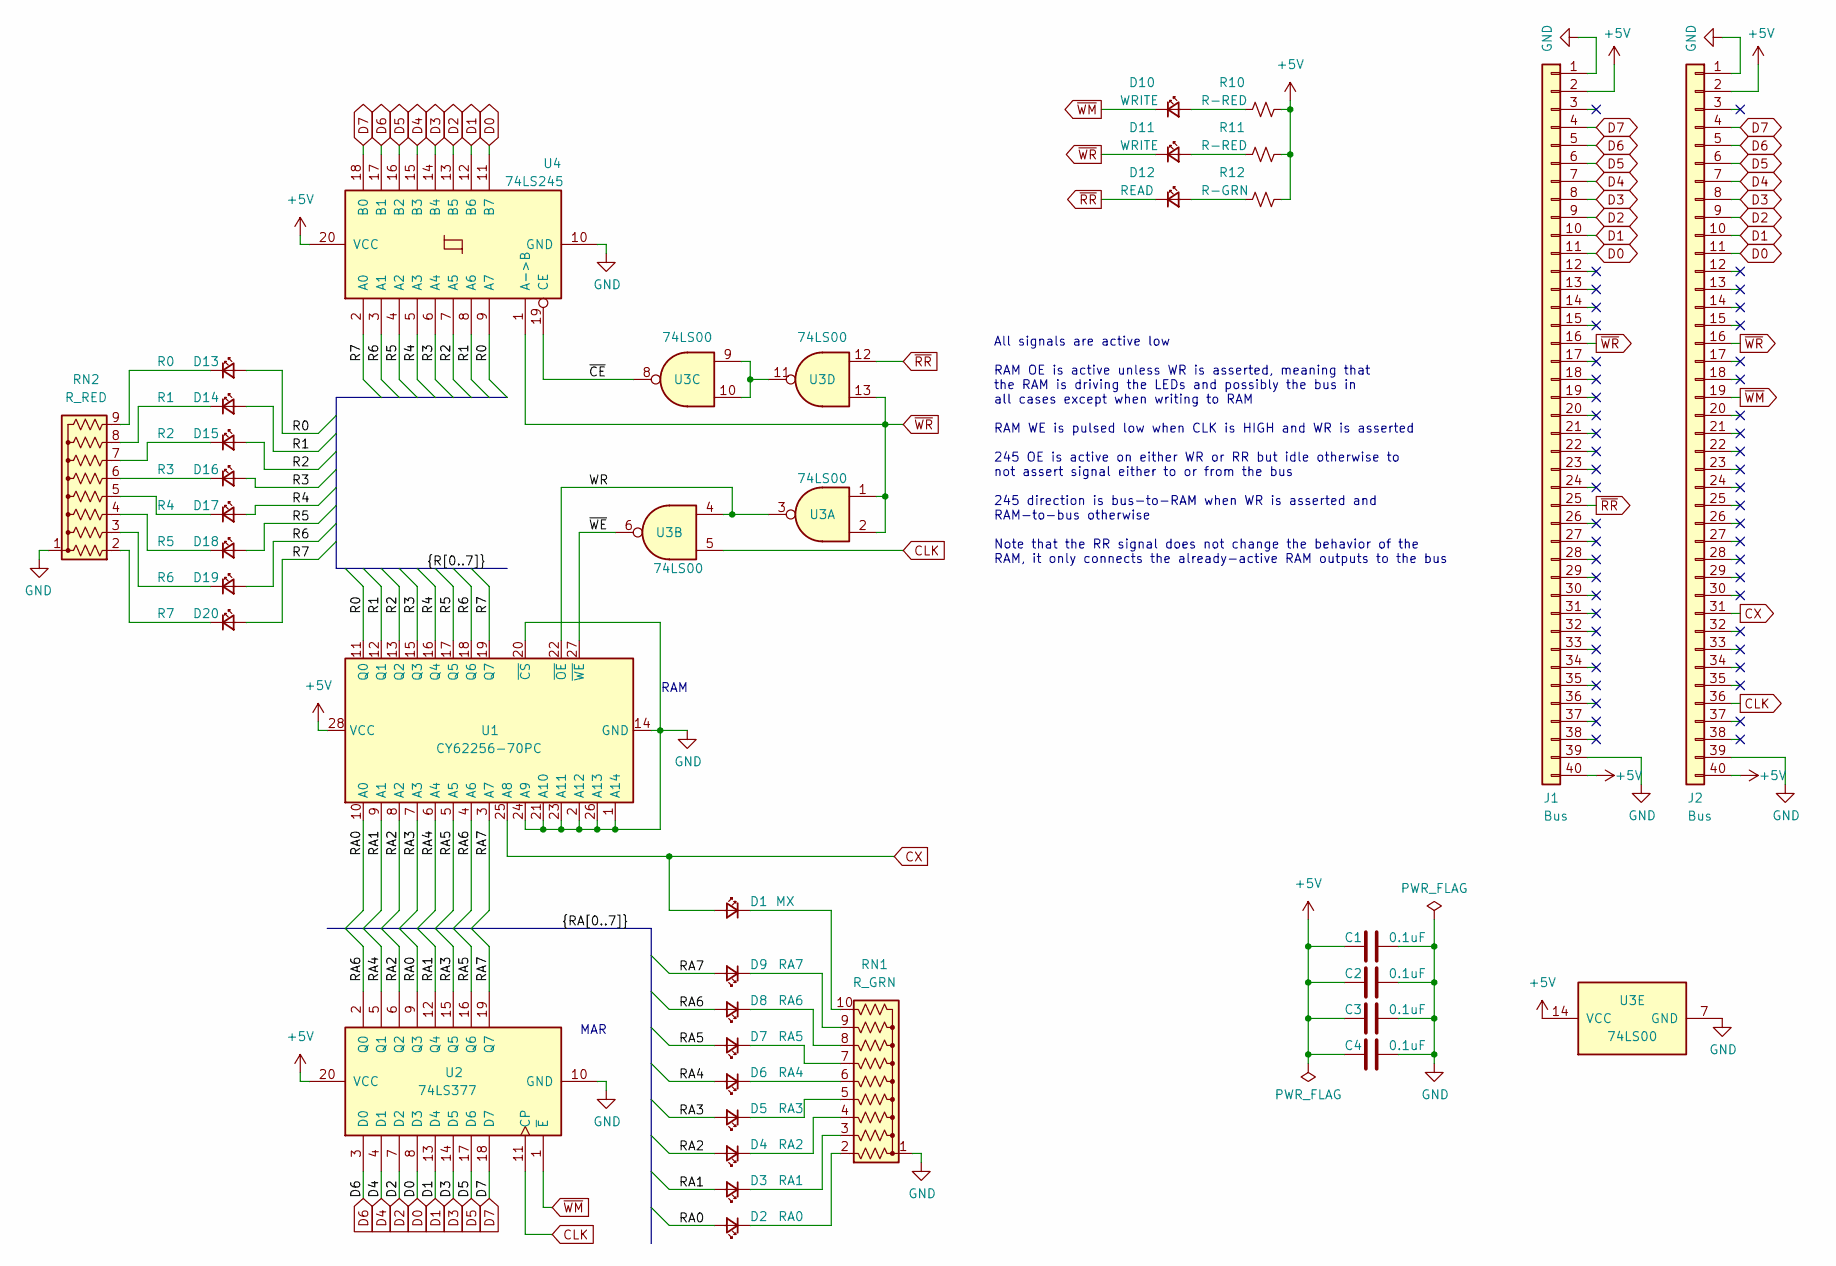
[picture p78: schematic ram-mar.kicad_sch, SAP-Plus RAM and MAR]

Parts:
C1, C2, C3, C4: 0.1uF; C_Disc_D3.0mm_W2.0mm_P2.50mm
D1: MX; LED_D3.0mm
D2: RA0; LED_D3.0mm
D3: RA1; LED_D3.0mm
D4: RA2; LED_D3.0mm
D5: RA3; LED_D3.0mm
D6: RA4; LED_D3.0mm
D7: RA5; LED_D3.0mm
D8: RA6; LED_D3.0mm
D9: RA7; LED_D3.0mm
D10, D11: WRITE; LED_D3.0mm
D12: READ; LED_D3.0mm
D13: R0; LED_D3.0mm
D14: R1; LED_D3.0mm
D15: R2; LED_D3.0mm
D16: R3; LED_D3.0mm
D17: R4; LED_D3.0mm
D18: R5; LED_D3.0mm
D19: R6; LED_D3.0mm
D20: R7; LED_D3.0mm
J1, J2: Bus; PinHeader_1x40_P2.54mm_Vertical
R10, R11: R-RED; R_Axial_DIN0207_L6.3mm_D2.5mm_P10.16mm_Horizontal
R12: R-GRN; R_Axial_DIN0207_L6.3mm_D2.5mm_P10.16mm_Horizontal
RN1: R_GRN; R_Array_SIP10
RN2: R_RED; R_Array_SIP9
U1: CY62256-70PC; DIP-28_W15.24mm_Socket
U2: 74LS377; DIP-20_W7.62mm
U3: 74LS00; DIP-14_W7.62mm
U4: 74LS245; DIP-20_W7.62mm

Connections:
+5V: C1.2, C2.2, C3.2, C4.2, J1.2, J1.40, J2.2, J2.40, R10.1, R11.1, R12.1, U1.28 (VCC), U2.20 (VCC), U3.14 (VCC), U4.20 (VCC)
/R0: D13.2 (A), U1.11 (Q0), U4.9 (A7)
/R1: D14.2 (A), U1.12 (Q1), U4.8 (A6)
/R2: D15.2 (A), U1.13 (Q2), U4.7 (A5)
/R3: D16.2 (A), U1.15 (Q3), U4.6 (A4)
/R4: D17.2 (A), U1.16 (Q4), U4.5 (A3)
/R5: D18.2 (A), U1.17 (Q5), U4.4 (A2)
/R6: D19.2 (A), U1.18 (Q6), U4.3 (A1)
/R7: D20.2 (A), U1.19 (Q7), U4.2 (A0)
/RA0: D2.2 (A), U1.10 (A0), U2.9 (Q3)
/RA1: D3.2 (A), U1.9 (A1), U2.12 (Q4)
/RA2: D4.2 (A), U1.8 (A2), U2.6 (Q2)
/RA3: D5.2 (A), U1.7 (A3), U2.15 (Q5)
/RA4: D6.2 (A), U1.6 (A4), U2.5 (Q1)
/RA5: D7.2 (A), U1.5 (A5), U2.16 (Q6)
/RA6: D8.2 (A), U1.4 (A6), U2.2 (Q0)
/RA7: D9.2 (A), U1.3 (A7), U2.19 (Q7)
/WR: U1.22 (~OE), U3.3, U3.4
/~CE: U3.8, U4.19 (CE)
/~WE: U1.27 (~WE), U3.6
CLK: J2.36, U2.11 (CP), U3.5
CX: D1.2 (A), J2.31, U1.25 (A8)
D0: J1.11, J2.11, U2.8 (D3), U4.11 (B7)
D1: J1.10, J2.10, U2.13 (D4), U4.12 (B6)
D2: J1.9, J2.9, U2.7 (D2), U4.13 (B5)
D3: J1.8, J2.8, U2.14 (D5), U4.14 (B4)
D4: J1.7, J2.7, U2.4 (D1), U4.15 (B3)
D5: J1.6, J2.6, U2.17 (D6), U4.16 (B2)
D6: J1.5, J2.5, U2.3 (D0), U4.17 (B1)
D7: J1.4, J2.4, U2.18 (D7), U4.18 (B0)
GND: C1.1, C2.1, C3.1, C4.1, J1.1, J1.39, J2.1, J2.39, RN1.1 (common), RN2.1 (common), U1.1 (A14), U1.2 (A12), U1.14 (GND), U1.20 (~CS), U1.21 (A10), U1.23 (A11), U1.24 (A9), U1.26 (A13), U2.10 (GND), U3.7 (GND), U4.10 (GND)
unnamed: D1.1 (K), RN1.10 (R9)
unnamed: D2.1 (K), RN1.2 (R1)
unnamed: D3.1 (K), RN1.3 (R2)
unnamed: D4.1 (K), RN1.4 (R3)
unnamed: D5.1 (K), RN1.5 (R4)
unnamed: D6.1 (K), RN1.6 (R5)
unnamed: D7.1 (K), RN1.7 (R6)
unnamed: D8.1 (K), RN1.8 (R7)
unnamed: D9.1 (K), RN1.9 (R8)
unnamed: D10.2 (A), R10.2
unnamed: D11.2 (A), R11.2
unnamed: D12.2 (A), R12.2
unnamed: D13.1 (K), RN2.9 (R8)
unnamed: D14.1 (K), RN2.8 (R7)
unnamed: D15.1 (K), RN2.7 (R6)
unnamed: D16.1 (K), RN2.6 (R5)
unnamed: D17.1 (K), RN2.5 (R4)
unnamed: D18.1 (K), RN2.4 (R3)
unnamed: D19.1 (K), RN2.3 (R2)
unnamed: D20.1 (K), RN2.2 (R1)
unnamed: U3.9, U3.10, U3.11
~RR: D12.1 (K), J1.25, U3.12
~WM: D10.1 (K), J2.19, U2.1 (~E)
~WR: D11.1 (K), J1.16, J2.16, U3.1, U3.2, U3.13, U4.1 (A->B)

Notes on the sheet:
All signals are active low RAM OE is active unless WR is asserted, meaning that the RAM is driving the LEDs and possibly the bus in all cases except when writing to RAM RAM WE is pulsed low when CLK is HIGH and WR is asserted 245 OE is active on either WR or RR but idle otherwise to not assert sign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
MAR
RAM
