TomNisbet/sap-plus/schematics/ram-mar/ram-mar.kicad_pcb

## KiCad design schematics/ram-mar/ram-mar.kicad_pcb (continued)

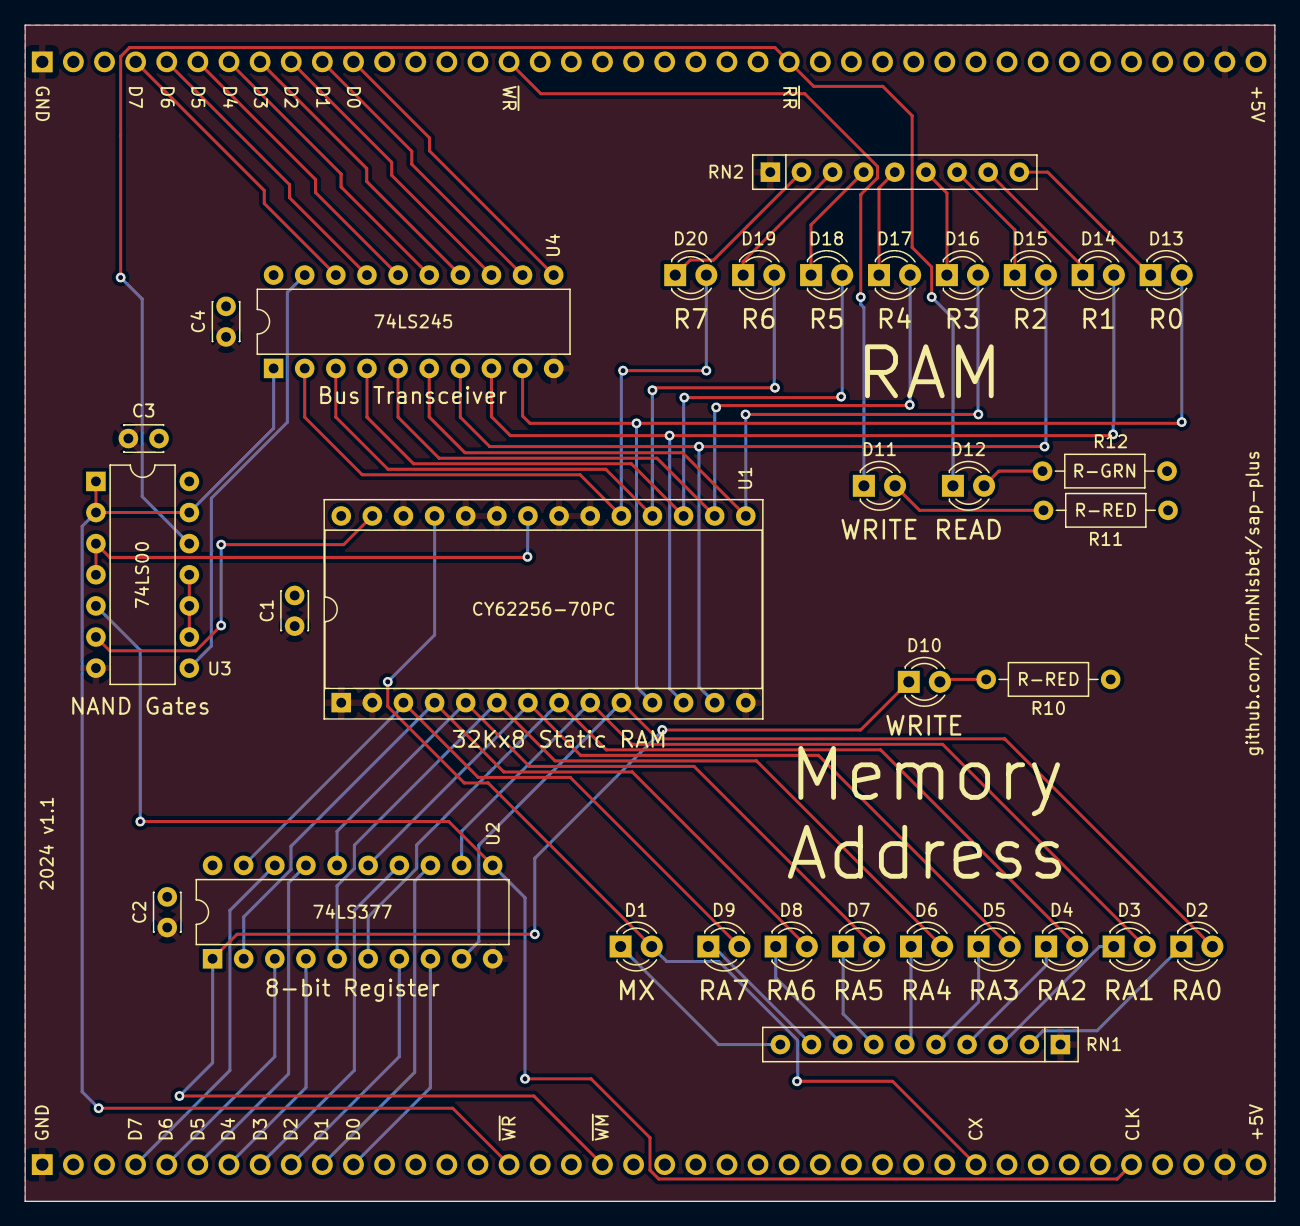
[picture p79: board ram-mar.kicad_pcb from above]

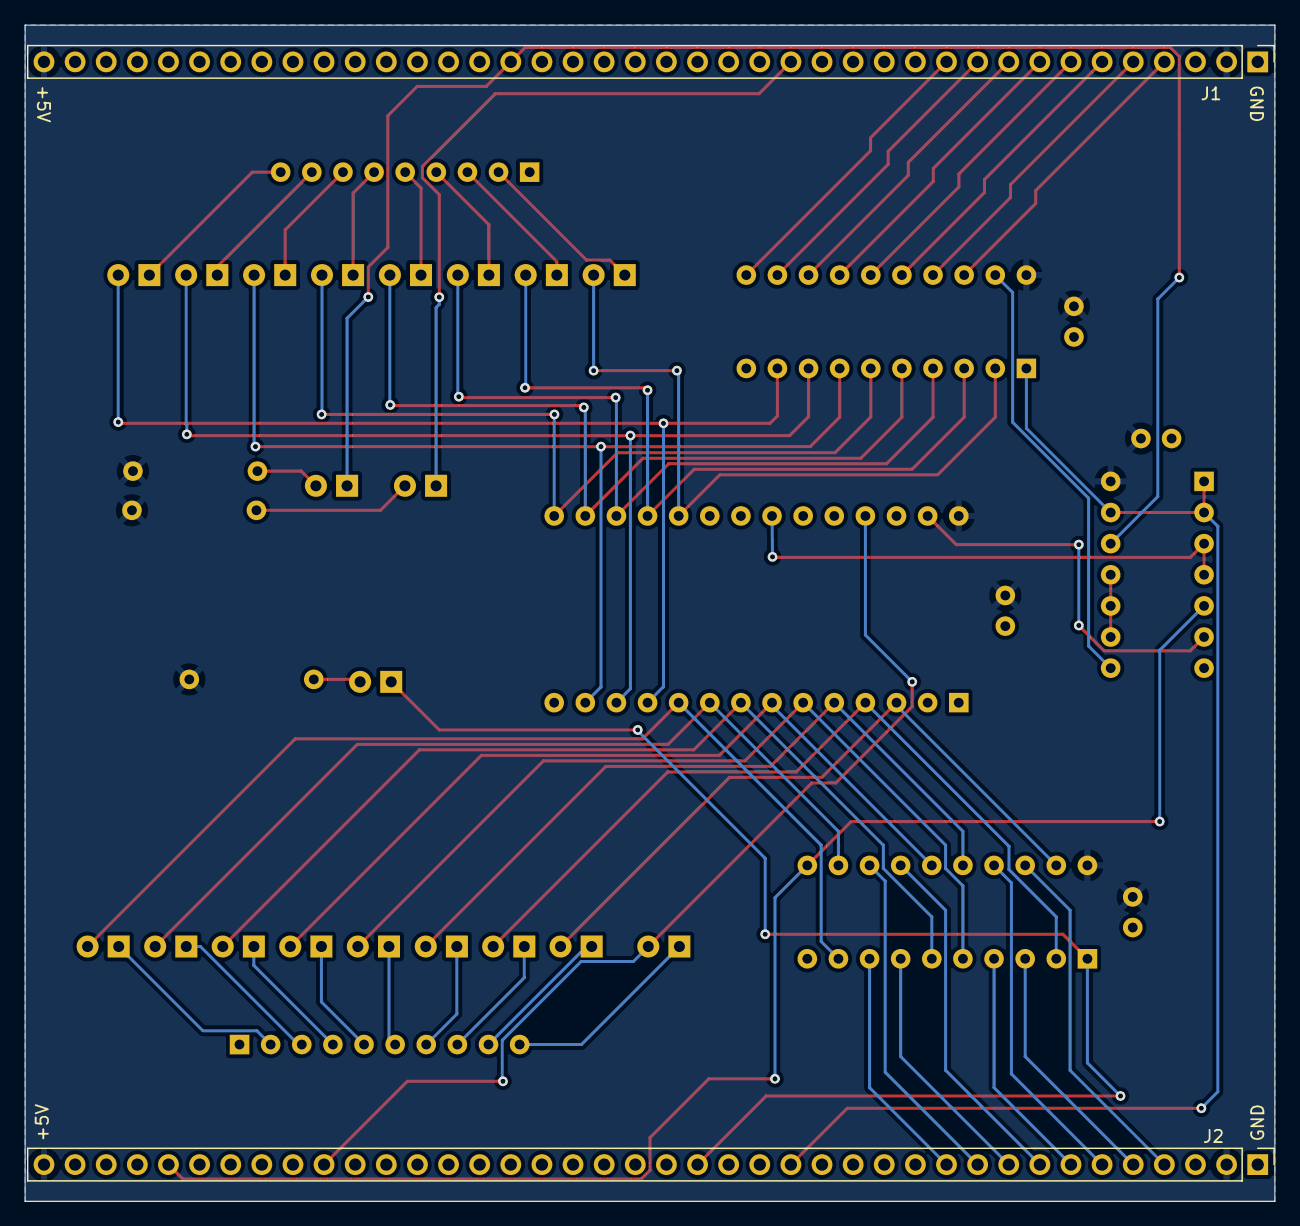
[picture p80: board ram-mar.kicad_pcb from below]

Board: 2 copper layers, 102.0 x 96.0 mm, 35 parts (2 on the bottom side), 55 nets.
