TomNisbet/sap-plus/schematics/microcode/microcode.kicad_pcb

## KiCad design schematics/microcode/microcode.kicad_pcb (2024-12-01)

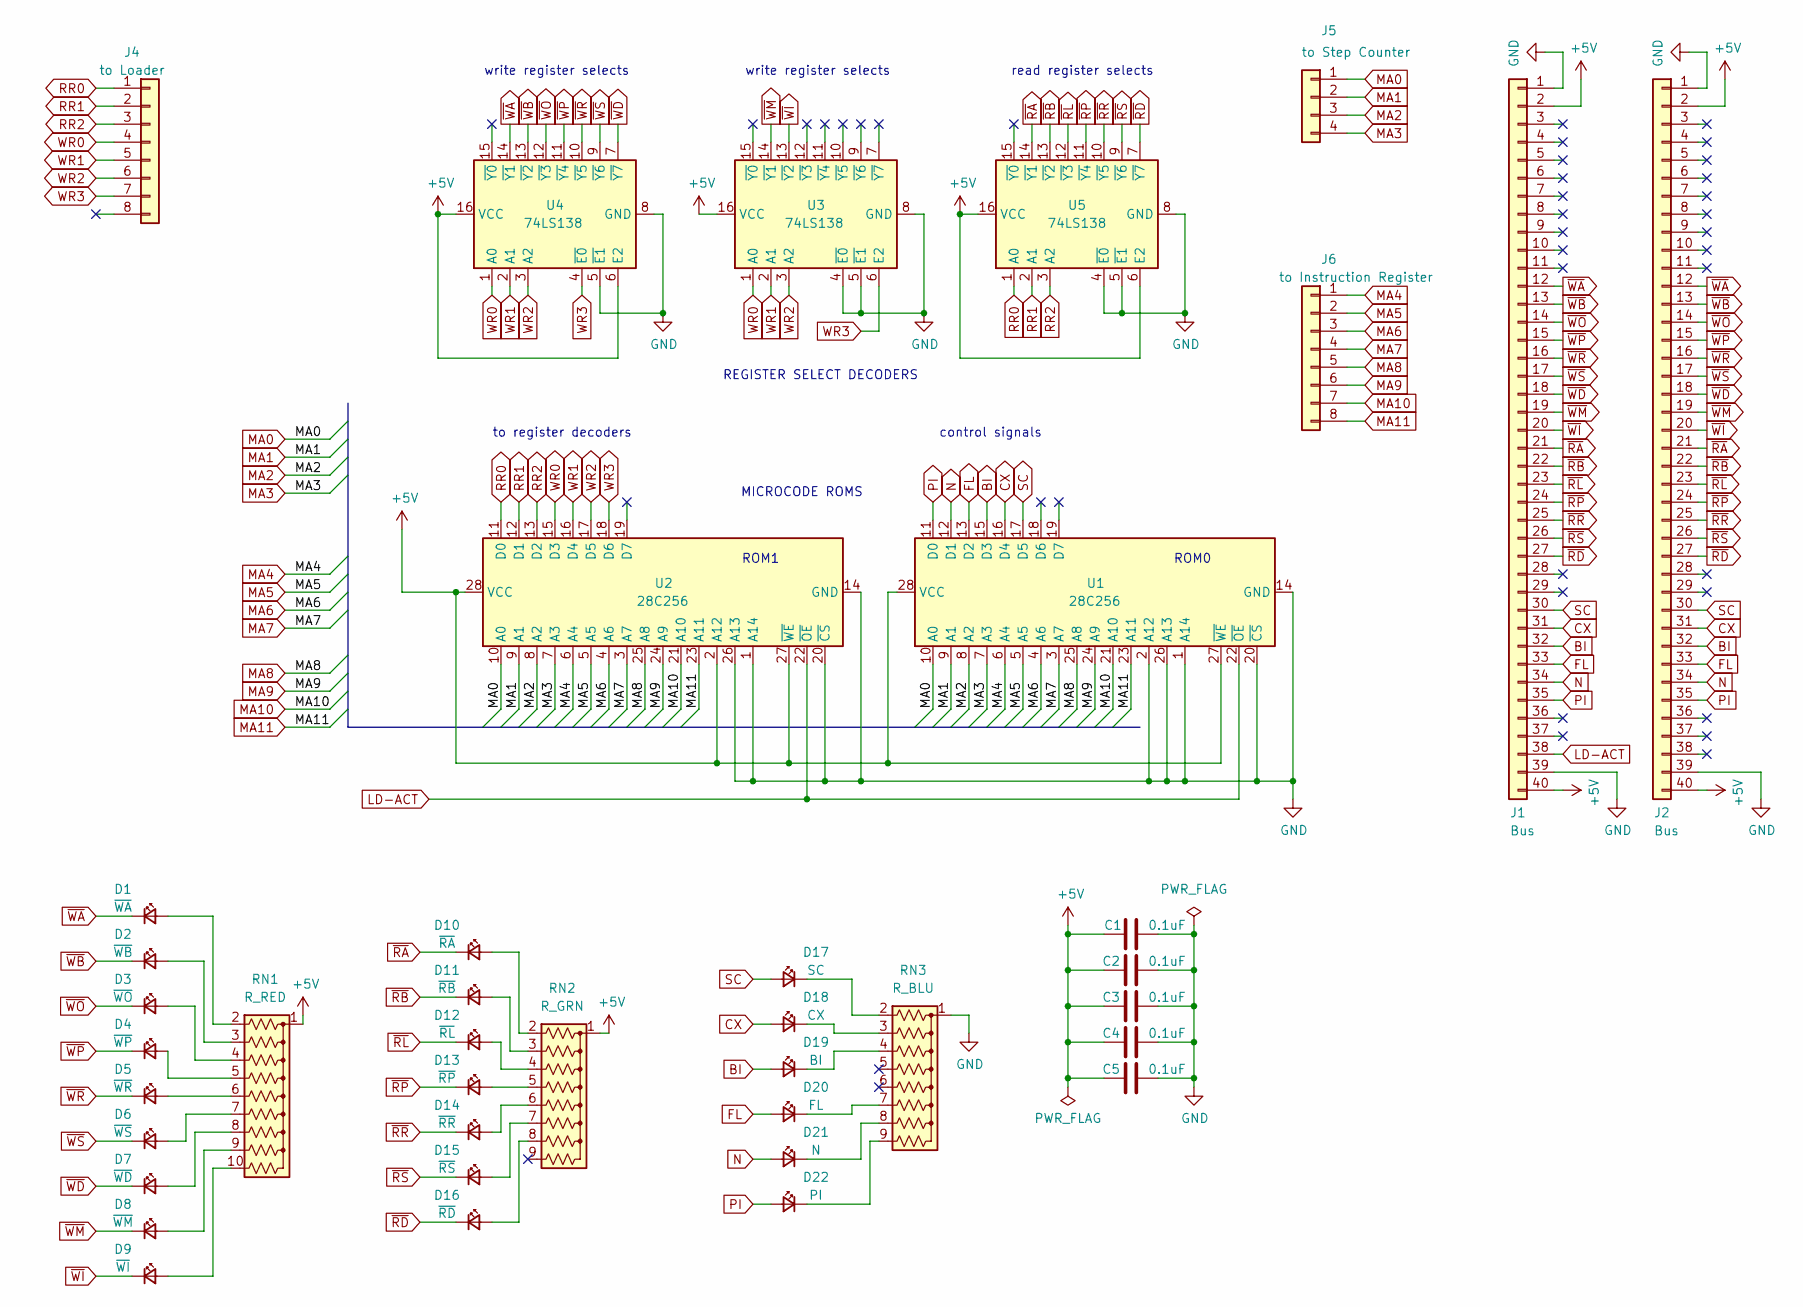
[picture p81: schematic microcode.kicad_sch, SAP-Plus Microcode ROMs]

Parts:
C1, C2, C3, C4, C5: 0.1uF; C_Disc_D3.0mm_W1.6mm_P2.50mm
D1: ~{WA}; LED_D3.0mm
D2: ~{WB}; LED_D3.0mm
D3: ~{WO}; LED_D3.0mm
D4: ~{WP}; LED_D3.0mm
D5: ~{WR}; LED_D3.0mm
D6: ~{WS}; LED_D3.0mm
D7: ~{WD}; LED_D3.0mm
D8: ~{WM}; LED_D3.0mm
D9: ~{WI}; LED_D3.0mm
D10: ~{RA}; LED_D3.0mm
D11: ~{RB}; LED_D3.0mm
D12: ~{RL}; LED_D3.0mm
D13: ~{RP}; LED_D3.0mm
D14: ~{RR}; LED_D3.0mm
D15: ~{RS}; LED_D3.0mm
D16: ~{RD}; LED_D3.0mm
D17: SC; LED_D3.0mm
D18: CX; LED_D3.0mm
D19: BI; LED_D3.0mm
D20: FL; LED_D3.0mm
D21: N; LED_D3.0mm
D22: PI; LED_D3.0mm
J1, J2: Bus; PinHeader_1x40_P2.54mm_Vertical
J4: to Loader; PinHeader_1x08_P2.54mm_Vertical
J5: to Step Counter; PinHeader_1x04_P2.54mm_Vertical
J6: to Instruction Register; PinHeader_1x08_P2.54mm_Vertical
RN1: R_RED; R_Array_SIP10
RN2: R_GRN; R_Array_SIP9
RN3: R_BLU; R_Array_SIP9
U1, U2: 28C256; DIP-28_W15.24mm_Socket
U3, U4, U5: 74LS138; DIP-16_W7.62mm

Connections:
+5V: C1.2, C2.2, C3.2, C4.2, C5.2, J1.2, J1.40, J2.2, J2.40, RN1.1 (common), RN2.1 (common), U1.27 (~WE), U1.28 (VCC), U2.2 (A12), U2.27 (~WE), U2.28 (VCC), U3.16 (VCC), U4.6 (E2), U4.16 (VCC), U5.6 (E2), U5.16 (VCC)
BI: D19.2 (A), J1.32, J2.32, U1.15 (D3)
CX: D18.2 (A), J1.31, J2.31, U1.16 (D4)
FL: D20.2 (A), J1.33, J2.33, U1.13 (D2)
GND: C1.1, C2.1, C3.1, C4.1, C5.1, J1.1, J1.39, J2.1, J2.39, RN3.1 (common), U1.1 (A14), U1.2 (A12), U1.14 (GND), U1.20 (~CS), U1.26 (A13), U2.1 (A14), U2.14 (GND), U2.20 (~CS), U2.26 (A13), U3.4 (~E0), U3.5 (~E1), U3.8 (GND), U4.5 (~E1), U4.8 (GND), U5.4 (~E0), U5.5 (~E1), U5.8 (GND)
LD-ACT: J1.38, U1.22 (~OE), U2.22 (~OE)
MA0: J5.1, U1.10 (A0), U2.10 (A0)
MA1: J5.2, U1.9 (A1), U2.9 (A1)
MA2: J5.3, U1.8 (A2), U2.8 (A2)
MA3: J5.4, U1.7 (A3), U2.7 (A3)
MA4: J6.1, U1.6 (A4), U2.6 (A4)
MA5: J6.2, U1.5 (A5), U2.5 (A5)
MA6: J6.3, U1.4 (A6), U2.4 (A6)
MA7: J6.4, U1.3 (A7), U2.3 (A7)
MA8: J6.5, U1.25 (A8), U2.25 (A8)
MA9: J6.6, U1.24 (A9), U2.24 (A9)
MA10: J6.7, U1.21 (A10), U2.21 (A10)
MA11: J6.8, U1.23 (A11), U2.23 (A11)
N: D21.2 (A), J1.34, J2.34, U1.12 (D1)
unnamed: D1.2 (A), RN1.2 (R1)
unnamed: D2.2 (A), RN1.3 (R2)
unnamed: D3.2 (A), RN1.4 (R3)
unnamed: D4.2 (A), RN1.5 (R4)
unnamed: D5.2 (A), RN1.6 (R5)
unnamed: D6.2 (A), RN1.7 (R6)
unnamed: D7.2 (A), RN1.8 (R7)
unnamed: D8.2 (A), RN1.9 (R8)
unnamed: D9.2 (A), RN1.10 (R9)
unnamed: D10.2 (A), RN2.2 (R1)
unnamed: D11.2 (A), RN2.3 (R2)
unnamed: D12.2 (A), RN2.4 (R3)
unnamed: D13.2 (A), RN2.5 (R4)
unnamed: D14.2 (A), RN2.6 (R5)
unnamed: D15.2 (A), RN2.7 (R6)
unnamed: D16.2 (A), RN2.8 (R7)
unnamed: D17.1 (K), RN3.2 (R1)
unnamed: D18.1 (K), RN3.3 (R2)
unnamed: D19.1 (K), RN3.4 (R3)
unnamed: D20.1 (K), RN3.7 (R6)
unnamed: D21.1 (K), RN3.8 (R7)
unnamed: D22.1 (K), RN3.9 (R8)
PI: D22.2 (A), J1.35, J2.35, U1.11 (D0)
RR0: J4.1, U2.11 (D0), U5.1 (A0)
RR1: J4.2, U2.12 (D1), U5.2 (A1)
RR2: J4.3, U2.13 (D2), U5.3 (A2)
SC: D17.2 (A), J1.30, J2.30, U1.17 (D5)
WR0: J4.4, U2.15 (D3), U3.1 (A0), U4.1 (A0)
WR1: J4.5, U2.16 (D4), U3.2 (A1), U4.2 (A1)
WR2: J4.6, U2.17 (D5), U3.3 (A2), U4.3 (A2)
WR3: J4.7, U2.18 (D6), U3.6 (E2), U4.4 (~E0)
~RA: D10.1 (K), J1.21, J2.21, U5.14 (~Y1)
~RB: D11.1 (K), J1.22, J2.22, U5.13 (~Y2)
~RD: D16.1 (K), J1.27, J2.27, U5.7 (~Y7)
~RL: D12.1 (K), J1.23, J2.23, U5.12 (~Y3)
~RP: D13.1 (K), J1.24, J2.24, U5.11 (~Y4)
~RR: D14.1 (K), J1.25, J2.25, U5.10 (~Y5)
~RS: D15.1 (K), J1.26, J2.26, U5.9 (~Y6)
~WA: D1.1 (K), J1.12, J2.12, U4.14 (~Y1)
~WB: D2.1 (K), J1.13, J2.13, U4.13 (~Y2)
~WD: D7.1 (K), J1.18, J2.18, U4.7 (~Y7)
~WI: D9.1 (K), J1.20, J2.20, U3.13 (~Y2)
~WM: D8.1 (K), J1.19, J2.19, U3.14 (~Y1)
~WO: D3.1 (K), J1.14, J2.14, U4.12 (~Y3)
~WP: D4.1 (K), J1.15, J2.15, U4.11 (~Y4)
~WR: D5.1 (K), J1.16, J2.16, U4.10 (~Y5)
~WS: D6.1 (K), J1.17, J2.17, U4.9 (~Y6)

Notes on the sheet:
read register selects
to register decoders
write register selects
REGISTER SELECT DECODERS
control signals
MICROCODE ROMS
ROM1
ROM0

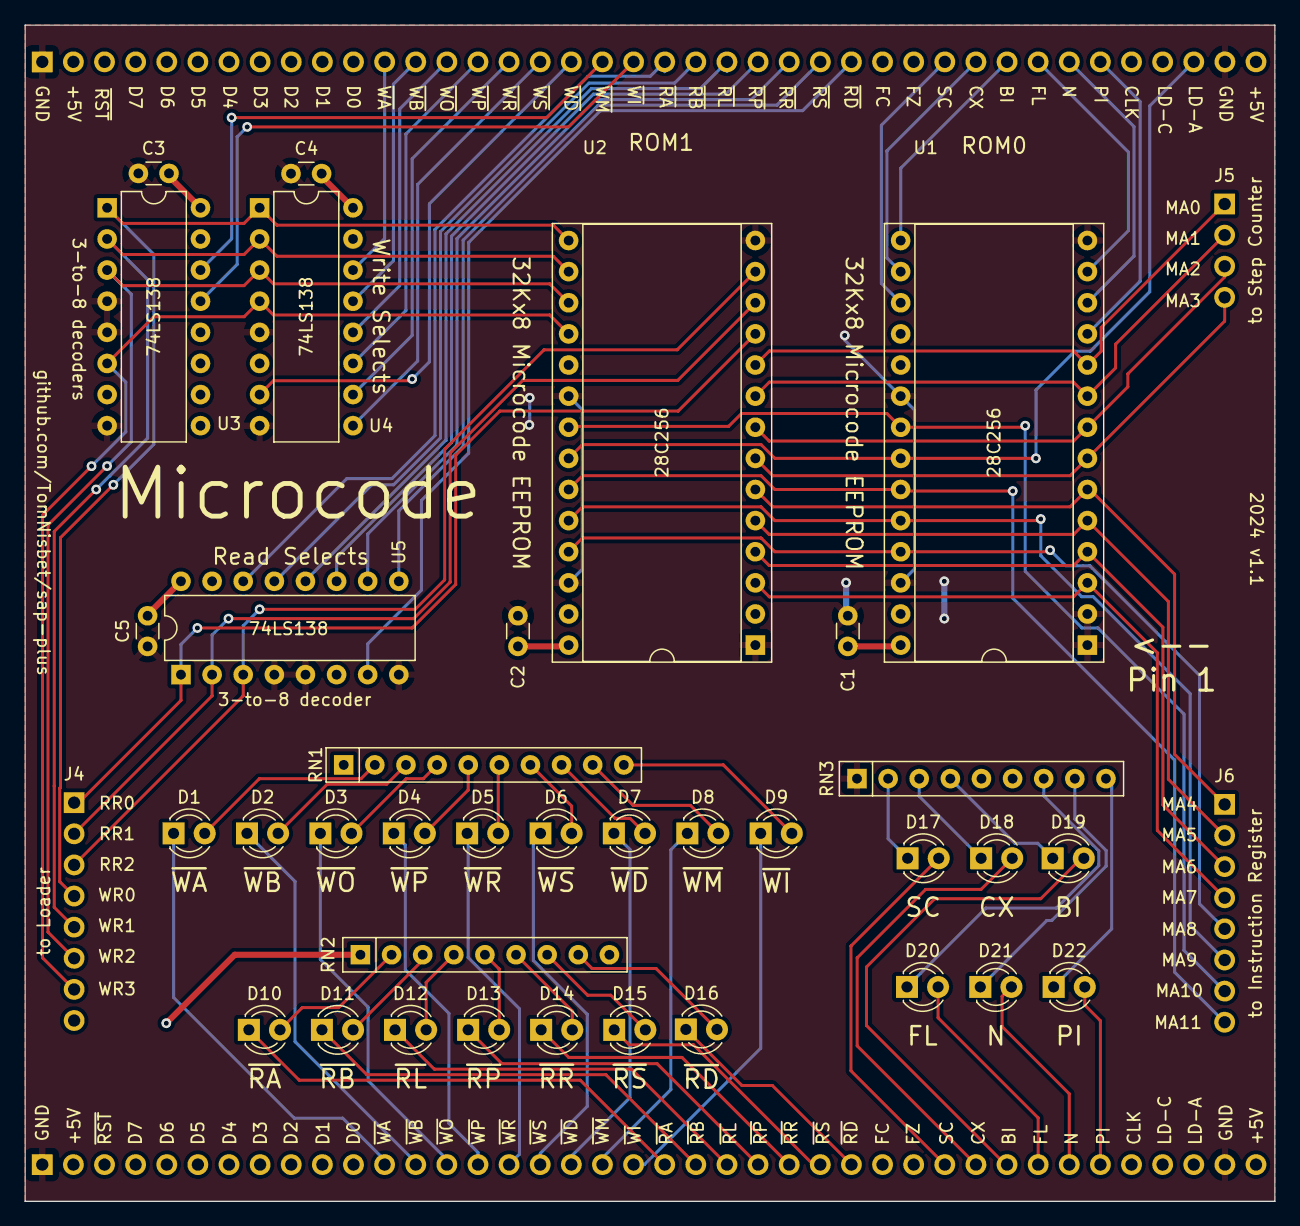
[picture p82: board microcode.kicad_pcb from above]

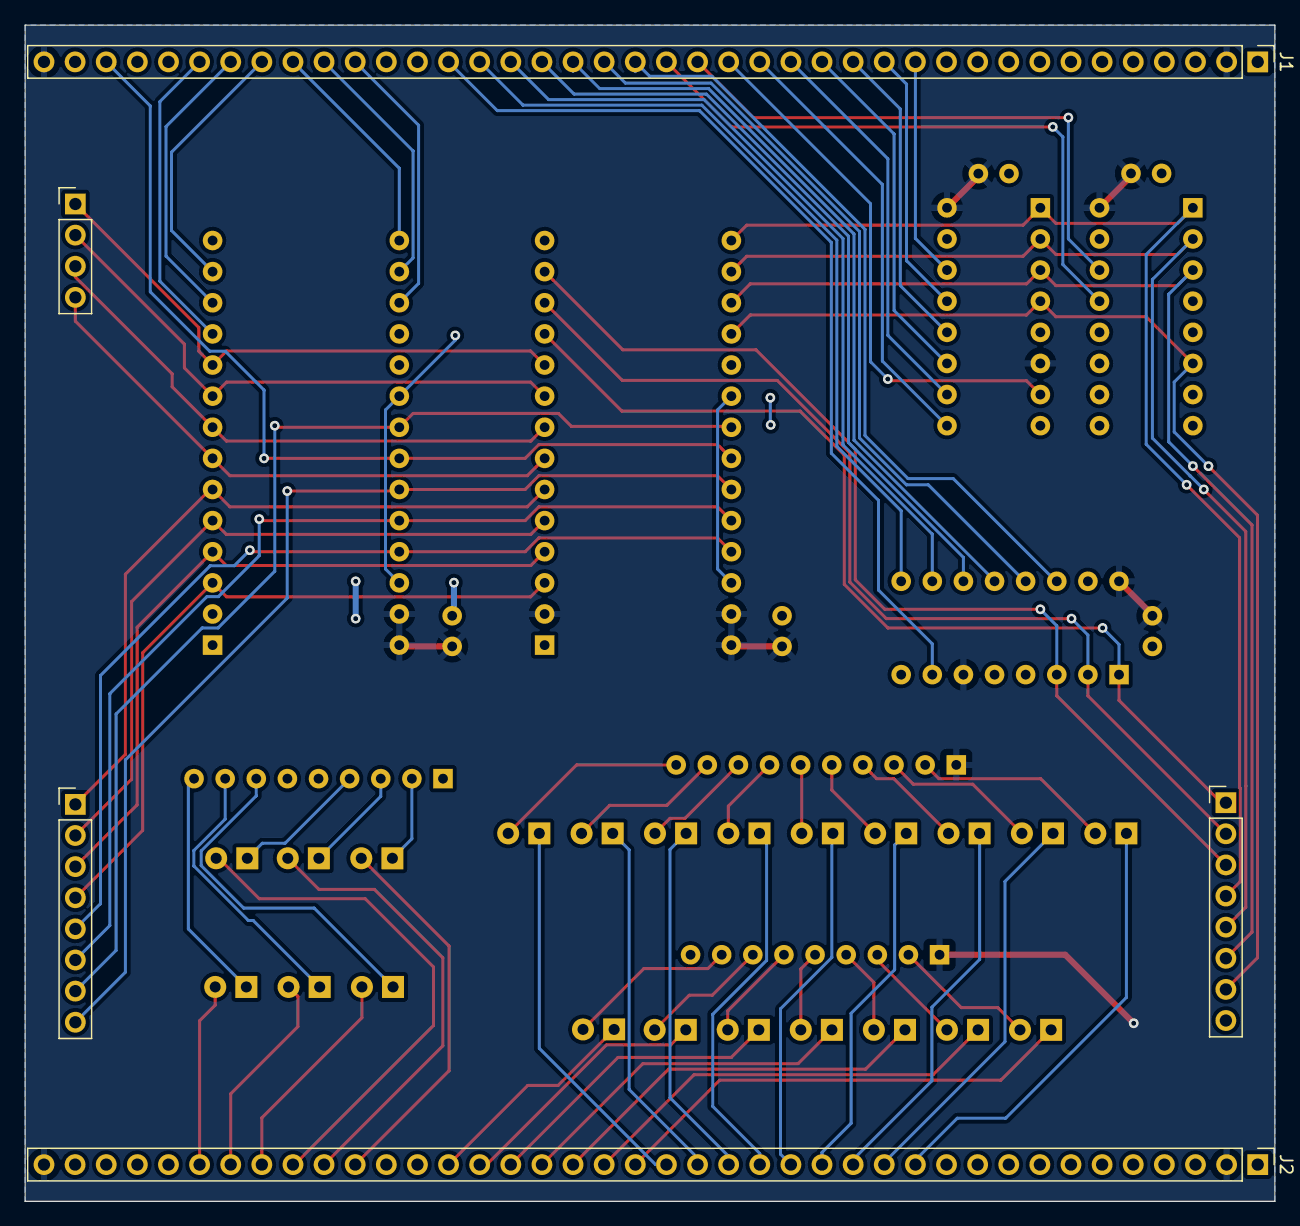
[picture p83: board microcode.kicad_pcb from below]

Board: 2 copper layers, 102.0 x 96.0 mm, 40 parts (5 on the bottom side), 66 nets.
