TomNisbet/sap-plus/schematics/output/output.kicad_pcb

## KiCad design schematics/output/output.kicad_pcb (2024-11-30)

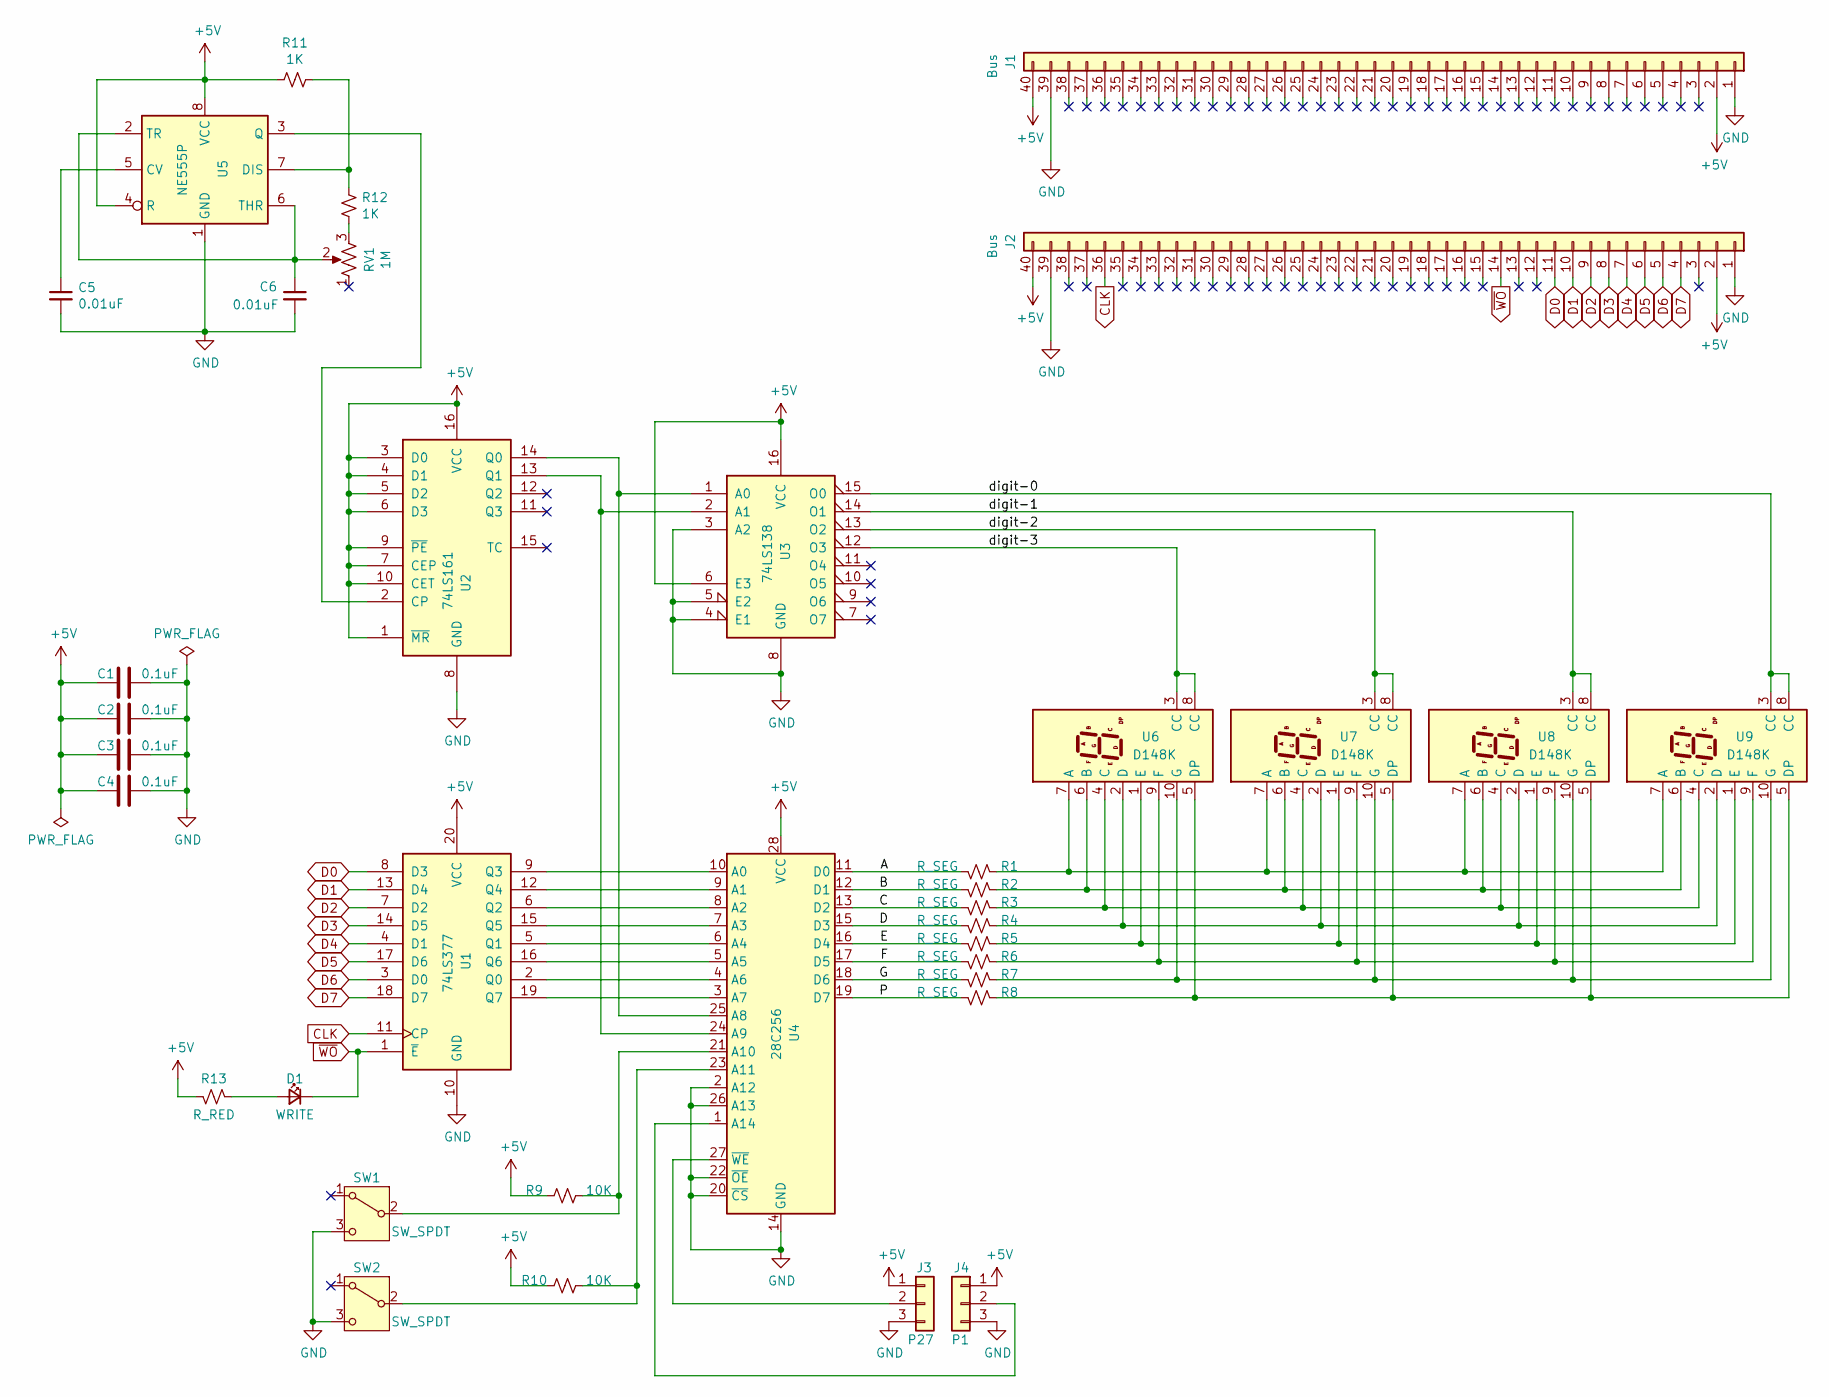
[picture p84: schematic output.kicad_sch, SAP-Plus Output Register]

Parts:
C1, C2, C3, C4: 0.1uF; C_Disc_D3.0mm_W1.6mm_P2.50mm
C5, C6: 0.01uF; C_Disc_D3.0mm_W1.6mm_P2.50mm
D1: WRITE; LED_D3.0mm
J1, J2: Bus; PinHeader_1x40_P2.54mm_Vertical
J3: P27; PinHeader_1x03_P2.54mm_Vertical
J4: P1; PinHeader_1x03_P2.54mm_Vertical
R1, R2, R3, R4, R5, R6, R7, R8: R_SEG; R_Axial_DIN0207_L6.3mm_D2.5mm_P10.16mm_Horizontal
R9, R10: 10K; R_Axial_DIN0207_L6.3mm_D2.5mm_P10.16mm_Horizontal
R11, R12: 1K; R_Axial_DIN0207_L6.3mm_D2.5mm_P10.16mm_Horizontal
R13: R_RED; R_Axial_DIN0207_L6.3mm_D2.5mm_P10.16mm_Horizontal
RV1: 1M; Potentiometer_Bourns_3386F_Vertical
SW1, SW2: SW_SPDT; PinHeader_1x03_P2.54mm_Vertical
U1: 74LS377; DIP-20_W7.62mm
U2: 74LS161; DIP-16_W7.62mm
U3: 74LS138; DIP-16_W7.62mm
U4: 28C256; DIP-28_W15.24mm
U5: NE555P; DIP-8_W7.62mm
U6, U7, U8, U9: D148K; D1X8K

Connections:
+5V: C1.2, C2.2, C3.2, C4.2, J1.2, J1.40, J2.2, J2.40, J3.1, J4.1, R9.1, R10.1, R11.2, R13.2, U1.20 (VCC), U2.1 (~MR), U2.3 (D0), U2.4 (D1), U2.5 (D2), U2.6 (D3), U2.7 (CEP), U2.9 (~PE), U2.10 (CET), U2.16 (VCC), U3.6 (E3), U3.16 (VCC), U4.28 (VCC), U5.4 (R), U5.8 (VCC)
/A: R1.2, U4.11 (D0)
/B: R2.2, U4.12 (D1)
/C: R3.2, U4.13 (D2)
/D: R4.2, U4.15 (D3)
/E: R5.2, U4.16 (D4)
/F: R6.2, U4.17 (D5)
/G: R7.2, U4.18 (D6)
/P: R8.2, U4.19 (D7)
/digit-0: U3.15 (O0), U9.3 (CC), U9.8 (CC)
/digit-1: U3.14 (O1), U8.3 (CC), U8.8 (CC)
/digit-2: U3.13 (O2), U7.3 (CC), U7.8 (CC)
/digit-3: U3.12 (O3), U6.3 (CC), U6.8 (CC)
CLK: J2.36, U1.11 (CP)
D0: J2.11, U1.8 (D3)
D1: J2.10, U1.13 (D4)
D2: J2.9, U1.7 (D2)
D3: J2.8, U1.14 (D5)
D4: J2.7, U1.4 (D1)
D5: J2.6, U1.17 (D6)
D6: J2.5, U1.3 (D0)
D7: J2.4, U1.18 (D7)
GND: C1.1, C2.1, C3.1, C4.1, C5.2, C6.2, J1.1, J1.39, J2.1, J2.39, J3.3, J4.3, SW1.3 (C), SW2.3 (C), U1.10 (GND), U2.8 (GND), U3.3 (A2), U3.4 (E1), U3.5 (E2), U3.8 (GND), U4.2 (A12), U4.14 (GND), U4.20 (~CS), U4.22 (~OE), U4.26 (A13), U5.1 (GND)
unnamed: D1.2 (A), R13.1
unnamed: J3.2, U4.27 (~WE)
unnamed: J4.2, U4.1 (A14)
unnamed: R12.1, RV1.3
unnamed: R9.2, SW1.2 (B), U4.21 (A10)
unnamed: R10.2, SW2.2 (B), U4.23 (A11)
unnamed: U1.2 (Q0), U4.4 (A6)
unnamed: U1.5 (Q1), U4.6 (A4)
unnamed: U1.6 (Q2), U4.8 (A2)
unnamed: U1.9 (Q3), U4.10 (A0)
unnamed: U1.12 (Q4), U4.9 (A1)
unnamed: U1.15 (Q5), U4.7 (A3)
unnamed: U1.16 (Q6), U4.5 (A5)
unnamed: U1.19 (Q7), U4.3 (A7)
unnamed: U2.2 (CP), U5.3 (Q)
unnamed: U2.14 (Q0), U3.1 (A0), U4.25 (A8)
unnamed: U2.13 (Q1), U3.2 (A1), U4.24 (A9)
unnamed: C5.1, U5.5 (CV)
unnamed: R11.1, R12.2, U5.7 (DIS)
unnamed: C6.1, RV1.2, U5.2 (TR), U5.6 (THR)
unnamed: R1.1, U6.7 (A), U7.7 (A), U8.7 (A), U9.7 (A)
unnamed: R2.1, U6.6 (B), U7.6 (B), U8.6 (B), U9.6 (B)
unnamed: R3.1, U6.4 (C), U7.4 (C), U8.4 (C), U9.4 (C)
unnamed: R4.1, U6.2 (D), U7.2 (D), U8.2 (D), U9.2 (D)
unnamed: R8.1, U6.5 (DP), U7.5 (DP), U8.5 (DP), U9.5 (DP)
unnamed: R5.1, U6.1 (E), U7.1 (E), U8.1 (E), U9.1 (E)
unnamed: R6.1, U6.9 (F), U7.9 (F), U8.9 (F), U9.9 (F)
unnamed: R7.1, U6.10 (G), U7.10 (G), U8.10 (G), U9.10 (G)
~WO: D1.1 (K), J2.14, U1.1 (~E)

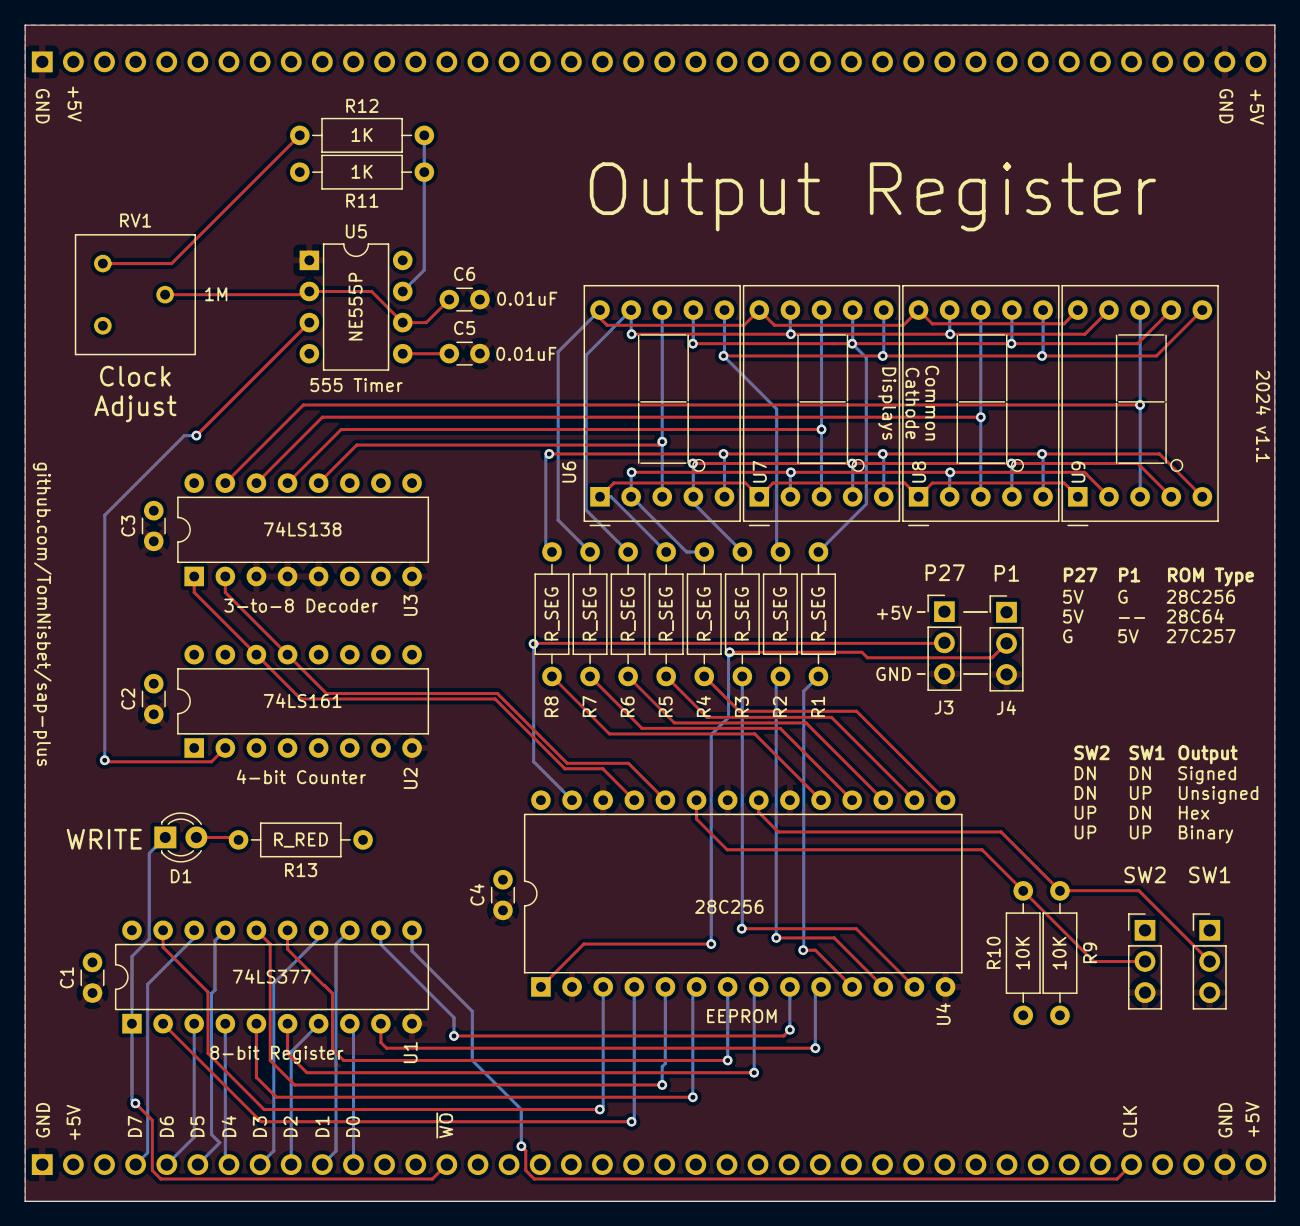
[picture p85: board output.kicad_pcb from above]

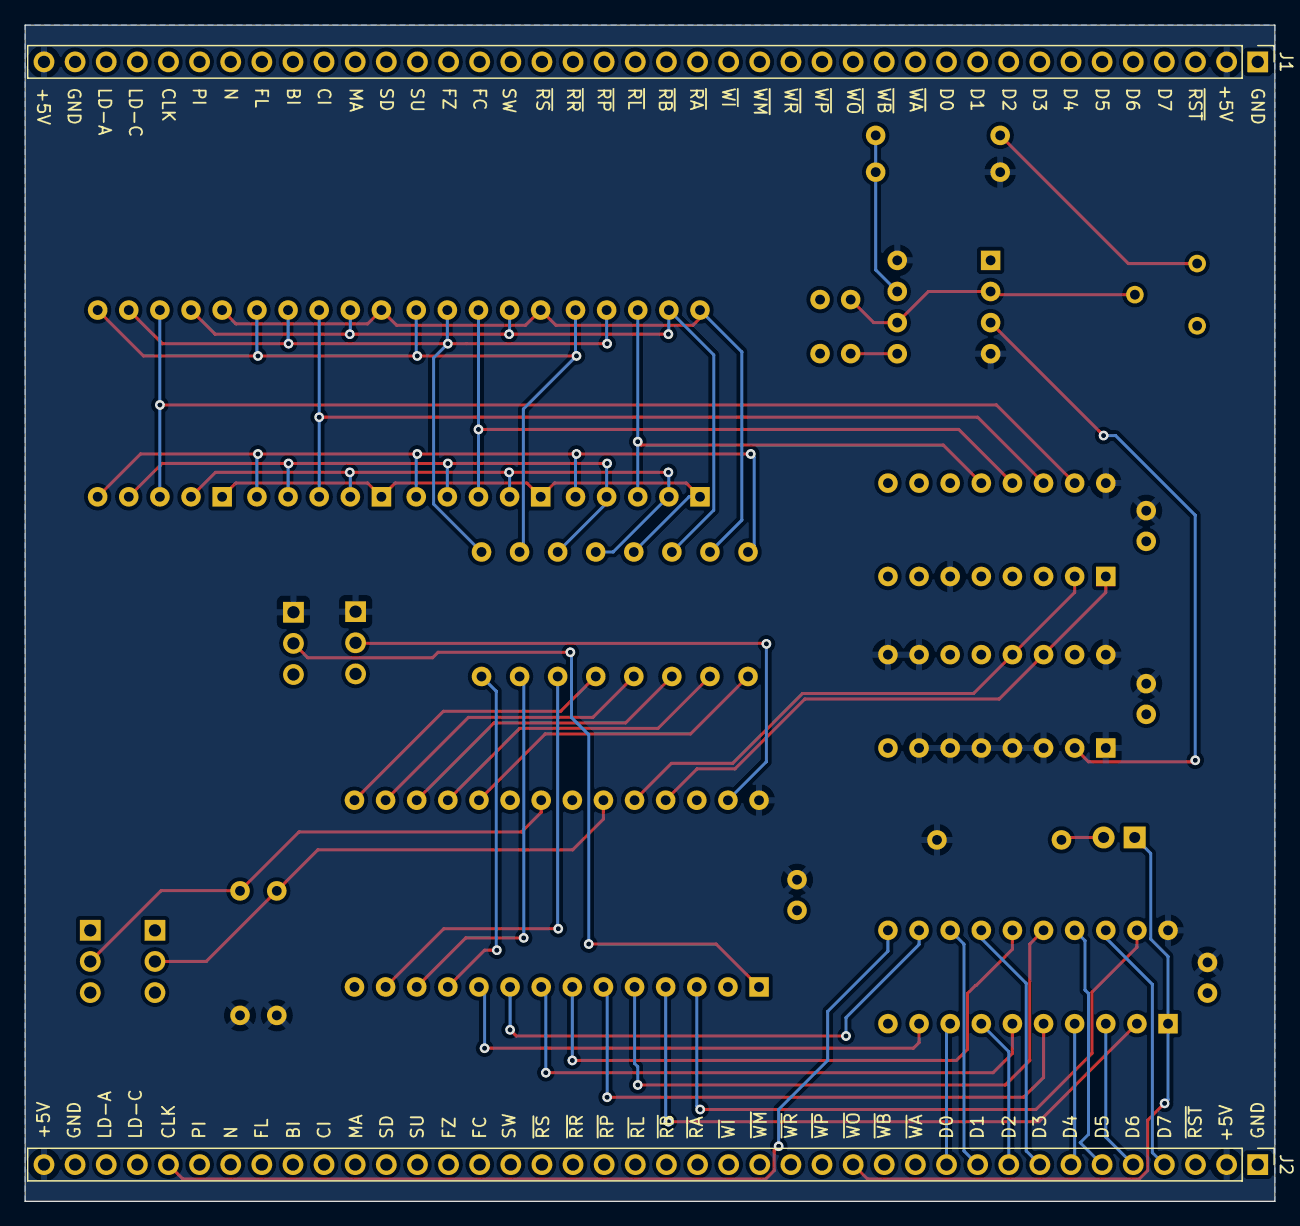
[picture p86: board output.kicad_pcb from below]

Board: 2 copper layers, 102.0 x 96.0 mm, 36 parts (2 on the bottom side), 52 nets.
