TomNisbet/sap-plus/schematics/backplane/backplane.kicad_pcb

## KiCad design schematics/backplane/backplane.kicad_pcb (2024-11-30)

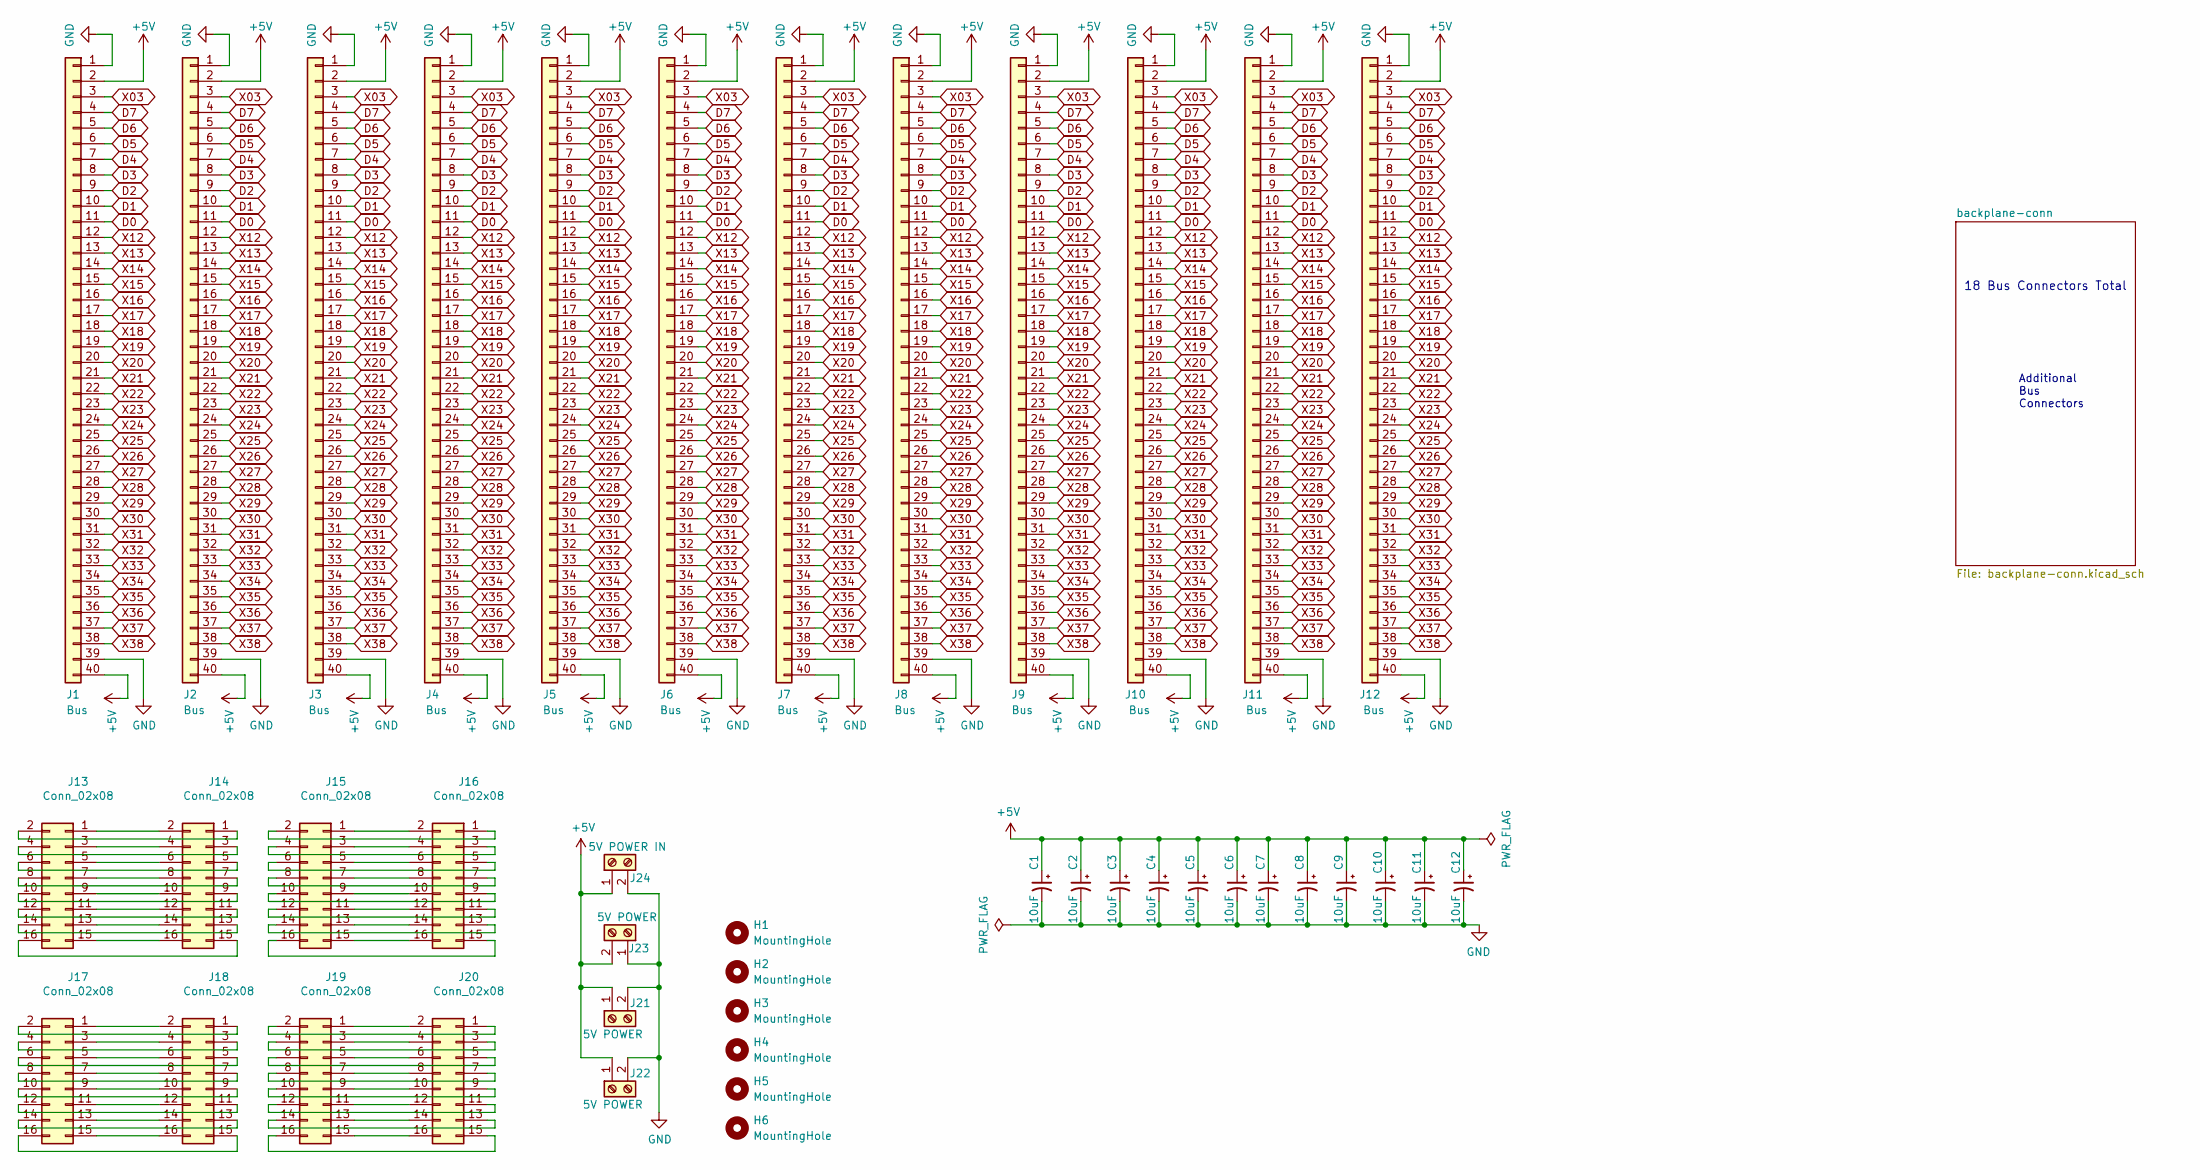
[picture p87: schematic backplane.kicad_sch, SAP-Plus Backplane]

Parts:
C1, C2, C3, C4, C5, C6, C7, C8, C9, C10, C11, C12: 10uF; C_Radial_D4.0mm_H5.0mm_P1.50mm
H1, H2, H3, H4, H5, H6: MountingHole; MountingHole_3.2mm_M3
J1, J2, J3, J4, J5, J6, J7, J8, J9, J10, J11, J12: Bus; PinSocket_1x40_P2.54mm_Vertical
J13, J14, J15, J16, J17, J18, J19, J20: Conn_02x08; PinSocket_2x08_P2.54mm_Vertical
J21, J22, J23: 5V POWER; TerminalBlock_RND_205-00012_1x02_P5.00mm_Horizontal
J24: 5V POWER IN; BarrelJack_Wuerth_6941xx301002

Connections:
+5V: C1.1, C2.1, C3.1, C4.1, C5.1, C6.1, C7.1, C8.1, C9.1, C10.1, C11.1, C12.1, J1.2, J1.40, J2.2, J2.40, J3.2, J3.40, J4.2, J4.40, J5.2, J5.40, J6.2, J6.40, J7.2, J7.40, J8.2, J8.40, J9.2, J9.40, J10.2, J10.40, J11.2, J11.40, J12.2, J12.40, J21.1, J22.1, J23.2, J24.1
D0: J1.11, J2.11, J3.11, J4.11, J5.11, J6.11, J7.11, J8.11, J9.11, J10.11, J11.11, J12.11
D1: J1.10, J2.10, J3.10, J4.10, J5.10, J6.10, J7.10, J8.10, J9.10, J10.10, J11.10, J12.10
D2: J1.9, J2.9, J3.9, J4.9, J5.9, J6.9, J7.9, J8.9, J9.9, J10.9, J11.9, J12.9
D3: J1.8, J2.8, J3.8, J4.8, J5.8, J6.8, J7.8, J8.8, J9.8, J10.8, J11.8, J12.8
D4: J1.7, J2.7, J3.7, J4.7, J5.7, J6.7, J7.7, J8.7, J9.7, J10.7, J11.7, J12.7
D5: J1.6, J2.6, J3.6, J4.6, J5.6, J6.6, J7.6, J8.6, J9.6, J10.6, J11.6, J12.6
D6: J1.5, J2.5, J3.5, J4.5, J5.5, J6.5, J7.5, J8.5, J9.5, J10.5, J11.5, J12.5
D7: J1.4, J2.4, J3.4, J4.4, J5.4, J6.4, J7.4, J8.4, J9.4, J10.4, J11.4, J12.4
GND: C1.2, C2.2, C3.2, C4.2, C5.2, C6.2, C7.2, C8.2, C9.2, C10.2, C11.2, C12.2, J1.1, J1.39, J2.1, J2.39, J3.1, J3.39, J4.1, J4.39, J5.1, J5.39, J6.1, J6.39, J7.1, J7.39, J8.1, J8.39, J9.1, J9.39, J10.1, J10.39, J11.1, J11.39, J12.1, J12.39, J21.2, J22.2, J23.1, J24.2
unnamed: J13.1, J14.2
unnamed: J13.2, J14.1
unnamed: J13.3, J14.4
unnamed: J13.4, J14.3
unnamed: J13.5, J14.6
unnamed: J13.6, J14.5
unnamed: J13.7, J14.8
unnamed: J13.8, J14.7
unnamed: J13.9, J14.10
unnamed: J13.10, J14.9
unnamed: J13.11, J14.12
unnamed: J13.12, J14.11
unnamed: J13.13, J14.14
unnamed: J13.14, J14.13
unnamed: J13.15, J14.16
unnamed: J13.16, J14.15
unnamed: J15.1, J16.2
unnamed: J15.2, J16.1
unnamed: J15.3, J16.4
unnamed: J15.4, J16.3
unnamed: J15.5, J16.6
unnamed: J15.6, J16.5
unnamed: J15.7, J16.8
unnamed: J15.8, J16.7
unnamed: J15.9, J16.10
unnamed: J15.10, J16.9
unnamed: J15.11, J16.12
unnamed: J15.12, J16.11
unnamed: J15.13, J16.14
unnamed: J15.14, J16.13
unnamed: J15.15, J16.16
unnamed: J15.16, J16.15
unnamed: J17.1, J18.2
unnamed: J17.2, J18.1
unnamed: J17.3, J18.4
unnamed: J17.4, J18.3
unnamed: J17.5, J18.6
unnamed: J17.6, J18.5
unnamed: J17.7, J18.8
unnamed: J17.8, J18.7
unnamed: J17.9, J18.10
unnamed: J17.10, J18.9
unnamed: J17.11, J18.12
unnamed: J17.12, J18.11
unnamed: J17.13, J18.14
unnamed: J17.14, J18.13
unnamed: J17.15, J18.16
unnamed: J17.16, J18.15
unnamed: J19.1, J20.2
unnamed: J19.2, J20.1
unnamed: J19.3, J20.4
unnamed: J19.4, J20.3
unnamed: J19.5, J20.6
unnamed: J19.6, J20.5
unnamed: J19.7, J20.8
unnamed: J19.8, J20.7
unnamed: J19.9, J20.10
unnamed: J19.10, J20.9
unnamed: J19.11, J20.12
unnamed: J19.12, J20.11
unnamed: J19.13, J20.14
unnamed: J19.14, J20.13
unnamed: J19.15, J20.16
unnamed: J19.16, J20.15
X03: J1.3, J2.3, J3.3, J4.3, J5.3, J6.3, J7.3, J8.3, J9.3, J10.3, J11.3, J12.3
X12: J1.12, J2.12, J3.12, J4.12, J5.12, J6.12, J7.12, J8.12, J9.12, J10.12, J11.12, J12.12
X13: J1.13, J2.13, J3.13, J4.13, J5.13, J6.13, J7.13, J8.13, J9.13, J10.13, J11.13, J12.13
X14: J1.14, J2.14, J3.14, J4.14, J5.14, J6.14, J7.14, J8.14, J9.14, J10.14, J11.14, J12.14
X15: J1.15, J2.15, J3.15, J4.15, J5.15, J6.15, J7.15, J8.15, J9.15, J10.15, J11.15, J12.15
X16: J1.16, J2.16, J3.16, J4.16, J5.16, J6.16, J7.16, J8.16, J9.16, J10.16, J11.16, J12.16
X17: J1.17, J2.17, J3.17, J4.17, J5.17, J6.17, J7.17, J8.17, J9.17, J10.17, J11.17, J12.17
X18: J1.18, J2.18, J3.18, J4.18, J5.18, J6.18, J7.18, J8.18, J9.18, J10.18, J11.18, J12.18
X19: J1.19, J2.19, J3.19, J4.19, J5.19, J6.19, J7.19, J8.19, J9.19, J10.19, J11.19, J12.19
X20: J1.20, J2.20, J3.20, J4.20, J5.20, J6.20, J7.20, J8.20, J9.20, J10.20, J11.20, J12.20
X21: J1.21, J2.21, J3.21, J4.21, J5.21, J6.21, J7.21, J8.21, J9.21, J10.21, J11.21, J12.21
X22: J1.22, J2.22, J3.22, J4.22, J5.22, J6.22, J7.22, J8.22, J9.22, J10.22, J11.22, J12.22
X23: J1.23, J2.23, J3.23, J4.23, J5.23, J6.23, J7.23, J8.23, J9.23, J10.23, J11.23, J12.23
X24: J1.24, J2.24, J3.24, J4.24, J5.24, J6.24, J7.24, J8.24, J9.24, J10.24, J11.24, J12.24
X25: J1.25, J2.25, J3.25, J4.25, J5.25, J6.25, J7.25, J8.25, J9.25, J10.25, J11.25, J12.25
X26: J1.26, J2.26, J3.26, J4.26, J5.26, J6.26, J7.26, J8.26, J9.26, J10.26, J11.26, J12.26
X27: J1.27, J2.27, J3.27, J4.27, J5.27, J6.27, J7.27, J8.27, J9.27, J10.27, J11.27, J12.27
X28: J1.28, J2.28, J3.28, J4.28, J5.28, J6.28, J7.28, J8.28, J9.28, J10.28, J11.28, J12.28
X29: J1.29, J2.29, J3.29, J4.29, J5.29, J6.29, J7.29, J8.29, J9.29, J10.29, J11.29, J12.29
X30: J1.30, J2.30, J3.30, J4.30, J5.30, J6.30, J7.30, J8.30, J9.30, J10.30, J11.30, J12.30
X31: J1.31, J2.31, J3.31, J4.31, J5.31, J6.31, J7.31, J8.31, J9.31, J10.31, J11.31, J12.31
X32: J1.32, J2.32, J3.32, J4.32, J5.32, J6.32, J7.32, J8.32, J9.32, J10.32, J11.32, J12.32
X33: J1.33, J2.33, J3.33, J4.33, J5.33, J6.33, J7.33, J8.33, J9.33, J10.33, J11.33, J12.33
X34: J1.34, J2.34, J3.34, J4.34, J5.34, J6.34, J7.34, J8.34, J9.34, J10.34, J11.34, J12.34
X35: J1.35, J2.35, J3.35, J4.35, J5.35, J6.35, J7.35, J8.35, J9.35, J10.35, J11.35, J12.35
X36: J1.36, J2.36, J3.36, J4.36, J5.36, J6.36, J7.36, J8.36, J9.36, J10.36, J11.36, J12.36
X37: J1.37, J2.37, J3.37, J4.37, J5.37, J6.37, J7.37, J8.37, J9.37, J10.37, J11.37, J12.37
X38: J1.38, J2.38, J3.38, J4.38, J5.38, J6.38, J7.38, J8.38, J9.38, J10.38, J11.38, J12.38

Notes on the sheet:
Additional Bus Connectors
18 Bus Connectors Total

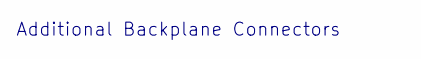
[picture p88: schematic backplane-conn.kicad_sch, SAP-Plus blackplane connectors]

Notes on the sheet:
Additional Backplane Connectors

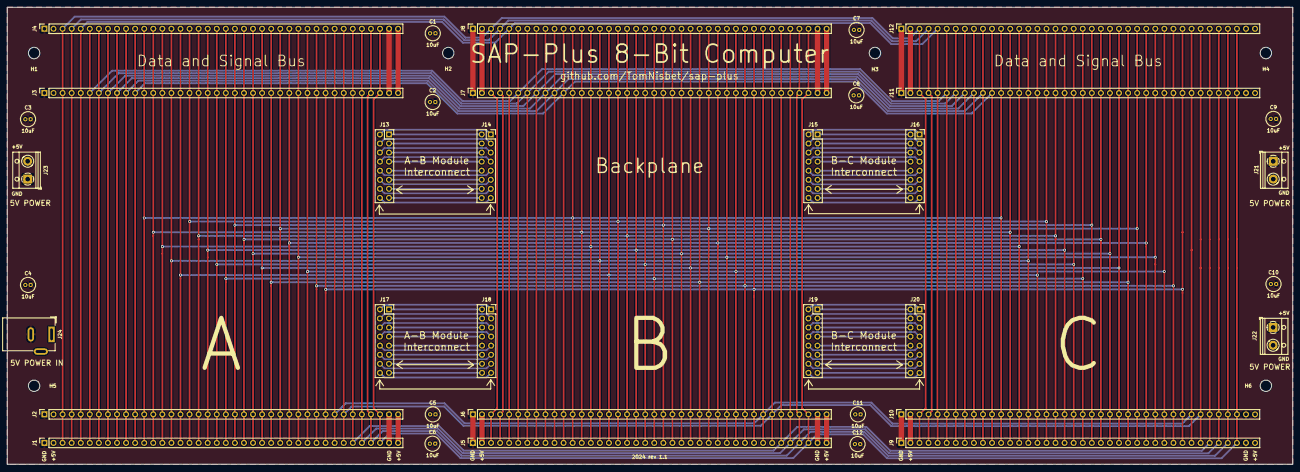
[picture p89: board backplane.kicad_pcb from above]

Board: 2 copper layers, 360.0 x 128.0 mm, 42 parts (0 on the bottom side), 102 nets.
