TomNisbet/sap-plus/schematics/bus-leds/bus-leds.kicad_pcb

## KiCad design schematics/bus-leds/bus-leds.kicad_pcb (2024-11-30)

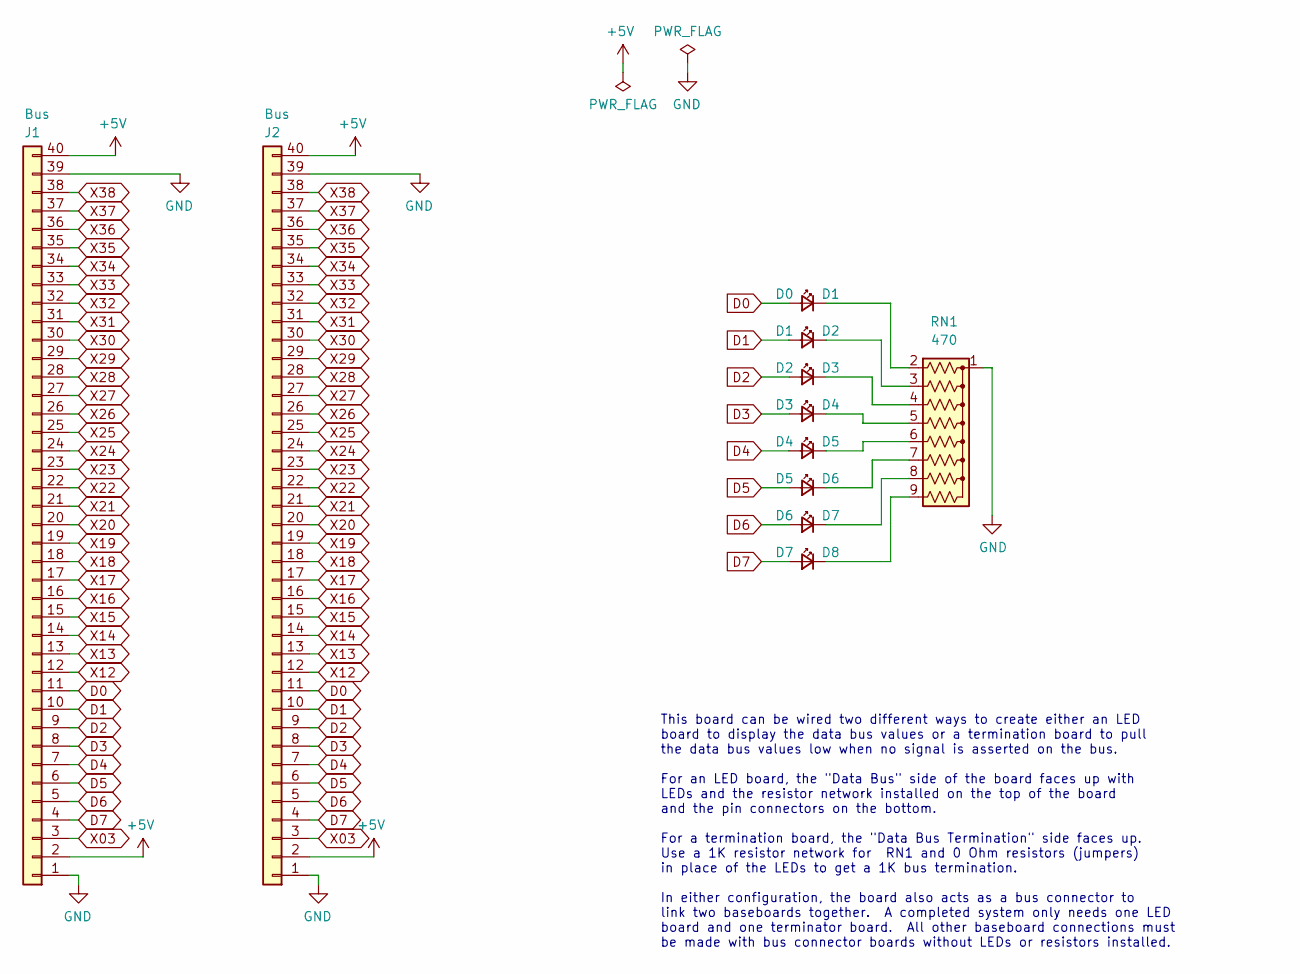
[picture p90: schematic bus-leds.kicad_sch, SAP-Plus Bus LED connector]

Parts:
D1: D0; LED_D3.0mm
D2: D1; LED_D3.0mm
D3: D2; LED_D3.0mm
D4: D3; LED_D3.0mm
D5: D4; LED_D3.0mm
D6: D5; LED_D3.0mm
D7: D6; LED_D3.0mm
D8: D7; LED_D3.0mm
J1, J2: Bus; PinHeader_1x40_P2.54mm_Vertical
RN1: 470; R_Array_SIP9

Connections:
+5V: J1.2, J1.40, J2.2, J2.40
D0: D1.2 (A), J1.11, J2.11
D1: D2.2 (A), J1.10, J2.10
D2: D3.2 (A), J1.9, J2.9
D3: D4.2 (A), J1.8, J2.8
D4: D5.2 (A), J1.7, J2.7
D5: D6.2 (A), J1.6, J2.6
D6: D7.2 (A), J1.5, J2.5
D7: D8.2 (A), J1.4, J2.4
GND: J1.1, J1.39, J2.1, J2.39, RN1.1 (common)
unnamed: D1.1 (K), RN1.2 (R1)
unnamed: D2.1 (K), RN1.3 (R2)
unnamed: D3.1 (K), RN1.4 (R3)
unnamed: D4.1 (K), RN1.5 (R4)
unnamed: D5.1 (K), RN1.6 (R5)
unnamed: D6.1 (K), RN1.7 (R6)
unnamed: D7.1 (K), RN1.8 (R7)
unnamed: D8.1 (K), RN1.9 (R8)
X03: J1.3, J2.3
X12: J1.12, J2.12
X13: J1.13, J2.13
X14: J1.14, J2.14
X15: J1.15, J2.15
X16: J1.16, J2.16
X17: J1.17, J2.17
X18: J1.18, J2.18
X19: J1.19, J2.19
X20: J1.20, J2.20
X21: J1.21, J2.21
X22: J1.22, J2.22
X23: J1.23, J2.23
X24: J1.24, J2.24
X25: J1.25, J2.25
X26: J1.26, J2.26
X27: J1.27, J2.27
X28: J1.28, J2.28
X29: J1.29, J2.29
X30: J1.30, J2.30
X31: J1.31, J2.31
X32: J1.32, J2.32
X33: J1.33, J2.33
X34: J1.34, J2.34
X35: J1.35, J2.35
X36: J1.36, J2.36
X37: J1.37, J2.37
X38: J1.38, J2.38

Notes on the sheet:
This board can be wired two different ways to create either an LED board to display the data bus values or a termination board to pull the data bus values low when no signal is asserted on the bus. For an LED board, the "Data Bus" side of the board faces up with LEDs and the resistor network instal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

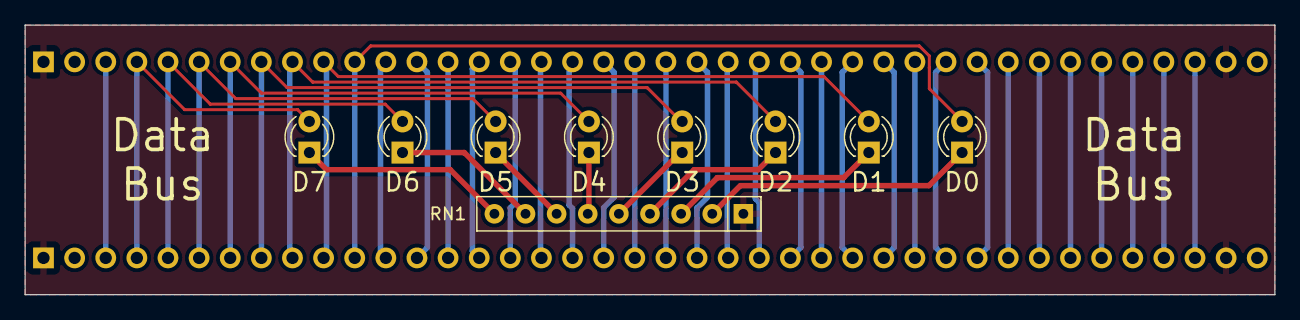
[picture p91: board bus-leds.kicad_pcb from above]

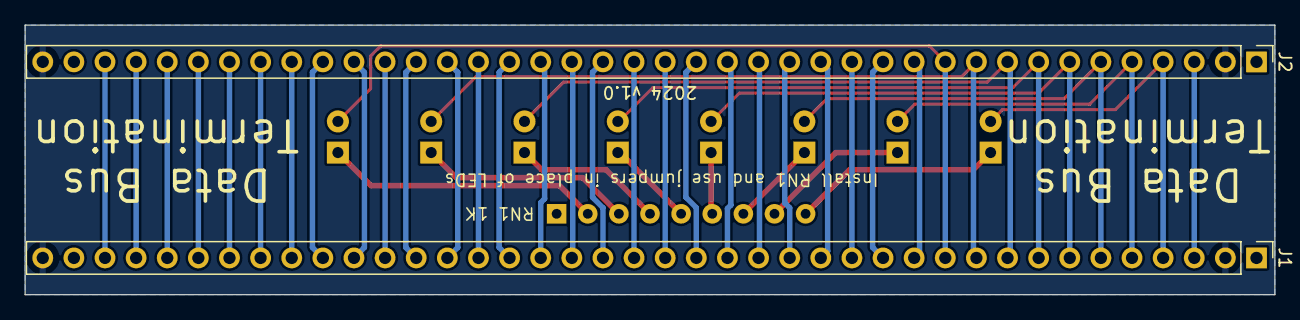
[picture p92: board bus-leds.kicad_pcb from below]

Board: 2 copper layers, 102.0 x 22.0 mm, 11 parts (2 on the bottom side), 46 nets.
