TomNisbet/sap-plus/(commit log)

2024-10-16 add instruction list and tools to docs
    [instruction-set.csv]
2024-10-30 add arduino-loader and docs for laoder and backplane
    [in-general.csv]
2024-11-28 add microcode, update loader OLED
    [instruction-set.csv]
2024-11-30 Add schematics for bus-connect and module template
    [bus-connect.kicad_pcb, bus-connect.kicad_sch, bus-leds.kicad_pcb, bus-leds.kicad_sch, template.kicad_pcb, template.kicad_sch]
2024-11-30 add backplane schematic
    [backplane-conn.kicad_sch, backplane-conn.sch, backplane.kicad_pcb, backplane.kicad_sch]
2024-11-30 add clock and output register schematics
    [clock.kicad_pcb, clock.kicad_sch, output.kicad_pcb, output.kicad_sch]
2024-12-01 add microcode module schematic
    [microcode.kicad_pcb, microcode.kicad_sch]
2024-12-01 add RAM and MAR module schematic
    [ram-mar.kicad_pcb, ram-mar.kicad_sch]
2024-12-01 add AB register module schematics
    [ab-register.kicad_pcb, ab-register.kicad_sch, backplane-conn.sch]
2024-12-01 add PC and SP module schematics
    [pc-sp.kicad_pcb, pc-sp.kicad_sch]
2024-12-01 Add Instruction Resister and Step Counter schematics
    [ir-sc.kicad_pcb, ir-sc.kicad_sch]
2024-12-01 Add Loader Module scematics
    [loader.kicad_pcb, loader.kicad_sch]
2024-12-01 Add ALU Module schematics
    [alu.kicad_pcb, alu.kicad_sch]
2024-12-01 swap labels on Clock Module RUN/SSTOP switch
    [clock.kicad_pcb, clock.kicad_sch]
2024-12-06 Change Loader reset button
    [loader.kicad_pcb, loader.kicad_sch]
2024-12-13 add schematic images to docs
2024-12-27 update template schematic and docs with interconnect notes
    [template.kicad_sch]
2025-01-10 fix microcode bugs
    [in-general.csv, instruction-set.csv]
2025-01-21 fix subtraction and compare instruction descriptions
    [instruction-set.csv]
2025-01-22 create worlds worst assembler
2025-01-23 assembler and test program updates
2025-01-24 swap SP count direction; add CYN instruction
    [instruction-set.csv]
2025-01-27 move loader asm examples to separate files; add instruction aliases and new LAX,SAX,DCS,INS instructions
    [instruction-set.csv]
2025-01-27 fix broken conditional branch instructions
    [instruction-set.csv]
2025-02-01 typo in ADI description
    [instruction-set.csv]
2025-02-01 add Demo Mode to the Arduino Loader
2025-02-03 move the utilities to the top-level directory and add docs for it
    [instruction-set.csv]
2025-05-24 clock module 2.0 - adds clock divider
    [clock.kicad_pcb, clock.kicad_sch]
2025-05-28 document the version 2.0 clock module
    [clock.kicad_sch]
2025-07-17 Memory Loader version 3.0
    [memory-loader-interface-B_Cu.gbl, memory-loader-interface-B_Mask.gbs, memory-loader-interface-B_Paste.gbp, memory-loader-interface-B_Silkscreen.gbo, memory-loader-interface-Edge_Cuts.gm1, memory-loader-interface-F_Cu.gtl, memory-loader-interface-F_Mask.gts, memory-loader-interface-F_Paste.gtp]
2025-07-20 typo in DCS and INS instruction descriptions
    [instruction-set.csv]
2025-07-20 Arduino Loader Module v1.2 schematics and code
    [loader.kicad_pcb, loader.kicad_sch]
